Juan100205/IOTPROYECTOFINAL3CORTE/wiki/2.5.-Esquemático-de-Hardware.md

# 2.5. Esquemático de hardware

## 2.5.1. Lista de componentes

| # | Componente | Variable / función | Interfaz | Alimentación | Justificación |
|---|---|---|---|---|---|
| 1 | ESP32 DevKit V1 (WROOM-32, CP2102, 30 pines) | Procesamiento, WiFi y servidor web | — | USB 5 V → regulador 3,3 V | Doble núcleo Xtensa LX6 hasta 240 MHz y WiFi 802.11 b/g/n integrado [8], [23] |
| 2 | HC-SR04 | Nivel por ultrasonido | GPIO digital + ISR | **5 V (VIN)** | Sensor de nivel de bajo costo, validado en sistemas IoT de agua en zonas rurales [35], [36] |
| 3 | MD-PS002 + HX710B | Nivel por presión hidrostática | Serie de 2 hilos (24 bits) | 3,3 V | Segunda fuente de nivel, con un principio físico distinto (§[2.3.2](2.3.-Desarrollo-Teórico-Modular)) |
| 4 | DS18B20 sumergible | Temperatura del agua | 1-Wire | 3,3 V + pull-up de 4,7 kΩ | Encapsulado impermeable y resolución de 12 bits (0,0625 °C) [36] |
| 5 | DHT11 | Temperatura y HR del aire | Digital propietario | 3,3 V | Bajo costo; su HR alimenta el cálculo de $e_a$ [9] |
| 6 | BMP280 (opcional) | Presión atmosférica | I2C 0x76/0x77 [29] | 3,3 V | Aporta el término de presión de la evaporación (§2.3.4) |
| 7 | Fotoresistencia (LDR) + resistencia de divisor | Radiación / luminosidad relativa | ADC1 (GPIO34) | 3,3 V | Proxy de bajo costo de la radiación solar |
| 8 | OLED SSD1306 128×64 | Visualización in situ | I2C 0x3C [29] | 3,3 V | Legible a pleno sol y sin retroiluminación |
| 9 | LEDs verde, amarillo y rojo + 3 resistencias de 220 Ω | Estado del sistema | GPIO | — | Semáforo reconocible por cualquier persona |
| 10 | Buzzer activo | Alarma sonora | GPIO | 3,3 V | Alarma física exigida por el enunciado |
| 11 | Pulsador | Silenciar la alarma in situ | GPIO + ISR, pull-up interno | — | Acción local sin depender de la red |
| 12 | Resistencias de 1 kΩ y 2 kΩ | Divisor en el ECHO | — | — | Baja 5 V a ≈3,3 V para proteger el GPIO26 [8] |

## 2.5.2. Tabla de interconexión (pinout)

En la placa, el número después de la "D" es el número de GPIO. Los GPIO 16 y 17 aparecen rotulados como **RX2** y **TX2**.

| Componente | Pin del componente | GPIO ESP32 | Nota |
|---|---|---|---|
| OLED SSD1306 | SDA / SCK | 21 / 22 | Bus I2C compartido |
| BMP280 | SDA / SCL | 21 / 22 | Mismo bus I2C; se detecta en 0x76 o 0x77 |
| HC-SR04 | TRIG | 25 | Salida |
| HC-SR04 | ECHO | 26 | **Por el divisor de 1 kΩ / 2 kΩ**; ISR `CHANGE` |
| HX710B (MD-PS002) | OUT (DT) / SCK | 32 / 33 | OUT con `INPUT_PULLUP`: si se desconecta, queda en "sin dato" |
| DHT11 | DATA | 4 | |
| DS18B20 | DATA | 27 | Pull-up de 4,7 kΩ a 3,3 V |
| Fotoresistencia | Punto medio del divisor | 34 | ADC1, solo entrada, atenuación de 11 dB (0–3,3 V) |
| LED verde / amarillo / rojo | Ánodo, por 220 Ω | 16 (RX2) / 17 (TX2) / 19 | |
| Buzzer | + | 23 | Conexión directa (activo) |
| Botón | Un terminal (el otro a GND) | 18 | ISR `FALLING`, antirrebote de 250 ms |

**Pines evitados a propósito:** 0, 2, 12 y 15 (pines de arranque, *strapping*) y todo el **ADC2**, que no puede usarse mientras el WiFi está activo [8].

## 2.5.3. Esquemático de conexión

```mermaid
flowchart LR
  subgraph ESP["ESP32 DevKit V1"]
    V33["3V3"]
    VIN["VIN 5V"]
    GND["GND"]
    G21["GPIO21 SDA"]
    G22["GPIO22 SCL"]
    G25["GPIO25"]
    G26["GPIO26"]
    G32["GPIO32"]
    G33["GPIO33"]
    G4["GPIO4"]
    G27["GPIO27"]
    G34["GPIO34 ADC1"]
    G16["GPIO16 RX2"]
    G17["GPIO17 TX2"]
    G19["GPIO19"]
    G23["GPIO23"]
    G18["GPIO18"]
  end

  OLED["OLED SSD1306"] --- G21 & G22
  BMP["BMP280"] --- G21 & G22
  HC["HC-SR04"] -- "TRIG" --- G25
  HC -- "ECHO" --> DIV["Divisor 1k / 2k"] --> G26
  HC -- "VCC" --- VIN
  HX["MD-PS002 + HX710B"] -- "OUT" --- G32
  HX -- "SCK" --- G33
  DHT["DHT11"] --- G4
  DS["DS18B20"] --- G27
  DS -. "pull-up 4,7k" .- V33
  LDR["LDR + resistencia"] --- G34
  LV["LED verde + 220"] --- G16
  LA["LED amarillo + 220"] --- G17
  LR["LED rojo + 220"] --- G19
  BZ["Buzzer"] --- G23
  BT["Botón a GND"] --- G18
```

> **Pendiente del equipo:** reemplazar o complementar este diagrama con el esquemático gráfico exportado de Fritzing, EasyEDA o Wokwi del montaje v8. Esta tabla de pines es la fuente para dibujarlo. Los pines del primer corte (Arduino Uno) están en la [wiki del Challenge #1](https://github.com/LeMarsito02/IOTPROYECTOFINAL1CORTE/wiki/2.-Solución-Propuesta).

## 2.5.4. Consideraciones eléctricas

- **Niveles lógicos.** El ESP32 trabaja a 3,3 V y sus GPIO no toleran 5 V [8]. El único sensor alimentado a 5 V es el HC-SR04, porque su transmisor lo necesita. Su ECHO pasa por el divisor $V_{out} = 5\,\text{V}\cdot\frac{2\,\text{k}\Omega}{1\,\text{k}\Omega+2\,\text{k}\Omega} = 3{,}33\,\text{V}$.
- **Corriente por los LEDs.** Con 220 Ω y un LED rojo (≈2 V): $I = (3{,}3-2)/220 \approx 5{,}9\,\text{mA}$, dentro de la capacidad de un GPIO [8].
- **I2C.** La OLED y el BMP280 comparten el bus a 3,3 V. Los módulos traen resistencias de pull-up integradas [29]. El firmware escanea el bus al arrancar e informa por Serial las direcciones encontradas.
- **Tara del MD-PS002.** Hay que encender con la manguera fuera del agua. Las 15 primeras lecturas definen el "0 cm" (§2.3.2b).

## 2.5.5. Montaje físico

El nodo se integra en una carcasa de **MDF de 3 mm cortada con láser** (≈ 150 × 110 × 56 mm). Cada elemento queda donde cumple su función: la OLED y el panel solar en la tapa, visibles desde arriba; los LEDs y el botón al frente; el HC-SR04 en la base, apuntando al agua; y la ventilación en tres caras, para que el calor de la electrónica no altere el DHT11 ni el BMP280. Diseño, cotas y criterios de fabricación en la [sección 2.8](2.8.-Diseño-Mecánico-Carcasa-y-Empaque).

| Nodo WaterGuard v9 en su carcasa | Nodo en su empaque |
|---|---|
| **Figura 1.** Nodo WaterGuard v9 ensamblado en la carcasa de MDF: OLED y panel solar en la tapa; LEDs de estado, botón de silencio y rejilla de ventilación al frente.\* | **Figura 2.** El nodo en su empaque, con el inserto, el cable USB y el manual de usuario.\* |

\* Fotos reales mejoradas con Gemini ([sección 9](9.-Uso-de-Herramientas-de-Inteligencia-Artificial)). Los textos impresos en la caja no son especificaciones válidas ([2.8.4](2.8.-Diseño-Mecánico-Carcasa-y-Empaque)).
