Juan100205/IOTPROYECTOFINAL3CORTE/wiki/2.1.-Restricciones-de-Diseño.md

# 2.1. Restricciones de diseño identificadas

Las restricciones salen de tres fuentes: el enunciado del Challenge #2, el contexto de la Sabana Centro [1]–[4] y las limitaciones reales del hardware disponible. Cada una tiene una decisión de diseño asociada, con la que se puede verificar en las pruebas ([Configuración experimental y resultados](3.-Configuración-Experimental,-Resultados-y-Análisis)).

## 2.1.1. Técnicas

| ID | Restricción | Fuente | Decisión de diseño |
|---|---|---|---|
| T1 | Microcontrolador embebido, **no Raspberry Pi** (Challenge #2; en la v9 la reemplaza T12) | Enunciado, restricción 1 | ESP32 DevKit V1 (WROOM-32): doble núcleo, WiFi integrado, ADC de 12 bits [8] |
| T2 | La medición debe ejecutarse en una **ISR o en un hilo distinto al principal** | Enunciado, restricción 1 | ISR del pin ECHO + 3 tareas FreeRTOS en el núcleo 1; el `loop()` solo atiende la web |
| T3 | **Alarma física** y visualización en tiempo real en el dispositivo | Enunciado, restricción 2 | LEDs verde/amarillo/rojo, buzzer, OLED SSD1306 de 2 páginas y botón de silencio |
| T4 | Tablero en **servidor web embebido**, conectado a la WLAN de la Alcaldía | Enunciado, restricción 3 | `WebServer` HTTP en el puerto 80 del propio ESP32; mDNS `waterguard.local` |
| T5 | Acceso **solo a dispositivos autorizados de la WLAN** | Enunciado, restricción 3 | 3 capas: WPA2, filtro de subred con lista blanca opcional y login SHA-256 con sesión atada a IP |
| T6 | **Sin MQTT** (Challenge #2; en la v9 la reemplaza T13) | Enunciado, restricción 3 | API REST propia (`/api/estado`, `/api/historial`, `/api/alarma`) consultada por *polling* cada 2 s |
| T7 | El tablero debe mostrar **valor actual, histórico reciente, notificaciones** y permitir **desactivar alarmas** | Enunciado, requisitos mínimos | Histórico circular de 15 min, registro de 25 eventos, botón silenciar/rearmar |
| T8 | La WLAN puede **no tener salida a internet** | Contexto rural | Página autocontenida: sin CDN ni librerías externas; gráficas en `<canvas>` |
| T9 | Lógica de **3,3 V** del ESP32 y **ADC2 inutilizable con WiFi activo** | Manual técnico [8] | Divisor 1 kΩ/2 kΩ en el ECHO de 5 V; fotoresistencia en el GPIO34 (ADC1); se evitan los pines de arranque 0, 2, 12 y 15 |
| T10 | El MD-PS002 entrega **milivoltios** (puente de Wheatstone) | Hoja de datos del sensor | Etapa de amplificación HX710B/HX711 de 24 bits |
| T11 | Tolerancia a **fallas de sensores** | Robustez del servicio | Fuentes redundantes de nivel, normalización sobre los sensores disponibles, estados `DEGRADADO` y `ERROR` |
| T12 | Microcontrolador + **Raspberry Pi como Gateway IoT**; medición y **transmisión** en ISR o hilos (Challenge #3) | Enunciado, restricción 1 | Raspberry Pi 5 como Gateway; tarea FreeRTOS `tMQTT` en el núcleo 0 para la transmisión |
| T13 | **MQTT** nodo ↔ Gateway y Gateway ↔ nube | Enunciado, restricción 2 | Mosquitto en la Raspberry Pi; MQTT sobre WebSockets con TLS hacia LeMarTek Cloud (ThingsBoard) [56], [60] |
| T14 | Datos **almacenados en una BD local antes** de la plataforma IoT | Enunciado, restricción 1 | SQLite con reenvío diferido desde la base y alerta crítica si una escritura falla ([2.2.0](2.2.-Arquitectura-Propuesta)) |
| T15 | Tablero **global**, accesible desde cualquier parte de Colombia solo para usuarios autorizados | Enunciado, restricción 4 | LeMarTek Cloud con usuarios por rol, doble factor y túnel de Cloudflare |
| T16 | Módulo de **IA** con uso justificado | Enunciado, restricción 5 | Claude con salida estructurada y respaldo estadístico local |

## 2.1.2. Económicas

| ID | Restricción | Decisión |
|---|---|---|
| E1 | El reto pide un sistema de **bajo costo** | Sensores de prototipado rápido (HC-SR04, DHT11, DS18B20, BMP280); el ESP32 cuesta menos que un Arduino con módulo WiFi externo |
| E2 | Replicable en muchos puntos (tanques veredales) | Sin licencias ni servicios en la nube: el tablero no tiene costo recurrente |
| E3 | Presupuesto estudiantil | Banco de pruebas con materiales reciclados (nevera de icopor, papel aluminio, bombillo halógeno, ventilador) |
| E4 | Carcasa y empaque de bajo costo (Challenge #3) | Carcasa en MDF de 3 mm cortado con láser (COP 35.000) en lugar de impresión 3D, y caja de cartón (COP 10.000) ([2.8](2.8.-Diseño-Mecánico-Carcasa-y-Empaque)) |

El detalle de costos está en [Modelo de negocio](2.7.-Modelo-de-Negocio).

## 2.1.3. Regulatorias y de seguridad

| ID | Restricción | Decisión |
|---|---|---|
| R1 | Uso de la banda ICM de **2,4 GHz**, de uso libre en Colombia según la Resolución 105 de 2020 de la Agencia Nacional del Espectro (ANE) [62] | El ESP32 opera en modo estación IEEE 802.11 b/g/n [23] y no emite en bandas licenciadas |
| R2 | **Gestión del riesgo** municipal (Ley 1523 de 2012 [30]) y **uso eficiente del agua** (Ley 373 de 1997 [31]) | El sistema entrega información para decidir racionamientos; **no** acciona válvulas por sí solo, la decisión queda en la autoridad |
| R3 | Protección de datos (Ley 1581 de 2012 [32]) | El sistema no almacena datos personales; solo guarda la IP de quien accede, en memoria volátil, como registro de seguridad |
| R4 | Acceso restringido al tablero | Se siguen RFC 6265 [25] (cookie `HttpOnly`), FIPS 180-4 [26] (SHA-256) y las recomendaciones de OWASP ASVS [28] |

## 2.1.4. De espacio y de instalación

- El nodo debe caber junto a un tanque doméstico o comunitario. El HC-SR04 va en la tapa (mide desde arriba) y la manguera del MD-PS002 llega al fondo.
- Distancia mínima de medición del HC-SR04: ≈2 cm (zona ciega). Por eso el firmware descarta lecturas por debajo de 2 cm y por encima de 400 cm.
- Parámetro `ALTURA_TANQUE = 100 cm` en el prototipo. En campo se ajusta a la geometría real.
- La carcasa del nodo mide **≈ 150 × 110 × 56 mm**. El HC-SR04 sale por la base (2 orificios de Ø 17 mm) para medir hacia el agua, y la ventilación va en tres caras para que el calor interno no altere el DHT11 ni el BMP280 ([2.8.2](2.8.-Diseño-Mecánico-Carcasa-y-Empaque)).

## 2.1.5. De escalabilidad

- Un nodo = un punto de almacenamiento. Varios nodos pueden convivir en la misma WLAN, cada uno con su propio tablero y nombre mDNS.
- La API JSON permite, a futuro, que un agregador municipal consulte varios nodos sin rediseñar el firmware (ver [Conclusiones](5.-Conclusiones,-Retos-del-Desarrollo,-Trabajo-Futuro-y-Referencias), trabajo futuro).
- La memoria RAM limita el histórico a 180 muestras (15 min cada 5 s). Guardar más requeriría una tarjeta SD o memoria flash externa.

## 2.1.6. Temporales

- Entrega de la documentación: **28 de septiembre de 2026**. Sustentación: **29 de septiembre de 2026**.
- El prototipo debe mostrar los eventos en minutos, no en días. Por eso los umbrales de descenso (1 y 3 %/min) están **escalados** al banco de pruebas y se documentan como parámetros a recalibrar en campo ([Desarrollo teórico](2.3.-Desarrollo-Teórico-Modular) §2.3.3).
- La v8 se construyó sobre la v7 del primer corte para no perder la lógica ya validada.
- **Challenge #3:** entrega de la wiki el **9 de noviembre de 2026** y sustentación el **10 de noviembre**. Con ≈ 7 h de impresión por carcasa no había margen para reimprimir, y por eso se cambió a corte láser, con el que una iteración cabe en el mismo día ([Acta #2](7.1.-Actas-de-Reunión-y-Evaluación)).

## 2.1.7. Ambientales

| ID | Restricción | Decisión |
|---|---|---|
| A1 | Reducir el impacto ambiental de la carcasa del prototipo | MDF (fibra de madera) en lugar de termoplásticos de origen fósil (PETG/ASA). El MDF lleva resinas aglomerantes, así que se presenta como una opción de menor impacto, no como 100 % biodegradable |
| A2 | Empaque reciclable | Caja de cartón corrugado tipo *mailer* con inserto del mismo material |
| A3 | Exposición a la humedad junto al tanque | El MDF no es resistente al agua: la carcasa va sobre el tanque, no dentro de él, y en producción se sella o se cambia a ASA ([2.8.5](2.8.-Diseño-Mecánico-Carcasa-y-Empaque)) |
