Juan100205/IOTPROYECTOFINAL3CORTE/wiki/6.-Anexos.md

# 6. Anexos

## Anexo A. Código fuente documentado

**WaterGuard v9 (Challenge #3):**

| Carpeta / archivo | Contenido |
|---|---|
| [`codigo/WaterGuard_v9/`](https://github.com/Juan100205/IOTPROYECTOFINAL3CORTE/tree/main/codigo/WaterGuard_v9) | Firmware v9 del ESP32: v8 + tarea `tMQTT`, cola offline, LWT, comandos e IA |
| [`codigo/gateway/waterguard_gw.py`](https://github.com/Juan100205/IOTPROYECTOFINAL3CORTE/blob/main/codigo/gateway/waterguard_gw.py) | Servicio del Gateway: MQTT local → validación → SQLite (con alerta por falla) → nube, e hilo de IA |
| [`codigo/gateway/basedatos.py`](https://github.com/Juan100205/IOTPROYECTOFINAL3CORTE/blob/main/codigo/gateway/basedatos.py) | Esquema y consultas de SQLite |
| [`codigo/gateway/plataforma.py`](https://github.com/Juan100205/IOTPROYECTOFINAL3CORTE/blob/main/codigo/gateway/plataforma.py) | Conexión MQTT con LeMarTek Cloud (ThingsBoard) o Ubidots, y RPC de la alarma |
| [`codigo/gateway/ia_claude.py`](https://github.com/Juan100205/IOTPROYECTOFINAL3CORTE/blob/main/codigo/gateway/ia_claude.py) | Módulo de IA: base estadística y Claude con salida estructurada |
| [`codigo/gateway/config.py`](https://github.com/Juan100205/IOTPROYECTOFINAL3CORTE/blob/main/codigo/gateway/config.py) · [`waterguard.env.ejemplo`](https://github.com/Juan100205/IOTPROYECTOFINAL3CORTE/blob/main/codigo/gateway/waterguard.env.ejemplo) | Configuración del Gateway |
| [`codigo/gateway/simulador_nodo.py`](https://github.com/Juan100205/IOTPROYECTOFINAL3CORTE/blob/main/codigo/gateway/simulador_nodo.py) | Simulador del ESP32 para probar sin hardware |
| [`codigo/gateway/pruebas/`](https://github.com/Juan100205/IOTPROYECTOFINAL3CORTE/tree/main/codigo/gateway/pruebas) | Pruebas automatizadas (P3) |
| [`codigo/raspberry/`](https://github.com/Juan100205/IOTPROYECTOFINAL3CORTE/tree/main/codigo/raspberry) | SD autoconfigurable (cloud-init), Mosquitto con ACL y servicio `systemd` |

**Versiones anteriores:**

- Firmware v8 (ESP32): [`WaterGuard_v8.ino`](https://github.com/Juan100205/IOTPROYECTOFINAL3CORTE/blob/main/codigo/WaterGuard_v8/WaterGuard_v8.ino). Cada módulo tiene su bloque de comentarios con el propósito y las decisiones de diseño.
- Firmware v7 (Arduino Uno, primer corte): [`WaterGuard_v7.ino`](https://github.com/Juan100205/IOTPROYECTOFINAL3CORTE/blob/main/codigo/WaterGuard_v7/WaterGuard_v7.ino). El código v7 comentado completo está en el [Anexo A de la wiki del Challenge #1](https://github.com/LeMarsito02/IOTPROYECTOFINAL1CORTE/wiki/6.-Anexos).

### Mapa de módulos del firmware v8

| Módulo | Funciones | Documentado en |
|---|---|---|
| Configuración | Constantes de red, pines y umbrales | [2.3.7](2.3.-Desarrollo-Teórico-Modular), [2.5](2.5.-Esquemático-de-Hardware) |
| ISR | `isrEcho`, `isrBoton` | [2.4.3](2.4.-Diagramas-UML) |
| Sensores | `medirDistanciaUnaVez`, `medirDistancia`, `leerHX710B`, `tareaSensores` | [2.3.2](2.3.-Desarrollo-Teórico-Modular), [2.4.5](2.4.-Diagramas-UML) |
| Analítica | `agregarNivel`, `calcularDescenso`, `presionSaturacion`, `calcularEvaporacion`, `calcularIRH`, `detectarAnomalia`, `calcularEstado`, `tareaAnalitica` | [2.3](2.3.-Desarrollo-Teórico-Modular), [2.4.6](2.4.-Diagramas-UML) |
| Salidas | `actualizarOLED`, `tareaSalidas` | [2.4.7](2.4.-Diagramas-UML) |
| Seguridad | `sha256Hex`, `igualesTiempoConstante`, `crearSesion`, `buscarSesion`, `ipBloqueada`, `clienteEnRedLocal`, `filtroRed`, `autorizado` | [2.2.4](2.2.-Arquitectura-Propuesta), [2.6.2](2.6.-Estándares-de-Ingeniería) |
| Web | `handleLoginPost`, `handleEstado`, `handleHistorial`, `handleAlarma`, `LOGIN_HTML`, `DASH_HTML` | Anexo B |
| Red | `conectarWiFi`, `revisarWiFi` | [2.2](2.2.-Arquitectura-Propuesta) |

## Anexo B. API REST del tablero

Todas las rutas pasan por `filtroRed()`. Las marcadas con 🔒 exigen además una sesión válida.

| Método | Ruta | Descripción | Respuesta |
|---|---|---|---|
| GET | `/login` | Formulario de ingreso | HTML |
| POST | `/login` | `usuario`, `clave` | 302 a `/` con cookie, o a `/login?e=1` (clave errada) o `?e=2` (IP bloqueada) |
| POST | `/logout` | Cierra la sesión | `{"ok":true}` |
| GET 🔒 | `/` | Tablero | HTML autocontenido con `<canvas>` |
| GET 🔒 | `/api/estado` | Estado, IRH, evaporación, DPV, descenso, reglas, sensores, valores y eventos | JSON |
| GET 🔒 | `/api/historial` | 180 muestras (paso de 5 s) de nivel, tAgua, tAmb, hum, pres, lum, evap, irh y colAgua | JSON |
| POST 🔒 | `/api/alarma` | `accion=silenciar` o `accion=rearmar` | `{"sil":true/false}` |

## Anexo C. Formato del log CSV (v8)

| Columna | Unidad | Descripción |
|---|---|---|
| `LOG` | — | Marcador para filtrar las líneas |
| `millis` | ms | Tiempo desde el arranque |
| `nivel`, `nivelUS`, `nivelP` | % | Nivel fusionado, por ultrasonido y por presión |
| `tAgua`, `tAmb` | °C | Temperatura del agua y del aire |
| `humedad` | % | Humedad relativa |
| `presion` | hPa | Presión atmosférica |
| `luminosidad` | % | Lectura relativa de la LDR |
| `evap` | 0-100 | Índice de evaporación |
| `dpv` | kPa | Déficit de presión de vapor |
| `descenso` | %/min | Tasa de descenso (positivo = baja) |
| `irh` | 0-100 | Índice de Riesgo Hídrico |
| `anomalias` | 0-4 | Contador de anomalías |
| `estado` | 0-4 | 0 NORMAL, 1 ALERTA, 2 CRITICO, 3 DEGRADADO, 4 ERROR |

## Anexo D. Calibración del MD-PS002

1. Encender con la manguera fuera del agua (tara automática).
2. Anotar `HX crudo` en el aire y con la punta sumergida a una profundidad conocida *H* (cm).
3. Calcular `HX_CUENTAS_POR_KPA = (crudo_sumergido − crudo_aire) / (H × 0,0980665)` y cargar el valor en el firmware.

## Anexo E. Material del primer corte

El diccionario de variables de la v7, el changelog v1–v7, el glosario y el detalle del análisis K-Means están en la [wiki del Challenge #1](https://github.com/LeMarsito02/IOTPROYECTOFINAL1CORTE/wiki/6.-Anexos).

## Anexo F. Librerías utilizadas

| Librería | Uso en el firmware | Referencia |
|---|---|---|
| U8g2 (`U8x8lib.h`) | Pantalla OLED SSD1306 en modo texto | [42] |
| DHT sensor library + Adafruit Unified Sensor | Lectura del DHT11 | [43], [45] |
| Adafruit BMP280 Library | Presión atmosférica | [44] |
| OneWire + DallasTemperature | DS18B20 en conversión no bloqueante | [46], [47] |
| mbedTLS (incluida en el núcleo ESP32) | SHA-256 de la clave del tablero | [48] |
| `WiFi`, `WebServer`, `ESPmDNS`, `Wire` (núcleo Arduino-ESP32) | Red, servidor HTTP, mDNS e I2C | [41] |
| HX710B | Sin librería: protocolo de 2 hilos implementado a mano en `leerHX710B()` | — |

## Anexo G. Plantillas de corte de la carcasa (MDF de 3 mm)

| Versión | Archivos | Lámina | Caja resultante |
|---|---|---|---|
| v1 | [`.af`, `.pdf`, `.svg`](https://github.com/Juan100205/IOTPROYECTOFINAL3CORTE/tree/main/diseno/carcasa-mdf/v1) | 350 × 500 mm | 150 × 110 × 53 mm |
| **v2.0 (fabricada)** | [`.af`, `.pdf`](https://github.com/Juan100205/IOTPROYECTOFINAL3CORTE/tree/main/diseno/carcasa-mdf/v2.0) | 245 × 350 mm | 150 × 110 × 56 mm |
| Impresión 3D (descartada) | [OpenSCAD y STL](https://github.com/Juan100205/IOTPROYECTOFINAL3CORTE/tree/main/diseno/carcasa-impresa-3d) | — | Base 158 × 112 × 38 mm y tapa 165 × 119 × 6 mm. Se descartó porque el plástico se deforma con el calor ([2.8.1](2.8.-Diseño-Mecánico-Carcasa-y-Empaque)) |

**Convenciones de la plantilla:** rojo = corte, azul = grabado. El `.af` es la fuente editable (Affinity) y el `.pdf` es el archivo que se envía a la cortadora láser. Diseño, cotas y criterios DFM en la [sección 2.8](2.8.-Diseño-Mecánico-Carcasa-y-Empaque).

## Anexo H. Diagramas en imagen (PNG)

Cada diagrama de la wiki exportado en alta resolución, para presentaciones, el video o el informe.

| # | Diagrama | Sección | Imagen |
|---|---|---|---|
| 1 | Meta del Challenge #3 (v8 → v9) | 0.2 | [`01-plan-meta-v9.png`](https://github.com/Juan100205/IOTPROYECTOFINAL3CORTE/blob/main/assets/diagramas/01-plan-meta-v9.png) |
| 2 | Cronograma (Gantt) | 0.8 | [`02-plan-cronograma-gantt.png`](https://github.com/Juan100205/IOTPROYECTOFINAL3CORTE/blob/main/assets/diagramas/02-plan-cronograma-gantt.png) |
| 3 | Ecosistema v9 de tres capas | 2.2.0 | [`03-arquitectura-ecosistema-v9.png`](https://github.com/Juan100205/IOTPROYECTOFINAL3CORTE/blob/main/assets/diagramas/03-arquitectura-ecosistema-v9.png) |
| 4 | Almacenamiento con verificación y alerta crítica | 2.2.0 | [`04-arquitectura-alerta-bd.png`](https://github.com/Juan100205/IOTPROYECTOFINAL3CORTE/blob/main/assets/diagramas/04-arquitectura-alerta-bd.png) |
| 5 | Bloques de hardware | 2.2.1 | [`05-arquitectura-bloques-hardware.png`](https://github.com/Juan100205/IOTPROYECTOFINAL3CORTE/blob/main/assets/diagramas/05-arquitectura-bloques-hardware.png) |
| 6 | Bloques de software | 2.2.2 | [`06-arquitectura-bloques-software.png`](https://github.com/Juan100205/IOTPROYECTOFINAL3CORTE/blob/main/assets/diagramas/06-arquitectura-bloques-software.png) |
| 7 | Flujo de datos extremo a extremo | 2.2.3 | [`07-arquitectura-flujo-datos.png`](https://github.com/Juan100205/IOTPROYECTOFINAL3CORTE/blob/main/assets/diagramas/07-arquitectura-flujo-datos.png) |
| 8 | Máquina de estados | 2.3.6 | [`08-teorico-maquina-estados.png`](https://github.com/Juan100205/IOTPROYECTOFINAL3CORTE/blob/main/assets/diagramas/08-teorico-maquina-estados.png) |
| 9 | Casos de uso | 2.4.1 | [`09-uml-casos-de-uso.png`](https://github.com/Juan100205/IOTPROYECTOFINAL3CORTE/blob/main/assets/diagramas/09-uml-casos-de-uso.png) |
| 10 | Clases (estructuras y módulos) | 2.4.2 | [`10-uml-clases.png`](https://github.com/Juan100205/IOTPROYECTOFINAL3CORTE/blob/main/assets/diagramas/10-uml-clases.png) |
| 11 | Secuencia: medición del HC-SR04 por ISR | 2.4.3 | [`11-uml-secuencia-hcsr04-isr.png`](https://github.com/Juan100205/IOTPROYECTOFINAL3CORTE/blob/main/assets/diagramas/11-uml-secuencia-hcsr04-isr.png) |
| 12 | Secuencia: login y consulta del tablero | 2.4.4 | [`12-uml-secuencia-login-tablero.png`](https://github.com/Juan100205/IOTPROYECTOFINAL3CORTE/blob/main/assets/diagramas/12-uml-secuencia-login-tablero.png) |
| 13 | Actividad: tarea de sensores | 2.4.5 | [`13-uml-actividad-tarea-sensores.png`](https://github.com/Juan100205/IOTPROYECTOFINAL3CORTE/blob/main/assets/diagramas/13-uml-actividad-tarea-sensores.png) |
| 14 | Actividad: tarea de analítica | 2.4.6 | [`14-uml-actividad-tarea-analitica.png`](https://github.com/Juan100205/IOTPROYECTOFINAL3CORTE/blob/main/assets/diagramas/14-uml-actividad-tarea-analitica.png) |
| 15 | Actividad: tarea de salidas | 2.4.7 | [`15-uml-actividad-tarea-salidas.png`](https://github.com/Juan100205/IOTPROYECTOFINAL3CORTE/blob/main/assets/diagramas/15-uml-actividad-tarea-salidas.png) |
| 16 | Estados: sistema y alarma | 2.4.8 | [`16-uml-estados-sistema-alarma.png`](https://github.com/Juan100205/IOTPROYECTOFINAL3CORTE/blob/main/assets/diagramas/16-uml-estados-sistema-alarma.png) |
| 17 | Despliegue | 2.4.9 | [`17-uml-despliegue.png`](https://github.com/Juan100205/IOTPROYECTOFINAL3CORTE/blob/main/assets/diagramas/17-uml-despliegue.png) |
| 18 | Esquemático de conexión | 2.5.3 | [`18-esquematico-conexion.png`](https://github.com/Juan100205/IOTPROYECTOFINAL3CORTE/blob/main/assets/diagramas/18-esquematico-conexion.png) |
