Juan100205/IOTPROYECTOFINAL3CORTE/wiki/Referencias.md

# Referencias (formato IEEE)

La numeración es única para toda la wiki. Cada dato bibliográfico se verificó contra Crossref, IEEE Xplore o el repositorio de la institución. En los artículos se cita el DOI y no enlaces de sesión temporales.

## Contexto del reto

[1] Ministerio de Ambiente y Desarrollo Sostenible, "Gobierno confirma inicio del fenómeno de El Niño y alerta sobre su alcance," Minambiente, Bogotá, Colombia, Jun. 2026. [En línea]. Disponible: https://www.minambiente.gov.co/gobierno-confirma-inicio-del-fenomeno-de-el-nino-y-alerta-sobre-su-alcance/

[2] Caracol Radio, "Fenómeno del Niño: los municipios en Cundinamarca con mayor riesgo de desabastecimiento de agua," Caracol Radio Bogotá, Sección Nacional, 16 Jun. 2026. [En línea]. Disponible: https://caracol.com.co/2026/06/16/fenomeno-del-nino-los-municipios-en-cundinamarca-con-mayor-riesgo-de-desabastecimiento-de-agua/

[3] Infobae, "Fenómeno de El Niño en Colombia: estos son los 16 escenarios de riesgo que podría vivir Bogotá," Infobae Colombia, Sección Medio Ambiente, 8 Jul. 2026. [En línea]. Disponible: https://www.infobae.com/colombia/2026/07/08/fenomeno-de-el-nino-en-colombia-estos-son-los-16-escenarios-de-riesgo-que-podria-vivir-bogota/

[4] Gobernación de Cundinamarca, "Plan de Contingencia para el Fenómeno de El Niño," Unidad Administrativa Especial para la Gestión del Riesgo de Desastres (UAEGRD), Bogotá, Colombia, Inf. Técnico, 2026. [En línea]. Disponible: https://www.cundinamarca.gov.co/wcm/connect/107cf680-7a33-47d6-8f65-0d534e1de1e2/PLAN+DE+CONTIGENCIA+FEN%C3%93MENO+EL+NI%C3%91O.pdf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

## IoT, fusión de datos y hardware

[5] M. Terán, J. Aranda, H. Carrillo, D. Mendez y C. Parra, "IoT-based system for indoor location using Bluetooth Low Energy," en *2017 IEEE Colombian Conf. Commun. Comput. (COLCOM)*, Cartagena, Colombia, 16–18 Ago. 2017, pp. 1–6, doi: 10.1109/ColComCon.2017.8088211.

[6] B. Khaleghi, A. Khamis, F. O. Karray y S. N. Razavi, "Multisensor data fusion: A review of the state-of-the-art," *Inf. Fusion*, vol. 14, no. 1, pp. 28–44, Ene. 2013, doi: 10.1016/j.inffus.2011.08.001.

[7] A. Zanella, N. Bui, A. Castellani, L. Vangelista y M. Zorzi, "Internet of Things for smart cities," *IEEE Internet Things J.*, vol. 1, no. 1, pp. 22–32, Feb. 2014, doi: 10.1109/JIOT.2014.2306328.

[8] Espressif Systems, *ESP32 Technical Reference Manual*, Versión 5.8, Shanghái, China, Jul. 2026. [En línea]. Disponible: https://documentation.espressif.com/esp32_technical_reference_manual_en.pdf. [Accedido: 28 Sep. 2026].

[20] H. Durrant-Whyte y T. C. Henderson, "Multisensor data fusion," en *Springer Handbook of Robotics*, 2.ª ed., B. Siciliano y O. Khatib, Eds. Cham, Suiza: Springer, 2016, pp. 867–896, doi: 10.1007/978-3-319-32552-1_35.

[33] Espressif Systems, "FreeRTOS (IDF)," en *ESP-IDF Programming Guide (ESP32)*, v6.1. [En línea]. Disponible: https://docs.espressif.com/projects/esp-idf/en/stable/esp32/api-reference/system/freertos_idf.html. [Accedido: 28 Sep. 2026].

[35] R. Bogdan, C. Paliuc, M. Crisan-Vida, S. Nimara y D. Barmayoun, "Low-cost Internet-of-Things water-quality monitoring system for rural areas," *Sensors*, vol. 23, no. 8, art. 3919, Abr. 2023, doi: 10.3390/s23083919.

[36] M. Espinoza Ortiz, J. P. Apún Molina, S. I. Belmonte Jiménez, J. Herrera Barrientos, H. J. Peinado Guevara y A. Santamaria Miranda, "Development of low-cost IoT system for monitoring piezometric level and temperature of groundwater," *Sensors*, vol. 23, no. 23, art. 9364, Nov. 2023, doi: 10.3390/s23239364.

[41] Espressif Systems, *Arduino-ESP32 Documentation*, v3.3.12. [En línea]. Disponible: https://docs.espressif.com/projects/arduino-esp32/en/latest/. [Accedido: 28 Sep. 2026].

## Fórmulas y modelos matemáticos

[9] R. G. Allen, L. S. Pereira, D. Raes y M. Smith, *Crop Evapotranspiration: Guidelines for Computing Crop Water Requirements*, FAO Irrigation and Drainage Paper 56. Roma, Italia: FAO, 1998. [En línea]. Disponible: https://www.fao.org/4/x0490e/x0490e00.htm

[11] X. Huang, C. J. Abolt y K. E. Bennett, "Brief communication: Effects of different saturation vapor pressure calculations on simulated surface-subsurface hydrothermal regimes at a permafrost field site," *The Cryosphere Discuss.* [Preprint], 2023, doi: 10.5194/tc-2023-8.

[12] L. E. Verduzco-Grajeda, A. Corrales-Suastegui, E. G. Pavia, D. Ávalos-Cueva e I. Velázquez, "Estimación del déficit de presión de vapor en regiones vitivinícolas en México utilizando modelos climáticos," *Rev. Politécnica Aguascalientes*, vol. 7, año 5, May. 2026. [En línea]. Disponible: http://revistapolitecnicaags.upa.edu.mx/wp-content/uploads/2026/07/V7108.pdf

[13] L. A. Serio, "Desarrollo y validación de un modelo del sistema suelo-planta-atmósfera para la estimación de la evapotranspiración real del cultivo de maíz," Tesis doctoral, Fac. Cs. Exactas y Naturales, Univ. de Buenos Aires, Buenos Aires, Argentina, 2015. [En línea]. Disponible: https://hdl.handle.net/20.500.12110/tesis_n5872_Serio

[40] M. J. Pretorius e I. Loots, "Practical empirical estimation of evaporation for mining and industrial water balances: application to a South African process dam," *Water Pract. Technol.*, vol. 21, no. 2, pp. 522–539, Feb. 2026, doi: 10.2166/wpt.2026.210.

## Indicadores

[14] A. G. Romero Díaz y D. I. Parrado Torres, "Evaluación del riesgo al recurso hídrico en la Cuenca Ubaté-Suárez, enmarcado en los lineamientos conceptuales y metodológicos para la Evaluación Regional del Agua – ERA," Trabajo de grado, Ingeniería Ambiental, Univ. Distrital Francisco José de Caldas, Bogotá, Colombia, 2016. [En línea]. Disponible: http://hdl.handle.net/11349/4603

[15] A. I. Monterroso-Rivas y J. D. Gómez-Díaz, "Impacto del cambio climático en la evapotranspiración potencial y periodo de crecimiento en México," *Terra Latinoam.*, vol. 39, art. e774, 2021, doi: 10.28940/terra.v39i0.774.

[16] J. G. Pech de la Portilla, M. R. Chan Chi, C. H. López May, J. A. Martín Vela y J. E. Pech Lara, "Implementación de un indicador de nivel de agua para riego automatizado en huertos de traspatio utilizando IoT en tanques de ferrocemento," *Cienc. Lat. Rev. Cient. Multidiscip.*, vol. 8, no. 5, pp. 7058–7078, 2024, doi: 10.37811/cl_rcm.v8i5.14123.

## Factores ambientales

[17] J. L. Bravo, M. M. Nava y A. Muhlia, "Relaciones entre la magnitud del valor máximo de ozono, la radiación solar y la temperatura ambiente en la Zona Metropolitana de la Ciudad de México," *Rev. Int. Contam. Ambient.*, vol. 16, no. 2, pp. 45–54, 2000, doi: 10.20937/RICA.32542.

[18] M. A. Ruiz-Ochoa, J. S. Torres-Corredor, Y. A. Vargas-Corredor y L. P. Orduz-Amaya, "Variabilidad climática (precipitación, temperatura y humedad relativa) para la gestión hídrica del departamento del Casanare, Colombia," *Inf. Tecnol.*, vol. 34, no. 5, pp. 47–60, 2023, doi: 10.4067/S0718-07642023000500047.

[19] M. Guallpa y R. Célleri, "Efecto de la estimación de la presión atmosférica sobre el cálculo de niveles de agua y caudales," *Aqua-LAC*, vol. 5, no. 2, pp. 56–68, 2013, doi: 10.29104/phi-aqualac/2013-v5-2-06.

## Monitoreo, detección y análisis de datos

[10] C. M. Bishop, *Pattern Recognition and Machine Learning*. Nueva York, NY, EE. UU.: Springer, 2006.

[21] J. E. Rodríguez Tocagón, "Modelos estadísticos para la detección de patrones en medio ambiente y economía: aplicación de gráficos de control funcional para monitorizar series temporales meteorológicas y climáticas para la detección de anomalías," Trabajo de integración curricular, Fac. Ciencias, Escuela Politécnica Nacional, Quito, Ecuador, 2022. [En línea]. Disponible: http://bibdigital.epn.edu.ec/handle/15000/23053

[22] S. A. Valdés Rabelo, "Detección de anomalías en series de tiempo de datos del agua utilizando un enfoque de aprendizaje profundo," Tesis de maestría, Fac. Ingeniería, Univ. Autónoma de Chihuahua, Chihuahua, México, 2020. [En línea]. Disponible: http://repositorio.uach.mx/322/

[37] M. J. C. S. Reis, "Lightweight signal processing and edge AI for real-time anomaly detection in IoT sensor networks," *Sensors*, vol. 25, no. 21, art. 6629, Oct. 2025, doi: 10.3390/s25216629.

## Estándares

[23] *IEEE Standard for Information Technology—Telecommunications and Information Exchange between Systems—Local and Metropolitan Area Networks—Specific Requirements—Part 11: Wireless LAN Medium Access Control (MAC) and Physical Layer (PHY) Specifications*, IEEE Std 802.11-2020, Feb. 2021, doi: 10.1109/IEEESTD.2021.9363693.

[24] R. Fielding, M. Nottingham y J. Reschke, Eds., "HTTP Semantics," RFC 9110, Jun. 2022, doi: 10.17487/RFC9110.

[25] A. Barth, "HTTP State Management Mechanism," RFC 6265, Abr. 2011, doi: 10.17487/RFC6265.

[26] National Institute of Standards and Technology, "Secure Hash Standard (SHS)," FIPS PUB 180-4, Gaithersburg, MD, EE. UU., Ago. 2015, doi: 10.6028/NIST.FIPS.180-4.

[27] *Internet of Things (IoT) — Reference Architecture*, ISO/IEC 30141:2024, 2.ª ed., Ago. 2024.

[28] OWASP Foundation, *OWASP Application Security Verification Standard 4.0.3*, Oct. 2021. [En línea]. Disponible: https://github.com/OWASP/ASVS/raw/v4.0.3/4.0/OWASP%20Application%20Security%20Verification%20Standard%204.0.3-en.pdf

[29] NXP Semiconductors, "I2C-bus specification and user manual," UM10204, Rev. 7.0, Oct. 2021. [En línea]. Disponible: https://www.nxp.com/docs/en/user-guide/UM10204.pdf

[34] ABET Engineering Accreditation Commission, *Criteria for Accrediting Engineering Programs, 2025–2026*. Baltimore, MD, EE. UU.: ABET, 2025. [En línea]. Disponible: https://www.abet.org/accreditation/accreditation-criteria/criteria-for-accrediting-engineering-programs-2025-2026/

[39] S. Cheshire y M. Krochmal, "Multicast DNS," RFC 6762, Feb. 2013, doi: 10.17487/RFC6762.

## Normativa colombiana y viabilidad

[30] Congreso de la República de Colombia, *Ley 1523 de 2012, por la cual se adopta la política nacional de gestión del riesgo de desastres y se establece el Sistema Nacional de Gestión del Riesgo de Desastres*, Diario Oficial n.º 48.411, 24 Abr. 2012. [En línea]. Disponible: https://www.funcionpublica.gov.co/eva/gestornormativo/norma.php?i=47141

[31] Congreso de la República de Colombia, *Ley 373 de 1997, por la cual se establece el programa para el uso eficiente y ahorro del agua*, Diario Oficial n.º 43.058, 11 Jun. 1997. [En línea]. Disponible: https://www.funcionpublica.gov.co/eva/gestornormativo/norma.php?i=342

[32] Congreso de la República de Colombia, *Ley Estatutaria 1581 de 2012, por la cual se dictan disposiciones generales para la protección de datos personales*, Diario Oficial n.º 48.587, 18 Oct. 2012. [En línea]. Disponible: https://www.funcionpublica.gov.co/eva/gestornormativo/norma.php?i=49981

[38] A. M. Flórez Laiseca, P. A. Loaiza Trejos y S. Ospina Reyes, "Gestión ambiental empresarial apoyada en IoT: Evaluación económica y social en el Quindío, Colombia," *Palermo Business Review*, no. 32, pp. 100–116, Dic. 2025. [En línea]. Disponible: https://www.palermo.edu/negocios/cbrs/pdf/pbr32/pbr-32-06.pdf

---

**Vigencia de las fuentes:** 29 de las 53 referencias son de 2021–2026. Las 7 librerías de software ([42]–[48]) se citan en su versión vigente, consultada el 28 de septiembre de 2026. Las fuentes clásicas (FAO-56, Bishop, Khaleghi, Zanella, Durrant-Whyte) se mantienen porque son las referencias de base de las fórmulas y métodos usados.

## Librerías de software del firmware

[42] O. Kraus, "U8g2: Library for monochrome displays, version 2," GitHub. [En línea]. Disponible: https://github.com/olikraus/u8g2. [Accedido: 28 Sep. 2026].

[43] Adafruit Industries, "DHT sensor library," GitHub. [En línea]. Disponible: https://github.com/adafruit/DHT-sensor-library. [Accedido: 28 Sep. 2026].

[44] Adafruit Industries, "Adafruit BMP280 Library," GitHub. [En línea]. Disponible: https://github.com/adafruit/Adafruit_BMP280_Library. [Accedido: 28 Sep. 2026].

[45] Adafruit Industries, "Adafruit Unified Sensor Driver," GitHub. [En línea]. Disponible: https://github.com/adafruit/Adafruit_Sensor. [Accedido: 28 Sep. 2026].

[46] P. Stoffregen, "OneWire Library," GitHub. [En línea]. Disponible: https://github.com/PaulStoffregen/OneWire. [Accedido: 28 Sep. 2026].

[47] M. Burton, "Arduino Library for Maxim Temperature Integrated Circuits (DallasTemperature)," GitHub. [En línea]. Disponible: https://github.com/milesburton/Arduino-Temperature-Control-Library. [Accedido: 28 Sep. 2026].

[48] Mbed TLS Project, "Mbed TLS," GitHub. [En línea]. Disponible: https://github.com/Mbed-TLS/mbedtls. [Accedido: 28 Sep. 2026].

## Fuentes de precios (modelo de negocio)

[49] YoRobotics, "Tienda de componentes electrónicos," Bogotá, Colombia. [En línea]. Disponible: https://yorobotics.co. [Accedido: 28 Sep. 2026].

[50] YoRobotics, "Sensor presión absoluta MD-PS002 15-100PSI 150KPA." [En línea]. Disponible: https://yorobotics.co/producto/sensor-presion-absoluta-md-ps002-15-100psi-150kpa-arduino/. [Accedido: 28 Sep. 2026].

[51] YoRobotics, "Módulo conversor análogo digital HX711 24 bits." [En línea]. Disponible: https://yorobotics.co/producto/conversor-hx711-modulo-24-bits-arduino-celda-carga-nuevo-2/. [Accedido: 28 Sep. 2026].

[52] YoRobotics, "Sensor humedad temperatura DHT11 con PCB." [En línea]. Disponible: https://yorobotics.co/producto/sensor-humedad-temperatura-dht11-dht-11-con-pcb-arduino/. [Accedido: 28 Sep. 2026].

[53] Electronilab, "Protoboard adhesiva MB102 830 puntos 16.5 cm x 5.5 cm," Bogotá, Colombia. [En línea]. Disponible: https://electronilab.co/tienda/protoboard-adhesiva-mb102-830-puntos-16-5cm-x-5-5cm/. [Accedido: 28 Sep. 2026].

## Diseño mecánico (Challenge #3)

[54] *Fibreboards — Specifications — Part 5: Requirements for dry process boards (MDF)*, EN 622-5:2009, European Committee for Standardization (CEN), Bruselas, Bélgica, 2009.

[55] *Degrees of protection provided by enclosures (IP Code)*, IEC 60529:1989+AMD1:1999+AMD2:2013, International Electrotechnical Commission, Ginebra, Suiza, 2013.

## Ecosistema IoT, IA y metodología (Challenge #3)

[56] A. Banks y R. Gupta, Eds., *MQTT Version 3.1.1*, OASIS Standard, Oct. 2014. [En línea]. Disponible: https://docs.oasis-open.org/mqtt/mqtt/v3.1.1/mqtt-v3.1.1.html

[57] P. Lewis *et al.*, "Retrieval-augmented generation for knowledge-intensive NLP tasks," en *Advances in Neural Information Processing Systems (NeurIPS)*, vol. 33, 2020, pp. 9459–9474.

[58] K. Beck, *Test-Driven Development: By Example*. Boston, MA, EE. UU.: Addison-Wesley, 2002.

[59] J. Knapp, J. Zeratsky y B. Kowitz, *Sprint: How to Solve Big Problems and Test New Ideas in Just Five Days*. Nueva York, NY, EE. UU.: Simon & Schuster, 2016.

[60] I. Fette y A. Melnikov, "The WebSocket protocol," RFC 6455, Dic. 2011, doi: 10.17487/RFC6455.

[61] element14 Community, "How much is the Raspberry Pi 5?," Raspberry Pi 5 FAQ. [En línea]. Disponible: https://community.element14.com/products/raspberry-pi/f/raspberry-pi-5-faq/53723/how-much-does-the-raspberry-pi-5-cost. [Accedido: 10 Nov. 2026].

## Normativa del espectro y tecnologías del ecosistema v9

[62] Agencia Nacional del Espectro (ANE), *Resolución 105 de 2020, por medio de la cual se planea y atribuye el espectro radioeléctrico en Colombia* (Título 4 y Anexo 1: bandas de uso libre, incluida 2400–2483,5 MHz), modificada por la Resolución 469 de 2020. [En línea]. Disponible: https://normograma.mintic.gov.co/mintic/compilacion/docs/resolucion_ane_0105_2020.htm

[63] ThingsBoard, Inc., *ThingsBoard Community Edition Documentation*, v4.2. [En línea]. Disponible: https://thingsboard.io/docs/. [Accedido: 10 Nov. 2026].

[64] The PostgreSQL Global Development Group, *PostgreSQL Documentation*. [En línea]. Disponible: https://www.postgresql.org/docs/. [Accedido: 10 Nov. 2026].

[65] Docker, Inc., *Docker Compose Documentation*. [En línea]. Disponible: https://docs.docker.com/compose/. [Accedido: 10 Nov. 2026].

[66] R. A. Light, "Mosquitto: server and client implementation of the MQTT protocol," *J. Open Source Softw.*, vol. 2, no. 13, p. 265, 2017, doi: 10.21105/joss.00265.

[67] Cloudflare, Inc., *Cloudflare Tunnel*, Cloudflare Zero Trust Documentation. [En línea]. Disponible: https://developers.cloudflare.com/cloudflare-one/connections/connect-networks/. [Accedido: 10 Nov. 2026].

[68] SQLite Consortium, "Write-Ahead Logging," *SQLite Documentation*. [En línea]. Disponible: https://www.sqlite.org/wal.html. [Accedido: 10 Nov. 2026].

[69] Eclipse Foundation, *Eclipse Paho MQTT Python Client (paho-mqtt 2.2)*. [En línea]. Disponible: https://pypi.org/project/paho-mqtt/. [Accedido: 10 Nov. 2026].

[70] Anthropic, *Claude API Documentation: Structured outputs and Messages API*. [En línea]. Disponible: https://platform.claude.com/docs. [Accedido: 10 Nov. 2026].

[71] N. O'Leary, "PubSubClient: A client library for the Arduino that provides support for MQTT," GitHub. [En línea]. Disponible: https://github.com/knolleary/pubsubclient. [Accedido: 10 Nov. 2026].

[72] B. Blanchon, "ArduinoJson: JSON library for embedded C++," GitHub. [En línea]. Disponible: https://github.com/bblanchon/ArduinoJson. [Accedido: 10 Nov. 2026].
