Juan100205/IOTPROYECTOFINAL3CORTE/wiki/2.7.-Modelo-de-Negocio.md

# 2.7. Modelo de negocio y viabilidad

## 2.7.1. Lean Canvas

| Bloque | Contenido |
|---|---|
| **Problema** | 1) Las redes del IDEAM y la CAR no cubren los tanques veredales ni los reservorios pequeños [2], [4]. 2) Nadie cruza en tiempo real el nivel con el clima, así que no se distingue consumo, fuga o evaporación. 3) Las alertas llegan tarde para racionar a tiempo |
| **Segmentos de clientes** | Alcaldías de la provincia Sabana Centro, CAR Cundinamarca, acueductos veredales y Juntas de Acción Comunal (JAC), distritos de riego |
| **Propuesta de valor** | "Sepa cuánta agua le queda y qué tan rápido la está perdiendo, en el sitio y en su celular, sin internet ni mensualidades." |
| **Solución** | Nodo ESP32 con nivel redundante, índice de evaporación e IRH; alerta física y tablero local seguro |
| **Canales** | Convenios con la Gobernación y la CAR dentro de los planes de contingencia de El Niño [4]; demostraciones a las JAC; instalación con técnicos locales |
| **Fuentes de ingreso** | 1) Venta del nodo instalado. 2) Contrato anual de mantenimiento y calibración. 3) A futuro, agregador regional por suscripción municipal |
| **Estructura de costos** | Componentes (BOM), carcasa (MDF en el prototipo; sellada o en ASA en producción), empaque, instalación, calibración en sitio, soporte, servidor de la plataforma en la nube y consumo de la API de IA |
| **Métricas clave** | Número de nodos activos, % de alertas confirmadas en sitio (precisión), anticipación media de la alerta frente al desabastecimiento, disponibilidad del nodo |
| **Ventaja diferencial** | Fusión multisensor en el borde, redundancia del nivel, cero dependencia de la nube y costo de un orden de magnitud menor que una estación institucional |

## 2.7.2. Costo del prototipo (BOM)

Precios de referencia consultados el **28 de septiembre de 2026** en tiendas colombianas: YoRobotics, Bogotá [49]–[52], salvo la protoboard, que es de Electronilab [53]. No incluyen el envío.

| Componente | Referencia comercial | Cant. | Precio unitario (COP) | Subtotal (COP) |
|---|---|---|---|---|
| ESP32 DevKit V1 | Tarjeta desarrollo ESP32 WiFi CP2102 30 pines | 1 | 52.000 | 52.000 |
| HC-SR04 | Sensor ultrasonido HC-SR04 | 1 | 14.000 | 14.000 |
| MD-PS002 + amplificador | Sensor de presión MD-PS002 (13.500) + módulo HX711 24 bits (12.000)* | 1 | 25.500 | 25.500 |
| DS18B20 sumergible | Sonda DS18B20 impermeable de 2 m | 1 | 22.000 | 22.000 |
| DHT11 | Sensor DHT11 con PCB | 1 | 12.500 | 12.500 |
| BMP280 | Módulo GY-BMP280 3,3 V | 1 | 15.000 | 15.000 |
| OLED SSD1306 128×64 | Pantalla OLED 0,96" I2C | 1 | 22.000 | 22.000 |
| Fotoresistencia, LEDs, resistencias, buzzer, botón | Kit de resistencias (220 Ω, 1k, 10k, 100k) + 10 LEDs 5 mm (12.000); paquete de 20 LDR 5528 (12.000); buzzer (3.900); pulsador 6×6 mm (2.400) | — | — | 30.300 |
| Protoboard y cables | Protoboard MB102 de 830 puntos (13.900) + 3 paquetes de jumpers de 20 cm (3 × 4.500). El banco de pruebas usó materiales reciclados (icopor y aluminio) | — | — | 27.400 |
| **Subtotal electrónica** | | | | **220.700** |
| Carcasa | MDF de 3 mm cortado con láser, plantilla v2.0 ([2.8](2.8.-Diseño-Mecánico-Carcasa-y-Empaque))† | 1 | 35.000 | 35.000 |
| Empaque | Caja de cartón corrugado tipo *mailer* con inserto† | 1 | 10.000 | 10.000 |
| **Total prototipo (producto empacado)** | | | | **265.700** |

\* La tienda no ofrecía el HX710B suelto, así que se cotizó el HX711, que es funcionalmente equivalente (24 bits, mismo protocolo de 2 hilos) y compatible con el firmware. El buzzer disponible es pasivo; en ese caso se configura `BUZZER_PASIVO = true`.

† Costo de fabricación reportado por el equipo (noviembre de 2026). La Raspberry Pi 5 del Gateway no se incluye: es infraestructura compartida que puede atender varios nodos.

**Lectura del costo.** Un nodo completo, con carcasa y empaque, cuesta **≈ COP 265.700**. El ESP32 representa el 20 %, los sensores el 33 % y la carcasa y el empaque el 17 %. Pasar de impresión 3D a MDF cortado con láser dejó la carcasa en COP 35.000 ([2.8.1](2.8.-Diseño-Mecánico-Carcasa-y-Empaque)). Comprando por volumen y usando una PCB propia, el costo por nodo baja. En producción habría que sumar el sellado de la carcasa (o una en ASA), la alimentación solar y la instalación ([2.7.3](#273-viabilidad)).

## 2.7.3. Viabilidad

- **Técnica:** demostrada con el prototipo funcional ([sección 3](3.-Configuración-Experimental,-Resultados-y-Análisis)).
- **Económica:** el software no tiene licencias: ThingsBoard CE, Mosquitto y SQLite son libres, y la plataforma corre en un servidor propio (LeMarTek Cloud). El único costo recurrente variable es la API de IA, del orden de USD 0,02 por análisis; con un análisis cada 15 min son ≈ USD 1,9 por Gateway al día, que se puede bajar espaciando los análisis periódicos sin perder los inmediatos ante una alerta. Si no hay presupuesto o Internet, el Gateway usa la base estadística sin costo. El costo del nodo lo dominan componentes de prototipado de bajo precio, y en producción se reduciría con una PCB propia.
- **Social:** un análisis costo-beneficio social de tecnologías IoT para la gestión del agua en el Quindío (Colombia) reportó un Valor Actual Neto Social positivo y un índice costo-beneficio mayor que 2, impulsado por el ahorro de agua y la mejora en la calidad de vida [38]. Es un precedente nacional para un despliegue similar en los municipios de Sabana Centro en riesgo [2].
- **Escalamiento:** el paso de prototipo a producto requiere una carcasa resistente a la humedad (MDF sellado o ASA, con meta IP54 según IEC 60529 [55]), alimentación solar, sensores de grado industrial (por ejemplo, un transductor de presión sumergible en lugar del MD-PS002) y HTTPS ([Trabajo futuro](5.-Conclusiones,-Retos-del-Desarrollo,-Trabajo-Futuro-y-Referencias)).

## 2.7.4. Costos de producción

El prototipo se costeó con precios al detal ([2.7.2](#272-costo-del-prototipo-bom)). Para producir en serie, el equipo estimó el costo por nodo en un **lote de 50 unidades**. Los supuestos van en la última columna para que se puedan ajustar con cotizaciones reales.

| Concepto | Prototipo (COP) | Producción, lote de 50 (COP) | Supuesto |
|---|---|---|---|
| Electrónica: ESP32, sensores, OLED, LEDs, buzzer, botón | 193.300 | 154.600 | −20 % por compra al por mayor |
| Montaje: protoboard y jumpers → PCB propia y conectores | 27.400 | 20.000 | PCB fabricada en lote |
| Carcasa en MDF de 3 mm | 35.000 | 40.000 | Se suma el sellado (laca) contra la humedad |
| Empaque *mailer* con inserto | 10.000 | 10.000 | Igual |
| Ensamble, calibración y prueba en el banco | — | 25.000 | 1 h de técnico por nodo |
| **Costo por nodo** | **265.700** | **249.600** | |

**Gateway municipal** (Raspberry Pi 5 de 4 GB, fuente oficial de 27 W, microSD y disipador activo): costo estimado de **COP 600.000**, incluida la configuración de la SD autoconfigurable. La placa tiene un precio de referencia internacional de USD 60 [61] y el kit completo se debe cotizar en Colombia antes de vender. Un Gateway atiende varios nodos de la misma zona.

**Costo de operación:**
- **Módulo de IA:** del orden de USD 0,02 por análisis. Con un análisis cada hora más los inmediatos ante alertas, son unos 800 análisis al mes por Gateway, ≈ USD 16 (≈ COP 64.000 con un supuesto de COP 4.000 por dólar). Con un análisis cada 15 min, el costo sube a ≈ USD 58 al mes, por eso se recomienda la frecuencia horaria en producción.
- **Plataforma:** LeMarTek Cloud corre en un servidor propio con software libre (ThingsBoard CE, Mosquitto, SQLite), sin licencias por dispositivo.

## 2.7.5. Comercialización y precios de venta (propuesta)

| Producto o servicio | Incluye | Precio de venta (COP) | Margen bruto |
|---|---|---|---|
| **Nodo WaterGuard instalado** | Nodo en carcasa MDF, sensores externos, instalación en el tanque y calibración del MD-PS002 | 450.000 | ≈ 45 % |
| **Gateway municipal** | Raspberry Pi 5 configurada, broker MQTT, base de datos local y módulo de IA | 850.000 | ≈ 29 % |
| **Suscripción LeMarTek Cloud + IA** | Tablero global, alarmas y notificaciones, usuarios por rol, IA y soporte remoto, hasta 10 nodos | 150.000 al mes por municipio | Cubre la API de IA y el servidor |
| **Mantenimiento en sitio** | Visita anual: recalibración, limpieza de sensores y revisión de la carcasa | 120.000 al año por nodo | — |

**Ejemplo para un municipio con 5 puntos de almacenamiento:**
- Inversión inicial: 5 × 450.000 + 850.000 = **COP 3.100.000**.
- Operación anual: 12 × 150.000 + 5 × 120.000 = **COP 2.400.000**.
- Para los **20 municipios en riesgo extremo** que identificó la CAR [2], la inversión inicial sería de ≈ **COP 62 millones**.

**Canales y uso:**
- **Compra pública:** alcaldías, Gobernación de Cundinamarca (UAEGRD) y CAR, dentro de los planes de contingencia de El Niño [4], mediante los procesos de contratación estatal (SECOP II).
- **Acueductos veredales y Juntas de Acción Comunal:** compra del nodo con la suscripción municipal compartida.
- **Distritos de riego y agroindustria:** el mismo nodo vigila los reservorios de riego.
- **Entrega como producto:** el nodo llega en su caja con el inserto, el cable USB y el manual ([2.8.4](2.8.-Diseño-Mecánico-Carcasa-y-Empaque)), listo para que un técnico local lo instale.

> Los precios de venta son una **propuesta del equipo** para validar con clientes reales. Los supuestos de costo están en la tabla 2.7.4.
