Juan100205/IOTPROYECTOFINAL3CORTE/wiki/0.-Plan-del-Challenge-3.md

# 0. Plan del Challenge #3: de WaterGuard v8 a v9

> **Página de trabajo interno.** Registra el punto de partida, la meta, lo que falta, las decisiones técnicas y el plan para cumplir el Challenge #3. Cuando el plan esté ejecutado, su contenido se reparte en las secciones definitivas de la wiki (2.1 a 9) y esta página se retira o queda como anexo.

**Fechas límite:** documentación (wiki) el **9 de noviembre de 2026** en MS Teams · sustentación el **10 de noviembre de 2026** a la 1:00 p. m. (3 min de pitch y 17 min de preguntas). Después de la entrega en Teams **la wiki no se puede modificar**.

---

## 0.1. Iniciamos con…

WaterGuard v8, el resultado del segundo corte:

| Componente | Estado actual (v8) |
|---|---|
| Nodo sensor | ESP32 DevKit V1 con HC-SR04 y MD-PS002 (nivel redundante), DS18B20, DHT11, BMP280 y LDR |
| Concurrencia | ISR y tres tareas FreeRTOS (`tSensores`, `tAnalitica`, `tSalidas`); el `loop()` solo atiende la web |
| Analítica en el borde | Índice de evaporación (Dalton/DPV), IRH, reglas de fusión multisensor y detección de anomalías |
| Alerta in situ | LEDs, buzzer, OLED y botón físico para silenciar |
| Tablero local | Servidor web embebido (`WebServer`) en la WLAN, con valor actual, historial y alertas; login con hash SHA-256 y sesión atada a IP; silenciar alarma vía `/api/alarma` |
| Comunicación | Solo HTTP en la WLAN. **Sin MQTT**, porque lo prohibía el enunciado del segundo corte |
| Persistencia | Historial reciente en RAM del ESP32; **no hay base de datos** |
| Nube / IA | No existen. El K-Means del primer corte fue un análisis offline |

## 0.2. Meta

WaterGuard v9 como **ecosistema IoT completo de tres capas**, con integración funcional demostrable de punta a punta:

> sensor → ESP32 (ISR/FreeRTOS) → **MQTT** → **Gateway** (Mosquitto + SQLite + procesamiento) → **MQTT** → **LeMarTek Cloud** (tablero global) → **módulo de IA (Claude)** → recomendación visible en los tableros local y global, y alarma silenciable desde cualquiera de ellos.

Además, la unidad física se presenta como **producto**: una **carcasa impresa en 3D** (diseñada para manufactura) que integra el ESP32, la Raspberry Pi y todos los circuitos, y el **diseño** de un empaque de cartón para su entrega. La validación se hace en un **banco de pruebas v2**, con más control y apoyado en simulación.

```mermaid
flowchart LR
  subgraph N["Capa 1: nodo sensor (ESP32)"]
    S[Sensores] --> T1[tSensores / ISR]
    T1 --> T2[tAnalitica<br/>IRH, evaporación, fusión]
    T2 --> T3[tSalidas<br/>LEDs, buzzer, OLED]
    T2 --> W[Tablero web local]
    T2 --> M[tMQTT<br/>nueva]
  end
  subgraph G["Capa 2: Gateway (PC → Raspberry Pi)"]
    B[(Mosquitto<br/>broker local)]
    P[Servicio Python<br/>procesamiento]
    D[(SQLite)]
    IA[Módulo IA<br/>Claude API]
    B <--> P
    P --> D
    D --> IA
    IA --> P
  end
  subgraph C["Capa 3: nube"]
    U[LeMarTek Cloud<br/>ThingsBoard: tablero global + alarmas]
  end
  M <-->|MQTT, WLAN| B
  P <-->|MQTT + TLS, Internet| U
```

## 0.3. Lo que hace falta (brecha v8 → v9)

| # | Requisito del Challenge #3 | v8 | Qué falta |
|---|---|---|---|
| R1 | Microcontrolador con medición y **transmisión** en ISR o hilos | Medición ✅ | Tarea FreeRTOS de transmisión MQTT |
| R2 | Raspberry Pi como Gateway IoT | ❌ | Gateway completo (ver decisión D1) |
| R3 | Datos almacenados en BD local antes de ir a la nube (SQLite) | ❌ | SQLite en el Gateway |
| R4 | MQTT dispositivo ↔ Gateway (Mosquitto) | ❌ | Cliente MQTT en ESP32 + broker Mosquitto |
| R5 | MQTT Gateway ↔ plataforma IoT en la nube (LeMarTek Cloud) | ❌ | Puente Gateway → LeMarTek Cloud |
| R6 | Notificación in situ | ✅ | Mantener; mostrar estado de conexión en OLED |
| R7 | Tablero local embebido | ✅ | Mostrar la recomendación de la IA |
| R8 | Tablero global accesible desde cualquier parte de Colombia, solo usuarios autorizados | ❌ | Dashboard LeMarTek Cloud con acceso autenticado |
| R9 | Notificaciones ante eventualidades | Parcial (local) | Eventos de LeMarTek Cloud (correo / Telegram) |
| R10 | Desactivar alarmas físicas desde el tablero | Solo local | Comando desde LeMarTek Cloud → Gateway → ESP32 |
| R11 | Módulo de IA (predicción, anomalías o recomendación) | ❌ | Módulo de IA en el Gateway con Claude API |
| R12 | Wiki con secciones 1–9, video ≤ 5 min, roles, declaración de IA, IEEE, compartir con `@juanmalk` | Base del 2.º corte | Actualizar todas las secciones a v9 |
| R13 | Acta de reunión y evaluación (rúbrica, 5 %) | ❌ | Actas por sesión de trabajo |

## 0.4. Decisiones tomadas

| ID | Tema | Decisión | Justificación |
|---|---|---|---|
| D1 | **Gateway: Raspberry Pi 5** | El Gateway se implementa en una **Raspberry Pi 5**. Mientras no esté disponible físicamente, se desarrolla en un PC con exactamente el mismo software (Mosquitto + Python 3 + SQLite) y luego se migra (T18). | Cumple la restricción técnica 1. El software es portable a Raspberry Pi OS, así que el desarrollo no se bloquea. |
| D2 | **Plataforma en la nube** | ~~Ubidots STEM~~ → **LeMarTek Cloud for IoT** (ThingsBoard CE autoalojado, publicado por túnel de Cloudflare; MQTT sobre WSS). El Gateway conserva Ubidots como alternativa configurable (`WG_PLATAFORMA`). | Plataforma propia del equipo: sin límites de un plan gratuito (dispositivos, variables, frecuencia), con alarmas, notificaciones y roles. Cumple la restricción 2 (MQTT Gateway ↔ nube). |
| D3 | **Proveedor de IA** | **API de Claude (Anthropic)** desde el Gateway, con el SDK oficial de Python (ratificado en el Acta #3). El código aísla al proveedor para poder cambiarlo. | Se combina con predicción local, prompts parametrizados y recuperación de contexto para que la IA no invente cifras (ver [2.2.0](2.2.-Arquitectura-Propuesta)). |
| D4 | **Equipo de dos personas** | El equipo es de dos personas (el enunciado permite "3 personas o según indique el docente"). | Los roles quedan en la sección 0.11 y en la sección 7. |
| D5 | **Carcasa y empaque** | ~~Carcasa impresa en 3D que integra ESP32, Raspberry Pi y circuitos; empaque solo en diseño.~~ **Reemplazada por D6.** | Presentar la solución como producto desplegable y reforzar el diseño ingenieril de la rúbrica. |
| D7 | **Tablero global** (Acta #3, 9 nov) | Tablero de **LeMarTek Cloud** (`https://iot.lemartek.cloud`) con alarmas, notificaciones, usuarios por rol y botones de la alarma. | Ya está desplegado y se usa desde cualquier navegador. |
| D8 | **Histórico y BD local** (Acta #3) | El histórico de la v8 vive 15 min en RAM. Se agrega **SQLite** en el Gateway, con verificación de cada escritura y alerta crítica si falla, antes de seguir llenando datos. | Cumple la restricción 1 (almacenar antes de transmitir) y evita subir datos que no quedaron en el histórico. |
| D6 | **Carcasa en MDF de 3 mm con corte láser** (Acta #2, 6 nov) | La carcasa del **nodo ESP32** se fabrica en MDF de 3 mm cortado con láser (plantillas v1 y v2.0). La Raspberry Pi 5 va por separado. El empaque de cartón sí se fabrica. | Economía (carcasa a COP 35.000 y caja a COP 10.000), tiempo (minutos de corte frente a ≈ 7 h de impresión), facilidad de fabricación y ensamble, y menor impacto ambiental. Ver [2.8](2.8.-Diseño-Mecánico-Carcasa-y-Empaque). |

## 0.5. Implementación en el ESP32 (firmware v9)

### En efectos prácticos va a funcionar así

* El nodo **sigue funcionando exactamente igual** que en v8: mide, calcula el IRH, alerta con LEDs, buzzer y OLED, y sirve el tablero local. Si se cae el WiFi o el Gateway, **la alerta local no se pierde**.
* Además, cada pocos segundos **envía sus mediciones e indicadores** al Gateway por MQTT, y avisa de inmediato cuando cambia el estado de alerta.
* Escucha **comandos**: si una autoridad silencia la alarma desde LeMarTek Cloud, el buzzer del tanque se apaga, aunque esa persona esté en otra ciudad.
* Recibe la **recomendación de la IA** que genera el Gateway y la muestra en el tablero local (y de forma resumida en la OLED).
* Si el nodo se desconecta o se apaga, el Gateway se entera solo (mensaje de "última voluntad", LWT) y lo reporta como nodo caído.

### En términos técnicos se debe implementar así

1. **Librería MQTT:** `PubSubClient` (Nick O'Leary) sobre `WiFiClient`, con `setBufferSize(1024)` porque el buffer por defecto (256 B) no alcanza para el JSON de telemetría. Alternativa evaluada: `esp-mqtt` de ESP-IDF, que publica con QoS 1 y reconecta sola, pero tiene una curva de integración mayor en el sketch actual.
2. **Nueva tarea `tMQTT`** (FreeRTOS, prioridad baja, 4–6 KB de pila). **Es la única que toca el cliente MQTT**, porque `PubSubClient` no es *thread-safe*. `tAnalitica` le entrega los datos por una **cola** (`xQueueSend`) con una estructura `Telemetria`; nunca llama a `publish()` directamente.
3. **Reconexión no bloqueante:** reintento con *backoff* (1 s → 2 s → … → 30 s máx.) y `setSocketTimeout` bajo, para que una caída del broker no congele la tarea ni afecte a la medición (que corre en otras tareas).
4. **Buffer offline:** si el broker no está disponible, las últimas *N* muestras se guardan en un buffer circular en RAM y se envían al reconectar. El campo `seq` permite al Gateway detectar huecos.
5. **Tópicos** (plan inicial; los implementados están en la [sección 2.2.0](2.2.-Arquitectura-Propuesta), con nodo = `nodo1`):

   | Tópico | Dirección | QoS | Retenido | Contenido |
   |---|---|---|---|---|
   | `telemetria` | ESP32 → GW | 0 | No | JSON con `seq`, nivel (US, hidrostático, fusionado), temperaturas, HR, presión, luz, evaporación e IRH |
   | `alerta` | ESP32 → GW | 1* | No | Cambio de estado (`NORMAL`/`PRECAUCION`/`CRITICO`), regla disparada |
   | `estado` | ESP32 → GW | 1* | Sí | `online` / `offline` (LWT), IP, *uptime*, RSSI, heap libre |
   | `cmd/alarma` | GW → ESP32 | 1 | No | `{"accion":"silenciar","origen":"ubidots"}` |
   | `ia/recomendacion` | GW → ESP32 | 1 | Sí | Texto corto y nivel de riesgo previsto |

   \* `PubSubClient` publica solo con QoS 0 (sí se suscribe con QoS 1). Para `alerta` se compensa repitiendo la publicación hasta recibir eco del Gateway en `estado`, o se migra a `esp-mqtt` si las pruebas lo justifican.
6. **Silenciar alarma unificado:** las tres fuentes (botón, tablero local y comando MQTT) llaman a una sola función `silenciarAlarma(origen)`, protegida con *mutex*, que además publica el nuevo estado para que los tres canales queden sincronizados.
7. **Seguridad en la WLAN:** usuario y contraseña MQTT por nodo y una ACL en Mosquitto (el nodo solo puede publicar en sus tópicos y leer `cmd/` e `ia/`). Las credenciales van en un `secrets.h` excluido del repositorio. **No se usa TLS dentro de la WLAN** (ver repercusiones); sí se usa entre el Gateway y LeMarTek Cloud.
8. **Marcas de tiempo:** el ESP32 envía `seq` y `millis()`. El Gateway sella la hora real al recibir, para no depender de NTP en la WLAN de la Alcaldía.

### Repercusiones técnicas

| Aspecto | Repercusión | Mitigación |
|---|---|---|
| Memoria (heap/pila) | Nueva tarea, cola, buffer MQTT de 1 KB y buffer offline | Medir `ESP.getFreeHeap()` y `uxTaskGetStackHighWaterMark()` y publicarlos en `estado` |
| Concurrencia | Tablero web (en `loop()`) y MQTT comparten la pila WiFi; `PubSubClient` no es reentrante | Un solo dueño del cliente (`tMQTT`), cola entre tareas y *mutex* en el estado de alarma |
| Disponibilidad | Si cae el Gateway o el WiFi no hay datos en la nube | La alerta local es autónoma; buffer offline y LWT para detectar la caída |
| Fiabilidad de entrega | QoS 0 puede perder alguna muestra de telemetría | Aceptable para telemetría periódica; el Gateway mide la pérdida con `seq` |
| Seguridad | Sin TLS en la WLAN, el tráfico MQTT local va en claro | Red cerrada de la Alcaldía, credenciales y ACL. TLS en el ESP32 costaría ~40 KB de heap y más latencia; se documenta como trabajo futuro |
| Energía y red | Publicar más seguido consume más y puede chocar con el límite de LeMarTek Cloud | Telemetría cada 5–10 s hacia el Gateway; el Gateway agrega y sube a LeMarTek Cloud con menor frecuencia |
| Compatibilidad | El tablero local v8 sigue igual | Solo se agrega un panel "Recomendación IA" y un indicador de conexión MQTT |

## 0.6. Gateway, nube e IA (siguientes bloques, resumen)

* **Gateway (PC → Raspberry Pi):**
  * Mosquitto 2.x con `allow_anonymous false`, `password_file` y ACL.
  * Servicio Python con `paho-mqtt` 2.x: se suscribe a `waterguard/+/#`, guarda todo en **SQLite** (modo WAL, tablas `telemetria`, `alertas`, `comandos` y `recomendaciones`), calcula agregados (promedios por ventana, tasa de descenso del nivel, % de pérdida por `seq`) y los publica en LeMarTek Cloud.
* **LeMarTek Cloud (implementado):** ThingsBoard CE en Docker sobre un servidor propio, publicado solo por un túnel de Cloudflare. El Gateway publica por MQTT sobre WebSockets con TLS (puerto 443) en `v1/devices/me/telemetry` y recibe por RPC las órdenes de silenciar o rearmar la alarma, que reenvía al ESP32. El tablero tiene indicadores, históricos, tarjeta de IA, alarmas con notificaciones, bitácora y botones de la alarma. El acceso es con usuarios por rol y doble factor, nunca con un enlace público.
* **IA (Claude):** enfoque híbrido.
  1. **Predicción local** con regresión lineal sobre el nivel de los últimos 30–60 min, que estima las horas hasta el umbral crítico.
  2. **Claude** recibe ese resumen numérico (nivel, tendencia, IRH, evaporación, alertas recientes) y redacta una **recomendación accionable** de racionamiento o protección para las autoridades.

  Solo se llama a la API ante un cambio de estado o cada 15 min, para controlar el costo. Si no hay Internet o la API falla, se usa una **recomendación por reglas** como respaldo. La clave de la API va en una variable de entorno, nunca en el repositorio. Se justifica en la wiki por qué se usa IA generativa y no solo reglas: la lógica de reglas ya existe en el borde, y la IA aporta la traducción a decisiones en lenguaje natural para no expertos.

## 0.7. Fases del proyecto

| Fase | Nombre | Objetivo | Ventana |
|---|---|---|---|
| **F0** | Planeación | Plan, definición de la Raspberry Pi 5 y requisitos | 3 nov |
| **F1** | Implementación de código | Firmware v9, Gateway, LeMarTek Cloud e IA funcionando de punta a punta | 4 – 7 nov |
| **F2** | Diseño y manufactura | Carcasa impresa en 3D que integra ESP32, Raspberry Pi y todos los circuitos (diseño para manufactura, impresión y ensamble) y **diseño** del empaque de cartón | 3 – 8 nov |
| **F3** | Banco de pruebas v2 y simulación | Banco con más control y acoples, simulación de los subsistemas y protocolo de pruebas v9 | 4 – 7 nov |
| **F4** | Verificación y correcciones | Verificar contra requisitos y rúbrica, corregir y volver a probar | 8 nov |
| **F5** | Video, documentación final y entrega | Wiki v9 completa, video ≤ 5 min y entrega en Teams | 7 – 9 nov |
| **F6** | Sustentación | Pitch de 3 min y demo | 10 nov |

### F2 en detalle: carcasa 3D (diseño para manufactura)

**Qué se busca:** una carcasa impresa en 3D en la que queden montados y protegidos el ESP32, la Raspberry Pi, los módulos (HX710B, convertidores, etc.), la alimentación y el cableado. Debe dejar bien ubicados los elementos que necesitan contacto con el exterior. Se diseña, se imprime y se ensambla.

**Criterios de diseño (DFM, *Design for Manufacturing*):**
* **Compartimentos:** uno para el nodo sensor (ESP32 + módulos) y otro para el Gateway (Raspberry Pi), separados para que el calor de la Raspberry Pi no altere la temperatura del aire medida y para que el diseño se pueda separar en dos cajas si el despliegue lo requiere.
* **Interfaz con el exterior:** ventana para la OLED; orificios para LEDs, buzzer y botón; rejilla ventilada y protegida del sol para DHT11 y BMP280; ventana para la LDR; HC-SR04 apuntando hacia el agua; prensaestopas o pasacables para DS18B20, la manguera del MD-PS002 y la alimentación; acceso al USB para reprogramar.
* **Fabricación:** paredes de ≥ 2 mm, holguras de encaje de 0,2–0,3 mm, voladizos ≤ 45° para evitar soportes, orientación de impresión definida, postes de montaje con insertos térmicos o tornillería M2,5 (Raspberry Pi) y M3, y tapa atornillada.
* **Material:** PETG o ASA para uso exterior (resisten mejor el calor y la radiación UV que el PLA). PLA solo para el prototipo de encaje.
* **Protección:** grado IP objetivo según IEC 60529 (por ejemplo IP54) como meta de diseño, documentado aunque no se certifique.
* **Raspberry Pi 5:** el compartimento se diseña con su plano mecánico oficial (placa de 85 × 56 mm, agujeros de montaje M2,5). Se deja espacio y flujo de aire para el disipador activo (Active Cooler), porque la Raspberry Pi 5 se calienta más que modelos anteriores, y acceso a su conector USB-C de alimentación (fuente oficial de 27 W).

**Entregables de manufactura:** archivos STEP/STL, planos con cotas, parámetros de impresión (material, capa, relleno, tiempo estimado), lista de tornillería e insertos, instrucciones de ensamble y fotos del ensamble final.

### F2 en detalle: empaque de cartón (solo diseño)

Diseño, **sin fabricación**, de una caja de cartón para entregar la unidad: troquel (*dieline*) basado en un estilo FEFCO (por ejemplo, 0427, tipo *mailer*) con dimensiones derivadas de la carcasa, inserto interno para inmovilizar la unidad y los sensores externos, y rotulado (identificación del producto, contenido, símbolos de manipulación según ISO 780). Se entregan el plano del troquel y un render o *mockup*.

### F3 en detalle: banco de pruebas v2 y simulación

* **Más control:** encendido del halógeno y velocidad del ventilador controlados (relé o PWM) para repetir los mismos escenarios; nivel de agua controlado con un recipiente graduado (y, si es posible, una bomba) para provocar descensos a una tasa conocida.
* **Acoples:** soportes fijos para cada sensor dentro de la cámara, para que las mediciones sean repetibles; montaje de la carcasa en el banco.
* **Referencias:** termómetro y regla graduada de referencia para comparar las lecturas.
* **Simulación:** firmware v9 en **Wokwi** contra un broker MQTT, y un **simulador de nodo en Python** que publica datos sintéticos (normales, sequía, anomalías) para probar el Gateway, LeMarTek Cloud y la IA sin depender del hardware. También permite **inyectar fallas** (caída del WiFi, del broker o de Internet).
* **Protocolo v9:** casos de prueba con criterio de aceptación y métricas (latencia sensor → LeMarTek Cloud, pérdida por `seq`, tiempo hasta alerta, tiempo de recuperación tras una caída, silenciar desde los tres canales).

## 0.8. Cronograma

```mermaid
gantt
  title WaterGuard v9 - Challenge 3
  dateFormat YYYY-MM-DD
  axisFormat %d-%b
  section F0 Planeacion
  Plan y Raspberry Pi 5               :f0, 2026-11-03, 1d
  section F1 Codigo
  Gateway Mosquitto + SQLite          :f1a, 2026-11-04, 1d
  Firmware v9 MQTT                    :f1b, 2026-11-04, 2d
  Puente LeMarTek Cloud + dashboard          :f1c, 2026-11-05, 2d
  Modulo IA (Claude)                  :f1d, 2026-11-06, 1d
  Migracion a Raspberry Pi            :f1e, 2026-11-06, 2d
  section F2 Diseno y manufactura
  Requisitos de la carcasa            :f2a, 2026-11-03, 2d
  CAD de la carcasa                   :f2b, 2026-11-04, 2d
  Revision DFM y prueba de encaje     :f2c, 2026-11-05, 2d
  Impresion 3D y ensamble             :f2d, 2026-11-06, 2d
  Diseno del empaque de carton        :f2e, 2026-11-07, 2d
  section F3 Pruebas
  Simulacion (Wokwi y nodo Python)    :f3a, 2026-11-04, 3d
  Banco de pruebas v2                 :f3b, 2026-11-05, 2d
  Protocolo y pruebas E2E             :f3c, 2026-11-06, 2d
  section F4 Verificacion
  Verificacion y correcciones         :f4, 2026-11-08, 1d
  section F5 Entrega
  Wiki v9                             :f5a, 2026-11-07, 3d
  Video                               :f5b, 2026-11-08, 1d
  Entrega en Teams                    :milestone, f5c, 2026-11-09, 0d
  section Actas
  Acta 1                              :milestone, a1, 2026-11-03, 0d
  Acta 2                              :milestone, a2, 2026-11-06, 0d
  Acta 3 (cierre)                     :milestone, a3, 2026-11-09, 0d
```

| Día | F1 Código | F2 Diseño y manufactura | F3 Pruebas | F4 / F5 / F6 |
|---|---|---|---|---|
| **Lun 3** | — | Requisitos de la carcasa | — | F0 + **Acta #1** |
| **Mar 4** | Gateway (Mosquitto, Python, SQLite) · firmware v9 MQTT | Requisitos · CAD | Simulador de nodo en Python | — |
| **Mié 5** | Firmware v9 (comandos, panel IA) · puente LeMarTek Cloud | CAD · revisión DFM | Simulación Wokwi · banco v2 | — |
| **Jue 6** | Dashboard y eventos LeMarTek Cloud · módulo IA · migración a Raspberry Pi | Prueba de encaje · impresión | Banco v2 · protocolo v9 | **Acta #2** (viernes 6, 2:00 p. m., virtual) |
| **Vie 7** | Ajustes de integración | Impresión · ensamble · empaque | Pruebas E2E en banco v2 | Wiki v9 |
| **Sáb 8** | — | Empaque · documentación de manufactura | — | Verificación y correcciones · video · wiki |
| **Dom 9** | — | — | — | **Acta #3** (2:00 p. m.) · revisión final · compartir con `@juanmalk` · **entrega** |
| **Lun 10** | — | — | — | Sustentación |

**Ruta crítica:** integración de punta a punta → pruebas E2E. En paralelo, la carcasa depende del tiempo de impresión, que se debe estimar en T22.

## 0.9. Lista de tareas

Estado: ⬜ pendiente · 🔄 en curso · ✅ terminada.

| ID | Fase | Tarea | Responsable | Depende de | Entregable | Fecha |
|---|---|---|---|---|---|---|
| T01 | F0 | Definir el modelo de Raspberry Pi para el Gateway | **Ambos** | — | Raspberry Pi 5 ✅ | 3 nov |
| T10 | F1 | Mosquitto: credenciales, ACL y puertos | **Santiago** | — | `mosquitto.conf`, ACL | 4 nov |
| T11 | F1 | Servicio Python: MQTT → SQLite (esquema, modo WAL) | **Santiago** | T10 | `codigo/gateway/` + BD | 4 nov |
| T12 | F1 | Firmware v9: tarea `tMQTT`, cola, LWT, buffer offline | **Santiago** | T10 | `codigo/WaterGuard_v9/WaterGuard_v9.ino` | 4–5 nov |
| T13 | F1 | Firmware v9: `cmd`, silenciar unificado, panel IA y estado de conexión | **Santiago** | T12 | Firmware v9 | 5 nov |
| T14 | F1 | Procesamiento en el Gateway (agregados, tasa de descenso, pérdida por `seq`) | **Santiago** | T11 | Módulo de procesamiento | 5 nov |
| T15 | F1 | Puente Gateway → LeMarTek Cloud (TLS) y comando de vuelta | **Santiago** | T14 | Datos en LeMarTek Cloud | 5 nov |
| T16 | F1 | Dashboard LeMarTek Cloud, eventos, notificaciones y acceso restringido | **Santiago** | T15 | Dashboard | 6 nov |
| T17 | F1 | Módulo IA: predicción local + Claude + respaldo por reglas | **Santiago** | T14 | Recomendación publicada | 6 nov |
| T18 | F1 | Migrar el Gateway a la Raspberry Pi (servicios al arranque) | **Santiago** | T01, T17 | Gateway en Raspberry Pi | 6–7 nov |
| T19 | F1 | Documentar el código de cada módulo | **Santiago** | T12–T17 | Código comentado + README | 8 nov |
| T20 | F2 | Requisitos de la carcasa: inventario y medidas de componentes, ubicación de sensores y puertos, ventilación | **Santiago** | T01 | Lista de requisitos y croquis | 3–4 nov |
| T21 | F2 | Plantillas de corte láser de la carcasa en MDF de 3 mm (v1 y v2.0) ✅ | **Santiago** | T20 | `diseno/carcasa-mdf/` | 7–9 nov |
| T22 | F2 | Revisión DFM para corte láser (espesor único, encastres de 3 mm, capas de corte y grabado) ✅ | **Santiago** | T21 | [2.8.3](2.8.-Diseño-Mecánico-Carcasa-y-Empaque) | 7–9 nov |
| T23 | F2 | Corte láser de la carcasa en MDF de 3 mm (reemplaza la impresión 3D) ✅ | **Juan José** | T22 | Carcasa cortada | 9 nov |
| T24 | F2 | Ensamble de circuitos en la carcasa y prueba funcional | **Santiago** | T23, T13 | Unidad ensamblada | 7 nov |
| T25 | F2 | Documentación de manufactura (STEP/STL, planos, parámetros, ensamble) | **Santiago** | T22 | Anexo de manufactura | 8 nov |
| T26 | F2 | Empaque de cartón tipo *mailer* con inserto (fabricado) ✅ | **Santiago** | T21 | Caja | 7–9 nov |
| T30 | F3 | Banco de pruebas v2: control de halógeno y ventilador, nivel controlado, **soporte para la carcasa MDF** y referencias | **Juan José** | — | Banco v2 | 5–9 nov |
| T31 | F3 | Simulación: Wokwi y simulador de nodo en Python con inyección de fallas | **Juan José** | T10 | Escenarios simulados | 4–6 nov |
| T32 | F3 | Protocolo de pruebas v9 (casos, criterios, métricas) | **Juan José** | — | Protocolo | 6 nov |
| T33 | F3 | Ejecución de pruebas E2E en banco v2 y registro de evidencias | **Juan José** | T16, T17, T30, T32 | Logs, capturas, fotos | 7 nov |
| T40 | F4 | Verificación contra requisitos R1–R13 y rúbrica | **Juan José** | T33 | Checklist | 8 nov |
| T41 | F4 | Corrección de defectos y nueva prueba | **Juan José** | T40 | Defectos cerrados | 8 nov |
| T50 | F5 | Wiki v9: secciones 1–9 (arquitectura, UML, tópicos, esquemático, carcasa y empaque, estándares, BOM, resultados, IA, roles) | **Ambos** | — | Wiki completa | 7–9 nov |
| T51 | F5 | Video ≤ 5 min con ambos en cámara | **Ambos** | T33 | Video en Teams | 8 nov |
| T52 | F5 | Revisión final, compartir con `@juanmalk`, .zip y entrega en Teams | **Ambos** | T50, T51 | Entrega | 9 nov |
| T53 | F6 | Pitch de 3 min (en inglés) y ensayo de la demo | **Ambos** | T52 | Pitch | 9 nov |

## 0.10. Reuniones y entregables por reunión

| Reunión | Fecha | Entregables que se revisan | Acta |
|---|---|---|---|
| **#1 Arranque** | Lun 3 nov | Plan del Challenge #3 · repositorio y wiki migrados · reparto inicial de tareas · Raspberry Pi 5 definida (T01) · arranque de T20 | [Acta #1](7.1.-Actas-de-Reunión-y-Evaluación) |
| **#2 Seguimiento** | Vie 6 nov | Integración de punta a punta funcionando (T10–T17) · Gateway en Raspberry Pi (T18) · carcasa con DFM revisado e impresa o en impresión (T20–T23) · banco v2 y simulación (T30–T31) · protocolo v9 (T32) · avance del empaque (T26) | [Acta #2](7.1.-Actas-de-Reunión-y-Evaluación) |
| **#3 Ensamblaje, pruebas y cierre** | Lun 9 nov, 2:00 p. m. | Entrega realizada (T52): wiki, video y .zip · unidad ensamblada (T24) · empaque diseñado (T26) · pitch y demo (T53) · evaluación final | [Acta #3](7.1.-Actas-de-Reunión-y-Evaluación) |

## 0.11. Asignación actual

| Integrante | Frente | Tareas asignadas |
|---|---|---|
| **Santiago Peña Beltrán** | Programación y manufactura | T10–T19 (firmware v9, Gateway, LeMarTek Cloud, IA, migración a Raspberry Pi, documentación del código) · T20–T22 y T24–T26 (diseño de la carcasa 3D, ensamble, documentación de manufactura, diseño del empaque) |
| **Juan José Riaño Zabaleta** | Banco de pruebas, simulación, pruebas, corrección e integración final | T23 (corte láser de la carcasa en MDF) · T30–T33 (banco v2, simulación, protocolo v9, pruebas E2E) · T40–T41 (verificación, corrección e integración final) |
| **Ambos** | Logística con el docente y documentación | T01 (Raspberry Pi 5, ✅ definida) · T50–T53 (wiki v9, video, entrega y pitch) · actas de reunión |

> **Carga:** el frente de Santiago concentra la ruta crítica (código y carcasa al mismo tiempo, del 4 al 7 de noviembre). Juan José puede apoyar con el simulador de nodo (T31) desde el 4 de noviembre, lo que permite probar el Gateway, LeMarTek Cloud y la IA sin esperar al firmware.
