Juan100205/IOTPROYECTOFINAL3CORTE/wiki/5.-Conclusiones,-Retos-del-Desarrollo,-Trabajo-Futuro-y-Referencias.md

## 5.1. Conclusiones

Water Guard demuestra que es posible construir, con hardware de bajo costo, un sistema IoT capaz de adquirir y combinar múltiples señales ambientales para generar indicadores de riesgo. Esta arquitectura coincide con el enfoque de sistemas IoT descrito por Terán et al., que organiza el sistema en módulos de sensado, procesamiento, comunicación y análisis [5]. Asimismo, Zanella et al. describen los sistemas IoT como conjuntos de dispositivos equipados con capacidades de procesamiento y comunicación que permiten integrar información de distintos elementos del entorno [7].

En Water Guard, las mediciones de nivel, temperatura del agua, temperatura y humedad ambiente y luminosidad se integran para calcular el IRH y el índice de evaporación potencial. En la v8 se suman la presión atmosférica y una segunda fuente de nivel por presión hidrostática, y el sistema publica todo en un tablero web embebido de acceso restringido, sin MQTT. La fusión de estas señales sigue el principio de combinar información proveniente de múltiples sensores para mejorar la confiabilidad y reducir la ambigüedad de los datos, uno de los beneficios identificados en la literatura de fusión multisensor [6].

La validación experimental (sección 3) confirmó que esta lógica no es solo un diseño en papel: los valores de IRH y probabilidad de evaporación registrados en el prototipo físico coinciden, muestra por muestra, con la fórmula implementada en el firmware. El sistema también incorpora mecanismos para identificar lecturas anómalas y estados degradados, permitiendo diferenciar entre variaciones normales y situaciones en las que un sensor deja de proporcionar información confiable.

El proyecto también deja una lección metodológica relevante para el análisis de datos de sistemas IoT: una prueba en reposo (Prueba 1) fue insuficiente para demostrar el valor del análisis estadístico offline. El agrupamiento mediante K-Means solo se volvió interpretable cuando se diseñó una segunda prueba con perturbaciones deliberadas (Prueba 2), que llevó al sistema fuera de su punto de operación normal. Esto evidencia la importancia de contar con datos suficientemente variados para que las técnicas de análisis puedan distinguir comportamientos diferentes. El uso de K-Means como técnica de agrupamiento se encuentra documentado en Bishop [10].

La arquitectura también evolucionó hacia una separación entre el procesamiento local y la visualización. Terán et al. presentan una arquitectura en la que los datos pueden ser procesados en un servidor local mediante *edge computing* y posteriormente visualizados mediante una interfaz web [5]. Water Guard adopta un principio equivalente: las alertas básicas pueden generarse localmente, mientras que el tablero web disponible en la WLAN permite consultar la información procesada sin convertir la conectividad en un requisito para la alerta física.

En conjunto, el prototipo responde a la pregunta guía del reto: mide y combina variables relacionadas con la disponibilidad de agua y las condiciones ambientales, genera indicadores de riesgo y permite visualizar los resultados mediante una interfaz local. La arquitectura mantiene la capacidad de operación local y, al mismo tiempo, incorpora conectividad dentro de la WLAN para facilitar la consulta de los datos.

## 5.2. Retos presentados durante el desarrollo

* **Confiabilidad de sensores de bajo costo:** el HC-SR04 y el DHT11 producen lecturas erráticas de forma intermitente incluso en condiciones normales. Esto obligó a rediseñar la adquisición de datos desde etapas tempranas con un esquema de conteo de fallos por sensor (`MAX_FALLOS`), en vez de confiar en cada lectura individual. La necesidad de considerar restricciones y errores en redes de sensores es consistente con la literatura de fusión multisensor, donde la combinación de diferentes fuentes busca mejorar la confiabilidad del sistema [6].

* **Identificación incorrecta de componentes de hardware:** durante el ensamblaje se descubrió que el módulo morado adquirido como GY-BME280 era en realidad un BMP280, sin sensor de humedad integrado, y que la pantalla adquirida como LCD 16x2 era en realidad una OLED I2C de 128x64. Ambos hallazgos obligaron a rediseñar la lógica de sensores: la humedad quedó a cargo exclusivamente del DHT11 y la visualización pasó a utilizar la librería U8x8 de U8g2.

* **Reincorporación de la presión atmosférica:** en la v5 se retiró el BMP280 para priorizar la robustez del primer corte. En la v8 se reincorporó como sensor opcional, con detección automática en 0x76 o 0x77, porque el índice de evaporación basado en Dalton necesita el término de presión (sección 2.3.4). Si no está conectado, el índice se normaliza sin él.

* **Daño físico en la pantalla OLED:** las dos primeras filas del display no son utilizables por un daño físico presente en la unidad. Esto obligó a redistribuir la información relevante —estado, anomalía, nivel, temperaturas, humedad, evaporación y confirmación de sensores— en las seis filas visibles, manteniendo la legibilidad de la interfaz.

* **Migración de Arduino Uno a ESP32:** Tinkercad no incluye el ESP32, así que la simulación del primer corte se hizo con Arduino Uno R3. En la v8 se migró al ESP32 real (doble núcleo Xtensa LX6 hasta 240 MHz y WiFi integrado [8]), lo que obligó a adaptar el cableado a 3,3 V (divisor en el ECHO), a evitar los pines de arranque y el ADC2 (que no funciona con WiFi activo) y a reescribir la medición con ISR y FreeRTOS [33].

* **Diseño de un experimento que realmente generara variabilidad:** la primera captura de datos (Prueba 1, en reposo) resultó demasiado uniforme para validar el detector de anomalías o producir agrupamientos K-Means claramente interpretables. Fue necesario diseñar una segunda prueba con tres perturbaciones controladas y documentadas: bloqueo de sensor, calentamiento del agua y bloqueo de luz.

* **Carcasa dentro del cronograma (Challenge #3):** la impresión 3D planeada (≈ 7 h por pieza) no dejaba margen para iterar antes de la entrega. El equipo cambió a MDF de 3 mm cortado con láser, que además resultó más económico, más fácil de ensamblar y de menor impacto ambiental, a cambio de una menor resistencia a la humedad ([2.8](2.8.-Diseño-Mecánico-Carcasa-y-Empaque)).

## 5.3. Trabajo futuro

* **Carcasa para exteriores:** sellar el MDF (laca o barniz) o migrar a ASA/policarbonato con empaques, con meta IP54 según IEC 60529 [55].

* **Completar la cobertura experimental pendiente:** ejecutar la prueba de condición crítica sostenida (secciones 3.6 y 4.4) para validar los casos de prueba 2, 3, 4, 5, 7, 8 y 11, incluyendo evidencia fotográfica de la OLED en estados distintos a `NORMAL`.

* **Esquemático gráfico formal:** reemplazar la tabla de interconexión de pines (sección 2.3.3) por un esquemático realizado en Fritzing o EasyEDA, una vez validado completamente el cableado físico.

* **Prueba de larga duración:** ejecutar el prototipo durante varias horas en condiciones ambientales reales, sin perturbaciones provocadas, para observar el comportamiento del contador de anomalías ante múltiples eventos acumulados y enriquecer el análisis de K-Means con variabilidad natural.

* **Costeo real del prototipo:** completar los espacios pendientes del modelo de negocio (sección 2.5) con el presupuesto real de los componentes utilizados, con el fin de calcular un costo por unidad concreto.

* **Telemetría opcional para agregación regional:** manteniendo la capacidad de alerta local autónoma, podría incorporarse como capa adicional un módulo de bajo consumo, como LoRa u otra tecnología equivalente, para transmitir periódicamente el IRH y la probabilidad de evaporación de cada unidad a un tablero regional. Este enfoque sería consistente con arquitecturas IoT distribuidas en las que los nodos adquieren información localmente y posteriormente transmiten datos para su consulta y análisis [7], [5]. La conectividad, sin embargo, permanecería como una capacidad adicional y no como requisito para la generación de alertas locales.

* **Alimentación autónoma:** incorporar un panel solar y una batería recargable para facilitar el despliegue en puntos rurales sin acceso permanente a la red eléctrica. Esto permitiría reducir la dependencia de infraestructura eléctrica externa y sería coherente con las restricciones energéticas habituales de los sistemas de sensores distribuidos [6].

* **Reemplazo de la pantalla OLED dañada:** evaluar una unidad nueva sin el defecto físico actual para aprovechar las ocho filas disponibles del display y simplificar la distribución de información.

* **Evolución del procesamiento y análisis:** una versión posterior podría trasladar parte del análisis a un nodo de mayor capacidad o a un servidor local, manteniendo el procesamiento inmediato en el dispositivo cuando sea necesario. Esta evolución permitiría estudiar diferentes distribuciones entre procesamiento en el borde y procesamiento centralizado, una arquitectura contemplada en sistemas IoT y de fusión multisensor [5], [6].

## 5.4. Referencias

La lista completa en formato IEEE está en [Referencias](Referencias).
