Juan100205/IOTPROYECTOFINAL3CORTE/wiki/7.-Roles-y-Contribuciones.md

# 7. Roles, actividades y contribuciones del equipo

| Integrante | Rol | Actividades principales | Contribuciones a la solución |
|---|---|---|---|
| **Juan José Riaño Zabaleta** | Documentación y banco de pruebas | Diseño y construcción del banco de pruebas (nevera de icopor, aluminio, halógeno, ventilador); ejecución de las pruebas y registro de los logs CSV; análisis offline (estadística y K-Means); redacción de la wiki y del README; gestión de referencias IEEE | Protocolo de pruebas y evidencia experimental ([sección 3](3.-Configuración-Experimental,-Resultados-y-Análisis)); documentación técnica completa; justificación bibliográfica de fórmulas e indicadores |
| **Santiago Peña Beltrán** | Software y electrónica | Migración de Arduino Uno a ESP32; cableado y adaptación a 3,3 V; integración de los sensores (HC-SR04, MD-PS002/HX710B, DS18B20, DHT11, BMP280, LDR); firmware v8 con ISR y FreeRTOS; tablero web embebido y seguridad de acceso | Prototipo funcional; arquitectura de hardware y software ([2.2](2.2.-Arquitectura-Propuesta)); implementación de la analítica en el borde y del tablero |

**Trabajo conjunto:** definición de las restricciones de diseño, selección de umbrales, validación del prototipo, video demostrativo y sustentación.

> **Actas de reunión y evaluación:** ver la [sección 7.1](7.1.-Actas-de-Reunión-y-Evaluación).
