Juan100205/IOTPROYECTOFINAL3CORTE/wiki/Home.md

# 💧 WaterGuard v9: Wiki del Challenge #3

**Universidad de La Sabana**, Facultad de Ingeniería · Internet de las Cosas 2026-2
**Integrantes:** Juan José Riaño Zabaleta · Santiago Peña Beltrán

Prototipo IoT de bajo costo basado en ESP32 que monitorea la disponibilidad de agua en puntos críticos de almacenamiento de Sabana Centro. Fusiona nivel redundante (ultrasonido + presión hidrostática) con variables meteorológicas para calcular un **índice de evaporación potencial** (Dalton/DPV) y un **Índice de Riesgo Hídrico (IRH)**. Alerta **in situ** y en un **tablero web embebido** restringido a la WLAN de la Alcaldía, sin MQTT.

> *Abstract.* WaterGuard v8 is a low-cost ESP32 IoT prototype that fuses redundant water-level sensing (ultrasonic + hydrostatic) with weather variables to compute a Dalton-based potential-evaporation index and a Water Risk Index. It raises on-site alarms and serves a WLAN-restricted embedded web dashboard (no MQTT), with sensing done in ISRs and FreeRTOS tasks.

> **WaterGuard v9 (Challenge #3):** ecosistema IoT de tres capas. El nodo ESP32 envía sus datos por **MQTT** a un **Gateway en Raspberry Pi 5**, que los guarda en una base de datos local **SQLite** y los procesa antes de subirlos a la nube. Allí un **tablero global** (LeMarTek Cloud, ThingsBoard) y un **módulo de IA** (API de Claude) apoyan las decisiones de las autoridades de Cundinamarca. Ver la [solución propuesta](2.-Solución-Propuesta), la [arquitectura v9](2.2.-Arquitectura-Propuesta) y el [plan de trabajo](0.-Plan-del-Challenge-3).
>
> El contenido base de la v8 (nodo sensor) se conserva en las secciones que siguen.

## Enlaces públicos

| Recurso | Enlace |
|---|---|
| 🌐 Tablero global (LeMarTek Cloud) | [iot.lemartek.cloud](https://iot.lemartek.cloud/) · acceso solo con usuario autorizado |
| 🎬 Video demostrativo (4:49) | [Microsoft Stream (Teams)](https://unisabanaedu.sharepoint.com/:v:/s/Section_38906734699371/IQATLGUkAyPMQohUeUwel1CQAfkErWDD3ub2KPHNx16AHXY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) · [GitHub](https://github.com/Juan100205/IOTPROYECTOFINAL3CORTE/blob/main/docs/video/WaterGuard_v9_video.mp4) |
| 💻 Repositorio (código, diseño y actas) | [Juan100205/IOTPROYECTOFINAL3CORTE](https://github.com/Juan100205/IOTPROYECTOFINAL3CORTE) |
| 📖 Wiki | [github.com/…/IOTPROYECTOFINAL3CORTE/wiki](https://github.com/Juan100205/IOTPROYECTOFINAL3CORTE/wiki) |
| 📝 Actas en PDF | [docs/actas](https://github.com/Juan100205/IOTPROYECTOFINAL3CORTE/tree/main/docs/actas) |

## Contenido

1. [Resumen general](1.-Resumen-General): motivación, justificación y estructura
2. [Solución propuesta](2.-Solución-Propuesta)
   - [2.1 Restricciones de diseño](2.1.-Restricciones-de-Diseño)
   - [2.2 Arquitectura propuesta](2.2.-Arquitectura-Propuesta)
   - [2.3 Desarrollo teórico modular (fórmulas e indicadores)](2.3.-Desarrollo-Teórico-Modular)
   - [2.4 Diagramas UML](2.4.-Diagramas-UML)
   - [2.5 Esquemático de hardware](2.5.-Esquemático-de-Hardware)
   - [2.6 Estándares de ingeniería](2.6.-Estándares-de-Ingeniería)
   - [2.7 Modelo de negocio](2.7.-Modelo-de-Negocio)
   - [2.8 Diseño mecánico: carcasa y empaque](2.8.-Diseño-Mecánico-Carcasa-y-Empaque)
3. [Configuración experimental, resultados y análisis](3.-Configuración-Experimental,-Resultados-y-Análisis)
4. [Autoevaluación del protocolo de pruebas](4.-Autoevaluación-del-Protocolo-de-Pruebas)
5. [Conclusiones, retos, trabajo futuro](5.-Conclusiones,-Retos-del-Desarrollo,-Trabajo-Futuro-y-Referencias)
6. [Anexos](6.-Anexos)
7. [Roles y contribuciones](7.-Roles-y-Contribuciones)
   - [7.1 Actas de reunión y evaluación](7.1.-Actas-de-Reunión-y-Evaluación)
8. [Video demostrativo](8.-Video-Demostrativo)
9. [Uso de herramientas de IA](9.-Uso-de-Herramientas-de-Inteligencia-Artificial)
10. [Referencias (IEEE)](Referencias)

Repositorio (tercer corte): [Juan100205/IOTPROYECTOFINAL3CORTE](https://github.com/Juan100205/IOTPROYECTOFINAL3CORTE) · Segundo corte: [LeMarsito02/IOTPROYECTOFINAL2CORTE](https://github.com/LeMarsito02/IOTPROYECTOFINAL2CORTE/wiki) · Primer corte: [wiki del Challenge #1](https://github.com/LeMarsito02/IOTPROYECTOFINAL1CORTE/wiki)
