Juan100205/IOTPROYECTOFINAL3CORTE/wiki/8.-Video-Demostrativo.md

# 8. Video demostrativo

Video de validación del prototipo funcional WaterGuard v9 (4:49).

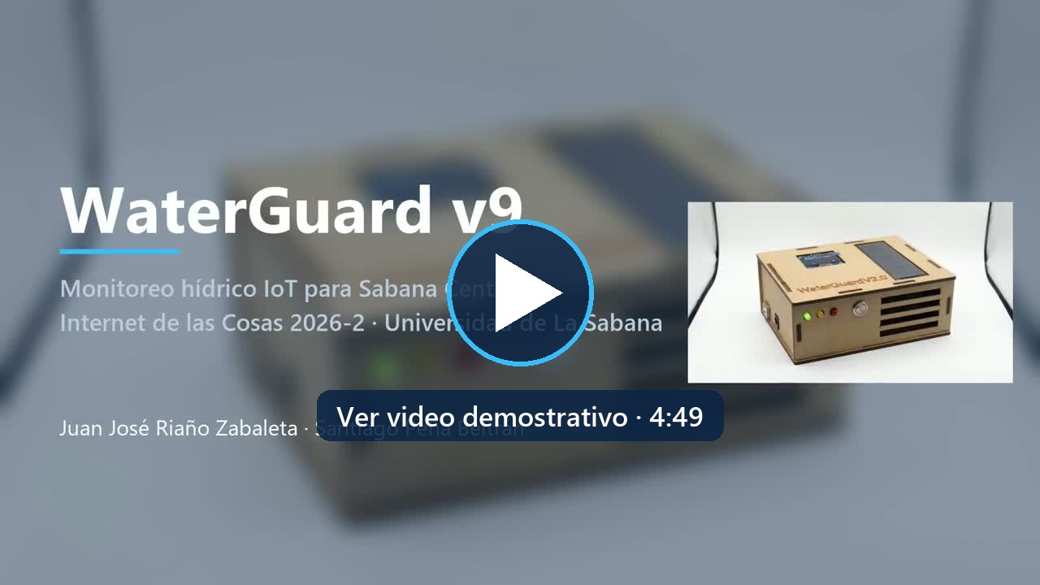
[picture p15: assets/video-portada.jpg]
Ver el video demostrativo de WaterGuard v9 (https://unisabanaedu.sharepoint.com/:v:/s/Section_38906734699371/IQATLGUkAyPMQohUeUwel1CQAfkErWDD3ub2KPHNx16AHXY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)


▶️ **[Ver en Microsoft Stream (Teams)](https://unisabanaedu.sharepoint.com/:v:/s/Section_38906734699371/IQATLGUkAyPMQohUeUwel1CQAfkErWDD3ub2KPHNx16AHXY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)** · [Ver en GitHub](https://github.com/Juan100205/IOTPROYECTOFINAL3CORTE/blob/main/docs/video/WaterGuard_v9_video.mp4) · [Descargar (MP4, 1080p)](https://raw.githubusercontent.com/Juan100205/IOTPROYECTOFINAL3CORTE/main/docs/video/WaterGuard_v9_video.mp4)

## Capítulos

| Tiempo | Bloque | Qué se muestra |
|---|---|---|
| 0:00 | Título | WaterGuard v9 · Universidad de La Sabana |
| 0:02 | 1. Presentación y contexto | Los 20 municipios de Cundinamarca en riesgo extremo y el problema de enterarse tarde |
| 0:36 | 3. Solución ideal | Red por niveles: tanque (ESP32), municipio (Gateway) y departamento (LeMarTek Cloud) e IA |
| 1:13 | 4. Banco de pruebas | Nevera con aluminio, halógeno, ventilador y soporte de la carcasa |
| 1:48 | 5. Producto | Carcasa en MDF de 3 mm cortada con láser; descarte de la impresión 3D por el calor |
| 2:23 | 6. Conexiones y código | Pines del ESP32, firmware con ISR y FreeRTOS, Gateway con SQLite y alerta de la base de datos, IA con Claude |
| 3:30 | 7. Tablero global e IA | LeMarTek Cloud y el control remoto de la alarma |
| 3:53 | 8. Comercialización | Costo de producción, precio por nodo y por municipio |
| 4:19 | 9. Conclusiones | Cumplimiento de las cinco restricciones, trabajo futuro y cierre |

La correspondencia de cada bloque con las pruebas del plan TDD está en la [sección 4.0.1](4.-Autoevaluación-del-Protocolo-de-Pruebas).
