Juan100205/IOTPROYECTOFINAL3CORTE/wiki/9.-Uso-de-Herramientas-de-Inteligencia-Artificial.md

# 9. Uso de herramientas de Inteligencia Artificial

El enunciado exige declarar el uso de IA en tres puntos. Esta sección responde a cada uno:

| Lo que pide el enunciado | Dónde está |
|---|---|
| 1. Qué IA se consultó | [9.1](#91-herramientas-utilizadas) |
| 2. Las preguntas o instrucciones enviadas | [9.3](#93-registro-de-consultas-por-etapa) y la transcripción textual al final de la página |
| 3. Cómo se validaron las respuestas y cómo se aplicaron | [9.3](#93-registro-de-consultas-por-etapa) y [9.4](#94-responsabilidad-del-equipo) |

## 9.1. Herramientas utilizadas

| Herramienta | Para qué se usó | Etapa |
|---|---|---|
| **Claude** (Anthropic), en claude.ai | Consultas sobre firmware, sensores, analítica y estructura de la wiki | Challenge #1 |
| **Claude Code** (Anthropic, modelo Claude Opus 5.5) | Migración a ESP32, código v9 (firmware, Gateway y Raspberry Pi), revisión de código, organización del repositorio y redacción de la wiki | Challenges #2 y #3 |
| **ChatGPT** (OpenAI) | Consultas puntuales de implementación, depuración y documentación | Challenges #1 y #2 |
| **Gemini** (Google) | Mejora de la calidad de las fotos del prototipo y del empaque | Challenge #3 |
| **API de Claude** (Anthropic) | **Componente del sistema**, no asistencia: es el módulo de recomendación del Gateway ([2.2.0](2.2.-Arquitectura-Propuesta)) | Challenge #3 |

## 9.2. Forma de trabajo con la IA

El equipo **planteó la idea, los requisitos y las decisiones de diseño**, y usó la IA como acompañante para llevarlos a la implementación:

| El equipo | La IA |
|---|---|
| Definió el problema, la solución por niveles y el alcance departamental | Ayudó a estructurar la solución según el enunciado y la rúbrica |
| Eligió los componentes, armó el circuito, la carcasa y el banco de pruebas | Sugirió conexiones y revisó compatibilidades (3,3 V, ADC2, pines de arranque) |
| Decidió la arquitectura (ESP32, Raspberry Pi, LeMarTek Cloud, Claude) y el cambio a MDF | Propuso implementaciones de código para esas decisiones |
| Probó todo en el prototipo y en el banco, y aprobó cada cambio | Ayudó a depurar errores y a escribir pruebas automatizadas |
| Validó el contenido técnico de la wiki | Ayudó a redactar, organizar y verificar referencias |

Ninguna decisión de diseño ni ningún resultado experimental se delegó a la IA.

## 9.3. Registro de consultas por etapa

Las instrucciones se presentan con **redacción y ortografía corregidas, sin cambiar su contenido**. La versión textual exacta está al final de la página.

### Challenge #1 (WaterGuard v7, Arduino Uno)

| Tema | Qué se pidió | Cómo se validó y se aplicó |
|---|---|---|
| **1. Revisión del firmware frente a la rúbrica** | "¿Cómo va?" · "¿Hay que hacerlo en Tinkercad? Ya tengo el prototipo real; le falta algo, pero no sé si cumple la rúbrica." | Se identificaron requisitos de analítica sin implementar (detección de anomalías). Se verificó sobre el código antes de cambiarlo |
| **2. Sensores, cableado y adquisición** | "El firmware ya funciona, pero falta la analítica. Me falta incorporar una fotorresistencia para medir la luminosidad y conectar el DS18B20." | Pull-up del DS18B20, entrada analógica de la LDR y conflictos de pines. Cada conexión se probó en el prototipo |
| **3. Cambio de LCD a OLED** | Adaptar el firmware y la distribución de la información a la pantalla OLED | Revisado directamente en el prototipo físico |
| **4. Depuración y salida serial** | Diagnosticar sensores que no entregaban datos y el comportamiento del buzzer | Se contrastaron el monitor serial, la OLED y el comportamiento físico |
| **5. Fotorresistencia** | Integrar la lectura de luminosidad | Se interpreta como valor relativo, no en lux. Umbrales verificados en pruebas físicas |
| **6. Analítica en el dispositivo** | "Según la rúbrica, ¿la analítica tiene que estar dentro del Arduino o puede hacerse offline?" | Criterio adoptado: la alerta se decide en el dispositivo; el análisis estadístico (K-Means) se hace offline |
| **7. Estructura de la wiki** | "Ayúdame a hacer la wiki: ¿qué requisitos tiene?" · "Sección 2." · "Desarrolla la sección 6 con el mayor nivel de detalle posible." | Se contrastaron con el firmware y el prototipo los nombres de funciones, pines, umbrales, sensores y procedimientos de prueba |

### Challenge #2 (WaterGuard v8, ESP32)

| Tema | Qué se pidió | Cómo se validó y se aplicó |
|---|---|---|
| **8. Migración a ESP32 y tablero web** | Migrar el firmware a ESP32 con medición por ISR y FreeRTOS, servidor web embebido, login con SHA-256, redundancia de nivel y evaporación por Dalton | Pines contrastados con el manual del ESP32 [8], fórmulas con la FAO-56 [9] y comportamiento con las pruebas físicas ([sección 3](3.-Configuración-Experimental,-Resultados-y-Análisis)) |
| **9. Identificación de componentes** | Cableado del HX710B, divisor del ECHO a 3,3 V y diagnóstico de la OLED y el BMP280 por escaneo I2C | Medido en el montaje real antes de aplicar |
| **10. Wiki del Challenge #2 y referencias** | "Necesitamos la wiki del proyecto según la rúbrica adjunta. Agrega esos archivos al `.gitignore` y, con base en ellos, cita las referencias a lo largo de la wiki para justificar el funcionamiento, las fórmulas y los indicadores." · "Agregué la entrega del primer corte, con sus imágenes y datos: conecta las referencias e imágenes que faltan en el segundo corte y sube los cambios al terminar." · "Prioriza lo esencial y sube la wiki y el README cuanto antes." | Cada fórmula se contrastó con `WaterGuard_v8.ino`. Las referencias se verificaron en Crossref, IEEE Xplore y repositorios institucionales, lo que corrigió varias. Los resultados experimentales vienen de las pruebas del equipo |

### Challenge #3 (WaterGuard v9, ecosistema de tres capas)

| Tema | Qué se pidió | Cómo se validó y se aplicó |
|---|---|---|
| **11. Mejora de fotografías** | Mejorar con **Gemini** la calidad de las fotos reales de la carcasa y del empaque | La forma, las perforaciones y el grabado corresponden al objeto real. La IA alteró el texto impreso de la caja (LoRa, IP65, CE/FCC); se señala como no válido en los pies de figura ([2.8.4](2.8.-Diseño-Mecánico-Carcasa-y-Empaque)) |
| **12. Organización y diseño mecánico** | "Toma contexto de todo el proyecto." · "Organiza las carpetas: una de *assets* para imágenes y figuras, una de código y una con el enunciado, la rúbrica y el paper de Terán-Aranda." · "Revisa que la wiki esté alineada con las nuevas ubicaciones." · "Documenta el nuevo diseño con las fotos nuevas y llena el Acta #2, donde se definió el cambio de la carcasa a MDF de 3 mm por economía, tiempo, facilidad y biodegradabilidad, con sus plantillas de corte y la adecuación del banco de pruebas." | Las cotas de la carcasa se extrajeron por programa de los PDF de las plantillas. Los costos y las razones del cambio los aportó el equipo |
| **13. Solución v9, TDD y Acta #3** | "Planeemos en la bitácora y en el acta de la sesión de hoy (2:00 p. m.), de ensamblaje y pruebas, el código: el tablero web, el envío de datos del nodo por la red local, el histórico en una base de datos local con alerta crítica si un dato no se guarda, el protocolo MQTT y el Gateway en la Raspberry Pi probados con simuladores, y el módulo de IA por API con *prompts* y contexto parametrizados. Actualicemos la solución propuesta a escala de Cundinamarca, documentemos la ideación del hardware (Crazy 8s, lluvia de ideas, bocetos y maquetas de bajo costo) y la autoevaluación con el banco de pruebas y TDD." | Se propuso inicialmente ChatGPT para el módulo de IA y una app en Vercel para el tablero; el equipo decidió **Claude** y **LeMarTek Cloud**. La IA advirtió que el término "redes neuronales vectoriales 3D" no es estándar, y el equipo lo precisó como *prompts* parametrizados y recuperación de contexto (RAG [57]) |
| **14. Código v9 y alineación con lo construido** | "Corrige la fecha: el Acta #2 fue el viernes 6 de noviembre." · "Revisa lo que se subió al repositorio y confirma qué falta en el código." · "Agrega la alerta para cuando falle la base de datos y alinea la wiki con lo construido en LeMarTek Cloud y en el código. La carcasa impresa en 3D se descartó porque el calor la deforma; la real es la de MDF." · El código v9 (firmware, Gateway y Raspberry Pi) se desarrolló con Claude Code en la sesión de Santiago Peña | La alerta se verificó con una prueba automatizada que provoca fallas reales de SQLite ([3.5](3.-Configuración-Experimental,-Resultados-y-Análisis)). La llamada a la API de Claude se contrastó con la documentación oficial [70]. El tablero global se describió entrando a él con el rol de autoridad (credenciales omitidas) |
| **15. Video, precios y pulido final** | "Estructura el video: presentación, contexto, solución ideal, pruebas en el banco, solución, comercialización y precios, explicación técnica de conexiones y código, y conclusiones. Agrega a la wiki los precios de producción." · "Agrega las fuentes de la wiki (leyes y normas), el *stack* tecnológico de los tableros y del Gateway, cambia las fotos del montaje por las actuales, rediseña los casos de prueba y mejora la redacción de esta sección." | Las leyes se verificaron en el Gestor Normativo de la Función Pública y la norma del espectro en el normograma de MinTIC. Los precios de venta son una propuesta del equipo con supuestos explícitos ([2.7.4](2.7.-Modelo-de-Negocio)). El *stack* lo aportó el equipo |

## 9.4. Responsabilidad del equipo

El equipo fue responsable de:

- Definir el problema, la arquitectura y las decisiones de diseño.
- Seleccionar los componentes y realizar el montaje, el cableado, la carcasa y el banco de pruebas.
- Integrar los sensores, los actuadores, el Gateway y la plataforma en la nube.
- Probar el sistema sobre el hardware real e interpretar los resultados.
- Revisar y aprobar todo el código y el texto propuestos por la IA antes de incorporarlos.
- Validar el cumplimiento de los requisitos del reto.

## 9.5. Consideración general

La IA se usó como **herramienta de apoyo** para consultar, depurar, explorar alternativas, implementar código y organizar la documentación. La implementación final, la integración y la validación del sistema son del equipo, que asume la responsabilidad del resultado.

<details>
<summary><strong>Transcripción textual de las instrucciones (sin corrección)</strong></summary>

Versión exacta de las instrucciones enviadas, como la exige el enunciado. Las credenciales del tablero se omiten.

**Tema 1 — Revisión del firmware frente a la rúbrica**

> "que tal va"

> "hay que hacerlo en tinkercad? ya tengo el prototipo real, le falta algo pero mira, no se si esta bien segun la rúbrica"

**Tema 2 — Sensores, cableado y adquisición de datos**

> "ya esta corriendo el firmware aunque hay que añadirle lo de analitica, y me falta una fotoresistencia para medir el nivel de luminosidad en codigo y conectar el DS18B20"

**Tema 6 — Detección de anomalías y analítica**

> "segun las rubricas no es necesario analitica dentro del arduino? osea puede ser ofline o que?"

**Tema 7 — Organización y documentación de la Wiki**

> "ayudame a hacer la wiki, que requisitos tiene?"

> "SECCION 2"

> "haz el 6, hazlo super hiper mega bien"

**Tema 10 — Redacción de la wiki del Challenge #2 y verificación de referencias**

> "hazme el favor que encesitamos necesito que hagas la wiki del poryecto como crresponde segun la rubrica que te pongo aca y pon esos archivos en un git ignore porfa y ahi mismo en base a eso pon las referencias y referencia a lo largod e al ewiki el funcionamiento y todo como debe ser guiate de esto par ajustificar uso de formulas indicadores y etc" (junto con la lista de referencias del equipo)

> "tambien ahora te puse el del primer corte es decir la entrega anteriro ahi tenemos imagenes datos etc en base a eso encesito que referencias y conectas las referencias de imagenes etc que nos faltan en el segundo porfa y haz el push tan pronto temrines"

> "haz el push cuanto antes haz lo prioritario u pushea la wiki y el readme"

**Tema 12 — Organización del repositorio y documentación del diseño mecánico (Challenge #3)**

> "toma contexto de todo el PROYECTO PORFA"

> "listo primero la organizacion de carpetas lo mas imrpjtante  haz una carpeta de assets donde gaurdemos las imagenes  y figuras  cuademos una carpetas de codigos de funcionamiento donde guardemos todos los codigos  una carpeta de deneunciado donde guardemos teran aranda enucniado y rubrica"

> "Revisa la wiki este alieanda con las nuevas ubicaciones"

> "antes de uan evz actualicemos lo basico vayamos llenando loq eu ya se lleva que es el nuevo diseñño con las nuevas iamgenes si tiene s que corregirlas corrigelas llevamala wiki llena la acta de reunion 2 que era la que ahcia falta donde se defiinio el cambio de carcadsa a apor temas de enconomia tiempo facilida y bio degradabilidad del prototipo un prototipo en mdf de 3mm te agrego en la fuente en el directorio principal y jsutamente se hizo el diseño y plantillas para corte y demas ademas de la organizacion de que el banco de pruebas resista en luevo diseño, por eso mismo agregar eso y rellenas las secciones de l wiki que lo encesiten"

**Tema 13 — Solución propuesta v9, arquitectura, protocolo TDD y Acta #3 (Challenge #3)**

> "en temas de codigo esto si ya lo vamos a paltnear en al bitacora y acta de sesion del dia de hoy 2 pm en al cual se ahce ensablaje y rpuebas de los entornos progrmados entonces primero es el  tablerod e control desde un navegaro web apr alo cual se utilizo una app desarrolla desde vercer qu se puede activar y utilziar y pues justamenteel codigo adaptado que se conecta por emdio de la lan arduino al pc y sube esos datos al servidor, el historico revisar si no se tiene aplciado de lo contrario para lo cual se generara una bd local pequeña la cual se vaya almacenando y en elcaos que no se almacene se envia una alrta critica antes de continuar llenando los datos y finalmente tener el servidor web local organizar el rootcolo mqtt el agteway iot por medio de la raspberrry ahcer pruebas por emdio de simualdores locales  cumplir este protocoloonde serán almacenados en una base datos y procesados localmente antes de su transferencia y visualización en la plataforma Io y finalmente el modulo de ia se utilziara momentaneamente chat gpt para lo cual se utilziara una api y se brindaran sistemas de promt y codigficacion en elc ontexto del mismo para maximizar lac reacion de redes neuroanles vecotriales 3d als cuales aproten a la recomendacion toma y roganzacion de datos a lo larod de la app. [...] actualicemos la solucion propuesta en base a estoq ue te comento como solucion a la altura de los deparatamentos de cundinamarca en la aprte del harware propondermo unas sesionde crazy eight y brainstorming y diseñode d edsitntos bocetos y maquetaje tanto en papel y bajo rpesupuesto apra encontrar la mejor distribucion de lo compoenente s y su mejor funcioamiuento y cotnectivdad de los mismos [...] autoevaluacion rpotocolo de pruebas porpongamos ahi que por medio del disñeo a al amediad del banco de pruebas se lnos permitio encontrar fallas y solucionarlas en al emdiad de nuestra posibilidad y hacer un test driven develeopment [...]"

**Tema 14 — Código v9, alerta por falla de la base de datos y alineación de la wiki (Challenge #3)**

> "la sesion y la bitacora 2 fue el viernes 6 de nov corrige eso de la que hablamos hoy porfa corrigela"

> "subelo por ahora como asi se tiene y cambia la ia cladude"

> "haz un pull del ultimo commit ty mira lo que se ha subido y temas de codigo confirmame en este orden de ideas que nos falta"

> "agrega la alerta de si falla la bd tenemos ahorita aungun tablero??? alinea la wiki con loq euse construyoc omplelementando pero  mantengamos el enfoque qeu ahorita dejamos cuentame si se puede, quiseorn la carcasa de  impresion 3d porque por el carlor se derrite se descarto esa posibilidad  alieneemos segun loq eu se hico lemartec y loq eu esta en el codigo ya que lo ehcho es lo temrinado porfala carcasa de hoy real si es la de mdf entonces alineemos"

> "este es dashboard https://iot.lemartek.cloud/ [...]" (con usuario y contraseña de la autoridad, omitidos aquí)

**Tema 15 — Video, precios y pulido final**

> "listo justo entocnes ahora para inciar la finalziacion vamos con el video entonces vamos con una estructuracion 1. presnetacion, contextualizacion, presnetacion de solucion ideal, presnetaicon de pruebas en banco de pruebas, presentacion de solucion, marketing sistema de comercializacion y posible uso precios de produccion y demas necesito que esto de precios y precios de produccion lo agregues a la wiki, y fianlziando ya con conclusiones rapidas apra cerrar el video y mostrar todo tambien u poco de explicacion de conexiones y codigo importantes y tecnicamente como se realzian estas funciones entonces vamos con eso tanto desd eun lado funcional practicomo desde el lado tecnico"

> "imprtante sacate porfa las fuentes de mucahs de als cosas de la wiki por ejemplo imprtante de las leyes que se menciona que se mencione para poder referenciarse sacate tambeina gregando estos datos [...] gueimonos del https://github.com/LeMarsito02/IOTPROYECTOFINAL2CORTE que de aqui sacmos uan buene referencia cion par aformulas y bsquemos referencias y justificar de est amaenra la formulacion indicadores y formulas del montaje fisico cambialo por la fotos qneuvas que subimos hoy [...] 2. Casos de prueba diseñados como requerimeinto caso de uso y aso con un buen duseño [...] corrige la el mensaje aen temas de mala escritura y asi"

</details>
