Juan100205/IOTPROYECTOFINAL3CORTE/wiki/2.6.-Estándares-de-Ingeniería.md

# 2.6. Estándares de diseño de ingeniería aplicados

El proceso sigue el marco de diseño de ingeniería de ABET: la solución debe satisfacer necesidades específicas considerando la salud pública, la seguridad, el bienestar y factores globales, sociales, ambientales y económicos, dentro de restricciones realistas [34]. La tabla muestra qué norma se aplicó, dónde y cómo se verifica.

## 2.6.1. Estándares técnicos y de comunicación

| Estándar | Qué regula | Cómo se aplica en WaterGuard v8 | Verificación |
|---|---|---|---|
| **IEEE 802.11-2020** [23] | WLAN: capas física y MAC | El ESP32 se conecta como estación (STA) a la WLAN de la Alcaldía en 2,4 GHz, con WPA2 | Conexión y reconexión automática cada 5 s (`revisarWiFi`) |
| **RFC 9110, HTTP Semantics** [24] | Métodos y códigos de estado HTTP | `GET` solo para consultas y `POST` para acciones que cambian estado (login, logout, alarma). Códigos 200, 302, 401, 403 y 404 con su significado estándar | Prueba S1–S4 del protocolo |
| **RFC 6265, cookies** [25] | Gestión de estado HTTP | Cookie `WGSESION` con `HttpOnly`, `SameSite=Strict`, `Path=/` y `Max-Age=1800` | Inspección de cabeceras en el navegador |
| **RFC 6762, mDNS** [39] | Resolución de nombres en red local sin DNS | El tablero responde en `http://waterguard.local` | Acceso por nombre desde PC y celular |
| **FIPS 180-4, SHA-256** [26] | Función hash segura | La clave del tablero nunca se guarda en claro: solo su hash SHA-256 (mbedTLS) | Hash generado con Python e igual al del firmware |
| **MQTT 3.1.1, OASIS** [56] | Protocolo de mensajería publicación/suscripción | `PubSubClient` en el ESP32 y `paho-mqtt` en el Gateway; QoS 1 hacia la nube, mensajes retenidos para `estado` e `ia`, LWT para `disponible` | Prueba P2 y P4 ([sección 4](4.-Autoevaluación-del-Protocolo-de-Pruebas)) |
| **RFC 6455, WebSocket** [60] | Transporte sobre HTTP(S) | MQTT sobre WebSockets seguros (WSS, puerto 443) entre el Gateway y LeMarTek Cloud, a través del túnel de Cloudflare | Conexión del Gateway a `mqtt.lemartek.cloud` |
| **UM10204, bus I2C** [29] | Bus I2C | OLED (0x3C) y BMP280 (0x76/0x77) en el mismo bus, en modo estándar, con mutex de acceso | Escaneo I2C al arrancar |
| **ISO/IEC 30141:2024** [27] | Arquitectura de referencia IoT | Separación en dominios: sensado y control (nodo), servicio y aplicación (tablero) y usuario (autoridad, comunidad) | [2.2. Arquitectura](2.2.-Arquitectura-Propuesta) |

## 2.6.2. Estándares y buenas prácticas de seguridad

Se tomaron como referencia los requisitos de verificación de **OWASP ASVS**, versión 4.0.3 [28], elegida porque es la versión con la que el equipo trabajó durante el desarrollo:

| Requisito ASVS (capítulo) | Implementación |
|---|---|
| V2 Autenticación: almacenar credenciales con hash y resistir fuerza bruta | SHA-256 de la clave; bloqueo de la IP por 2 min tras 5 fallos |
| V2: comparación sin fuga por tiempos | `igualesTiempoConstante()` |
| V3 Sesiones: tokens aleatorios con entropía suficiente | 128 bits del generador por hardware (`esp_fill_random`) |
| V3: expiración e invalidación de la sesión | 30 min de inactividad; `/logout` invalida la sesión en el servidor |
| V3: cookie protegida | `HttpOnly` y `SameSite=Strict` |
| V4 Control de acceso: denegar por defecto | `filtroRed()` en **todas** las rutas, incluida la 404; `autorizado()` en las rutas protegidas |
| V7 Registro: registrar eventos de seguridad | Accesos, rechazos y claves incorrectas quedan en el registro de eventos |
| V14 Configuración: cabeceras de seguridad | `X-Frame-Options`, `X-Content-Type-Options`, `Referrer-Policy` y `Cache-Control: no-store` |

**Brecha conocida frente a ASVS:** V9 (comunicaciones) exige TLS. No se implementó por el costo de CPU y memoria de HTTPS en el ESP32 y porque WPA2 ya cifra el enlace. Queda como trabajo futuro.

## 2.6.3. Estándares de software embebido

| Práctica | Aplicación |
|---|---|
| **Sistema operativo de tiempo real (FreeRTOS SMP de ESP-IDF)** [33], [41] | Tareas fijadas a un núcleo (`xTaskCreatePinnedToCore`), prioridades explícitas, `vTaskDelayUntil` para periodos exactos y notificaciones de tarea desde la ISR |
| **ISR mínimas en IRAM** [8], [33] | Las ISR solo toman el tiempo o levantan una bandera; toda la lógica corre en tareas. Leen el pin por registro (`GPIO_IN_REG`), que es seguro en IRAM |
| **Exclusión mutua** | `mtxDatos` para el estado compartido y `mtxI2C` para el bus. Secciones críticas cortas: se copia y se libera |
| **Ausencia de dato explícita** | `NAN` representa "sin dato" en lugar de valores mágicos como 0 o −1 |
| **Código documentado y nombres descriptivos** | Bloques de comentarios por módulo y nombres en español alineados con esta wiki ([Anexos](6.-Anexos)) |
| **Configuración centralizada** | Todos los umbrales y pines están agrupados al inicio del `.ino` |

## 2.6.4. Marco regulatorio colombiano considerado

| Norma | Relación con el proyecto |
|---|---|
| Ley 1523 de 2012, gestión del riesgo de desastres [30] | El sistema es una herramienta de **monitoreo y alerta temprana**, uno de los procesos de conocimiento del riesgo que define la ley |
| Ley 373 de 1997, uso eficiente y ahorro del agua [31] | La información de nivel y de descenso apoya los programas municipales de uso eficiente |
| Ley 1581 de 2012, protección de datos personales [32] | No se recolectan datos personales. Solo se guardan IPs de acceso en RAM volátil, con fines de seguridad |
| Resolución ANE 105 de 2020, espectro radioeléctrico [62] | La banda de 2400–2483,5 MHz es de uso libre para sistemas de acceso inalámbrico, así que el WiFi del nodo y del Gateway no requiere licencia |

## 2.6.5. Estándares del diseño mecánico (carcasa y empaque)

| Estándar | Qué regula | Cómo se aplica | Verificación |
|---|---|---|---|
| **IEC 60529, código IP** [55] | Grado de protección de envolventes contra sólidos y agua | Meta de diseño para producción: IP54. El prototipo en MDF **no la cumple** y se documenta como limitación | [2.8.5](2.8.-Diseño-Mecánico-Carcasa-y-Empaque) |
| **EN 622-5, tableros de fibras MDF** [54] | Requisitos de los tableros MDF de proceso seco | Material de la carcasa: MDF de 3 mm. Para exteriores se especificaría la variante resistente a la humedad (MDF.H) | Ficha del proveedor del tablero |
| **Diseño para manufactura (DFM)** | Buenas prácticas para fabricar y ensamblar | Un solo material y espesor, ranuras de encastre de 3 mm (iguales al espesor), capas separadas de corte y grabado, todas las piezas en una lámina de 245 × 350 mm | Plantillas en [`diseno/carcasa-mdf/`](https://github.com/Juan100205/IOTPROYECTOFINAL3CORTE/tree/main/diseno/carcasa-mdf) |
