Juan100205/IOTPROYECTOFINAL3CORTE/wiki/2.-Solución-Propuesta.md

# 2. Solución propuesta

Esta sección documenta el diseño de **WaterGuard v9**, la versión del Challenge #3, según lo que pide el enunciado. La v9 conserva el nodo sensor de la v8 (medición en ISR y FreeRTOS, IRH, evaporación, alerta in situ y tablero embebido) y lo convierte en un **ecosistema IoT de tres capas**: nodo ESP32 → Gateway IoT en Raspberry Pi (MQTT, base de datos local y procesamiento) → plataforma en la nube con tablero global y módulo de IA.

## Alcance: una solución a la escala del departamento de Cundinamarca

La CAR identificó **20 municipios de Cundinamarca en riesgo extremo** de desabastecimiento por El Niño [2]. WaterGuard se plantea como una red que crece por niveles, sin rediseñar el nodo:

| Nivel | Qué se instala | Quién lo usa |
|---|---|---|
| **Punto de almacenamiento** | Un nodo WaterGuard por tanque, reservorio o bocatoma, con alerta in situ y tablero local en la WLAN | Fontanero, acueducto veredal, Junta de Acción Comunal |
| **Municipio** | Un Gateway (Raspberry Pi 5) que reúne los nodos de la zona por MQTT, guarda el histórico en una base de datos local y procesa los datos aunque se caiga Internet | Alcaldía, consejo municipal de gestión del riesgo (Ley 1523 de 2012 [30]) |
| **Departamento** | Plataforma en la nube con tablero global y módulo de IA, accesible desde cualquier parte de Colombia solo para usuarios autorizados | Gobernación (UAEGRD), CAR Cundinamarca, plan de contingencia de El Niño [4] |

Cada nivel sigue funcionando si falla el de arriba: el nodo alerta sin Gateway y el Gateway almacena y procesa sin Internet.

## Proceso de diseño

1. **Requisitos primero.** Del enunciado se extrajeron los requisitos R1–R13 ([sección 0.3](0.-Plan-del-Challenge-3)). Cada uno se convirtió en una prueba con criterio de aceptación antes de implementarlo (desarrollo guiado por pruebas, [sección 4](4.-Autoevaluación-del-Protocolo-de-Pruebas)).
2. **Ideación del hardware.** Sesiones de lluvia de ideas y *Crazy 8s* [59], bocetos y una maqueta en papel de bajo costo para definir la distribución de los componentes, su conectividad y la ubicación que permite tomar los datos del ambiente de la forma más fiel ([2.8.0](2.8.-Diseño-Mecánico-Carcasa-y-Empaque)).
3. **Prototipado y validación.** Plantillas de corte láser, carcasa en MDF, banco de pruebas v2 y simuladores locales para probar cada capa por separado antes de la integración.

Cada subsección es una página:

| Sección | Contenido |
|---|---|
| [2.1. Restricciones de diseño](2.1.-Restricciones-de-Diseño) | Técnicas, económicas, regulatorias, de espacio, escalabilidad y tiempo, con la decisión que resuelve cada una |
| [2.2. Arquitectura propuesta](2.2.-Arquitectura-Propuesta) | Diagramas de bloques de hardware y software, flujo de datos y seguridad en 3 capas |
| [2.3. Desarrollo teórico modular](2.3.-Desarrollo-Teórico-Modular) | Criterios de diseño y fórmulas: fusión de nivel, descenso, Tetens, DPV, Dalton, evaporación, IRH, anomalías y estados |
| [2.4. Diagramas UML](2.4.-Diagramas-UML) | Casos de uso, clases, secuencia, actividad por módulo, estados y despliegue |
| [2.5. Esquemático de hardware](2.5.-Esquemático-de-Hardware) | Componentes, pinout, esquemático y consideraciones eléctricas |
| [2.6. Estándares de ingeniería](2.6.-Estándares-de-Ingeniería) | IEEE 802.11, RFC 9110/6265/6762, FIPS 180-4, I2C, ISO/IEC 30141, OWASP ASVS y normativa colombiana |
| [2.7. Modelo de negocio](2.7.-Modelo-de-Negocio) | Lean Canvas, costos y viabilidad |
| [2.8. Diseño mecánico: carcasa y empaque](2.8.-Diseño-Mecánico-Carcasa-y-Empaque) | Cambio a MDF de 3 mm con corte láser, plantillas, cotas, DFM y empaque |

## Evolución v8 → v9

| Aspecto | v8 (Challenge #2) | v9 (Challenge #3) |
|---|---|---|
| Comunicación | HTTP en la WLAN, sin MQTT | **MQTT** nodo ↔ Gateway y Gateway ↔ nube [56] |
| Gateway IoT | No existía | **Raspberry Pi 5** con broker Mosquitto, base de datos local, procesamiento y módulo de IA |
| Histórico | 15 min en RAM del ESP32 | **Base de datos local SQLite** en el Gateway, con verificación de cada escritura y alerta crítica si falla |
| Tablero | Local, embebido en el ESP32 | Local (ESP32) + **global en LeMarTek Cloud** (ThingsBoard autoalojado), con alarmas, notificaciones y usuarios por rol |
| Inteligencia artificial | Análisis offline con K-Means | **Módulo de recomendación** con la API de Claude (Anthropic), prompts parametrizados y recuperación de contexto [57] |
| Alarma | Se silencia con el botón o desde el tablero local | También desde el tablero global, vía MQTT |
| Firmware | 3 tareas FreeRTOS | 4 tareas: se agrega `tMQTT` (núcleo 0) con cola de 120 muestras y LWT |
| Producto | Protoboard | Carcasa en MDF de 3 mm y empaque ([2.8](2.8.-Diseño-Mecánico-Carcasa-y-Empaque)) |

## Evolución v7 → v8

| Aspecto | v7 (Challenge #1) | v8 (Challenge #2) |
|---|---|---|
| Placa | Arduino Uno R3 | ESP32 DevKit V1 (WROOM-32) [8] |
| Alertas | Solo in situ | In situ + tablero web en la WLAN |
| Medición | En el `loop()` | ISR + tareas FreeRTOS [33] |
| Nivel | Solo HC-SR04 | HC-SR04 + MD-PS002 fusionados [6] |
| Evaporación | "Probabilidad" heurística por pesos (T agua 35, HR 30, luz 20, T aire 15) | Índice con base física: Dalton y DPV [9], [13] |
| Presión atmosférica | No se medía | BMP280 |
| Seguridad | No aplicaba | Filtro de subred + login SHA-256 + sesión atada a IP |
| Silenciar alarma | No existía | Botón físico y tablero |

La v7 y su documentación están en el [repositorio del Challenge #1](https://github.com/LeMarsito02/IOTPROYECTOFINAL1CORTE) y en su [wiki](https://github.com/LeMarsito02/IOTPROYECTOFINAL1CORTE/wiki).
