Juan100205/IOTPROYECTOFINAL3CORTE/wiki/1.-Resumen-General.md

**Proyecto:** Water Guard — Sistema IoT de monitoreo de disponibilidad hídrica
**Curso:** Internet de las Cosas — Facultad de Ingeniería, Universidad de La Sabana, 2026-2
**Reto:** Challenge #2
**Integrantes:** Santiago Peña Beltrán, Juan José Riaño Zabaleta

---

## 1.1. Motivación

Durante 2026, el Gobierno Nacional y el IDEAM confirmaron el inicio anticipado del Fenómeno de El Niño, lo que intensificó de forma crítica las vulnerabilidades hídricas de la Sabana de Bogotá y Cundinamarca [1]. La Corporación Autónoma Regional de Cundinamarca (CAR) identificó 20 municipios de la región en riesgo extremo de desabastecimiento hídrico e incendios forestales [2], y las autoridades distritales tipificaron el desabastecimiento de agua potable como uno de los escenarios de riesgo de mayor impacto para la región metropolitana [3].

El Plan de Contingencia departamental describe los mecanismos físicos detrás de esta crisis. El aumento de las temperaturas máximas favorece una mayor evapotranspiración [4, p. 6], y en el sector ambiental el balance hídrico de las cuencas se ve afectado por la disminución de la infiltración y el aumento de la evaporación [4, p. 17]. A esto se suma la sobredemanda de agua para actividades industriales y distritos de riego, que presiona los caudales de los ríos de la provincia de Sabana Centro. Frente a este panorama, las autoridades ordenaron robustecer el monitoreo hidrometeorológico continuo como estrategia de contingencia [4].

Sin embargo, las redes institucionales no alcanzan a cubrir con suficiente granularidad ni velocidad de respuesta los puntos críticos locales de suministro y almacenamiento: veredas, tanques comunitarios y pequeños reservorios. En esos puntos, tanto la comunidad como las autoridades municipales se beneficiarían de una alerta temprana en el sitio y de una vista en tiempo real de las variables, sin depender de servicios en la nube ni de conexión a internet. Este tipo de necesidad es la que motiva el Internet de las Cosas aplicado a la gestión de recursos y servicios públicos, donde objetos equipados con microcontroladores y transceptores se comunican para ofrecer servicios de valor agregado a la administración y a los ciudadanos [7, p. 22].

## 1.2. Justificación

Water Guard responde a esta necesidad con un sistema de monitoreo distribuido y de bajo costo que integra los cuatro módulos básicos de un sistema IoT: sensado, sistema embebido, comunicación de datos y análisis de datos [5, p. 1]. El sistema combina variables físicas del agua (nivel de almacenamiento y temperatura del agua) con variables meteorológicas asociadas al riesgo de escasez (temperatura ambiente, humedad relativa, radiación solar y presión atmosférica), y ofrece dos canales de alerta complementarios:

- **Alerta in situ:** LEDs, buzzer, pantalla OLED y un botón físico para silenciar la alarma. Funciona aunque se pierda la red.
- **Tablero de control local:** alojado en un servidor web embebido en el propio ESP32 y accesible desde un navegador de PC o celular, pero solo para dispositivos autorizados conectados a la WLAN de la zona. Muestra el valor actual y un histórico reciente de las variables, emite notificaciones y permite desactivar la alarma física.

Todo el procesamiento ocurre en el dispositivo y no en la nube. Este enfoque de cómputo en el borde (*edge computing*) ya se ha aplicado en sistemas IoT con interfaz web local [5, p. 2], y el procesamiento local en cada nodo es más eficiente que transmitir continuamente los datos crudos a un centro de cómputo [6, p. 29]. Para la comunidad, esto significa que la alerta no depende de la disponibilidad de internet, un recurso que en zonas rurales de Sabana Centro no siempre es confiable.

El sistema tampoco se limita a comparar el nivel del agua contra un umbral fijo. Fusiona múltiples señales en un **Índice de Riesgo Hídrico (IRH)**, aprovechando los beneficios de la fusión de datos multisensor: mejor detección, mayor confianza y confiabilidad, y menor ambigüedad de los datos [6, p. 28]. El nivel se mide con dos principios físicos distintos (ultrasonido y presión hidrostática), de modo que si un sensor falla el otro sostiene la medición, y si discrepan el sistema lo detecta y lo notifica. Además, reglas de fusión y una capa de detección de anomalías basada en la media y la desviación estándar de una ventana móvil [10, p. 24] permiten identificar eventos críticos complejos, como una tasa anómala de descenso del nivel bajo condiciones de calor extremo, que es justamente el tipo de evento que plantea la pregunta guía del reto.

Por último, y en línea con el mecanismo que el Plan de Contingencia identifica como agravante de la crisis [4, p. 6], Water Guard calcula un **índice de evaporación potencial** basado en el déficit de presión de vapor, es decir, la diferencia entre la presión de vapor de saturación y la presión de vapor real del aire [9, Cap. 3]. El índice combina ese déficit con la radiación solar, la temperatura ambiente y la presión atmosférica, y se presenta con número y categoría en palabras (BAJA / MEDIA / ALTA). Así, la comunidad puede anticipar no solo cuánta agua tiene disponible, sino qué tan expuesto está ese recurso a perderse por evaporación.

## 1.3. Estructura de la documentación

Esta wiki sigue las etapas del proceso de diseño de ingeniería aplicado al desarrollo de Water Guard:

- **Sección 2 — Solución propuesta:** restricciones de diseño, arquitectura de hardware y software, desarrollo modular (criterios de diseño, diagramas UML por módulo y esquemático de hardware), estándares de ingeniería aplicados y modelo de negocio.
- **Sección 3 — Configuración experimental, resultados y análisis:** pruebas sobre el prototipo funcional, incluyendo el tablero de control, la seguridad de acceso y el análisis de los datos registrados.
- **Sección 4 — Autoevaluación del protocolo de pruebas:** qué se probó, cómo, y qué tan completa fue la cobertura frente a los requisitos del reto (operación normal, degradada, de error y crítica; acceso autorizado y no autorizado).
- **Sección 5 — Conclusiones:** retos enfrentados, trabajo futuro y referencias.
- **Sección 6 — Anexos:** código fuente documentado, esquemáticos y material complementario.
- **Sección 7 — Roles y contribuciones:** actividades y aportes de cada integrante.
- **Sección 8 — Video demostrativo:** validación del funcionamiento del prototipo.
- **Sección 9 — Uso de herramientas de Inteligencia Artificial:** declaración del uso de asistentes de IA, conforme al enunciado.

---

### Referencias

Las citas de esta página remiten a la lista unificada en formato IEEE: [Referencias](Referencias).
