Juan100205/IOTPROYECTOFINAL3CORTE/wiki/2.4.-Diagramas-UML.md

# 2.4. Diagramas UML de la solución y de cada módulo

Los diagramas se hicieron a partir del código real de `WaterGuard_v8.ino`: los nombres de estructuras, funciones y constantes coinciden con el firmware. Como el firmware está escrito en C++ para Arduino, sin clases propias, el diagrama de clases modela las **estructuras de datos** y los **módulos** (grupos de funciones) como clasificadores.

## 2.4.1. Diagrama de casos de uso

```mermaid
flowchart LR
  AUT(["Autoridad local - PC o celular en la WLAN"])
  COM(["Comunidad junto al tanque"])
  ADM(["Técnico instalador"])

  subgraph WG["Sistema WaterGuard v8"]
    UC1(("Iniciar sesión en el tablero"))
    UC2(("Ver valores actuales"))
    UC3(("Ver histórico de 15 min"))
    UC4(("Recibir notificaciones"))
    UC5(("Silenciar o rearmar la alarma"))
    UC6(("Ver estado en OLED y LEDs"))
    UC7(("Silenciar con botón físico"))
    UC8(("Configurar red y credenciales, calibrar MD-PS002"))
    UC9(("Exportar log CSV por Serial"))
  end

  AUT --> UC1 & UC2 & UC3 & UC4 & UC5
  COM --> UC6 & UC7
  ADM --> UC8 & UC9
  UC2 -. "include" .-> UC1
  UC3 -. "include" .-> UC1
  UC5 -. "include" .-> UC1
```

## 2.4.2. Diagrama de clases (estructuras y módulos)

```mermaid
classDiagram
  direction LR
  class Lecturas {
    +float nivel
    +float nivelUS
    +float nivelP
    +float colAgua
    +long hxCrudo
    +float distancia
    +float tAgua
    +float tAmb
    +float humedad
    +float presion
    +float luminosidad
    +bool luz
    +bool hcOK
    +bool hxOK
    +bool nivelOK
    +bool discrepanciaNivel
    +bool dhtOK
    +bool dsOK
    +bool bmpOK
  }
  class Analitica {
    +float irh
    +float irhBase
    +float evap
    +float dpv
    +float descenso
    +int anomalias
    +uint8 sensoresDatos
    +bool reglaDescensoCalor
    +bool reglaNivelEvap
    +bool verificandoCritico
    +EstadoSistema estado
  }
  class EstadoSistema {
    <<enumeration>>
    NORMAL
    ALERTA
    CRITICO
    DEGRADADO
    ERROR
  }
  class Muestra {
    +uint32 t
    +float nivel
    +float tAgua
    +float tAmb
    +float hum
    +float pres
    +float lum
    +float evap
    +float irh
    +float colAgua
  }
  class Evento {
    +uint32 id
    +uint32 t
    +uint8 tipo
    +char msg
  }
  class Sesion {
    +char token
    +uint32 ip
    +uint32 ultimoUso
    +bool activa
  }
  class Intentos {
    +uint32 ip
    +uint8 fallos
    +uint32 desde
  }
  class ModuloSensores {
    <<tSensores>>
    +medirDistanciaUnaVez() float
    +medirDistancia() float
    +leerHX710B(crudo, espera) bool
    +tareaSensores()
  }
  class ModuloAnalitica {
    <<tAnalitica>>
    +agregarNivel(nivel)
    +calcularDescenso() float
    +presionSaturacion(T) float
    +calcularEvaporacion(L, A)
    +calcularIRH(L, A)
    +detectarAnomalia(x) bool
    +calcularEstado(L, A, actual) EstadoSistema
    +registrarEvento(tipo, texto)
  }
  class ModuloSalidas {
    <<tSalidas>>
    +actualizarOLED(L, A, pagina)
    +tareaSalidas()
  }
  class ModuloWeb {
    <<HiloPrincipal>>
    +filtroRed() bool
    +autorizado(esApi) bool
    +handleLoginPost()
    +handleEstado()
    +handleHistorial()
    +handleAlarma()
  }
  class ModuloSeguridad {
    +sha256Hex(s) String
    +igualesTiempoConstante(a, b) bool
    +crearSesion(ip) String
    +buscarSesion(tok, ip) int
    +ipBloqueada(ip) bool
    +clienteEnRedLocal(ip) bool
  }

  Analitica --> EstadoSistema
  ModuloSensores ..> Lecturas : escribe
  ModuloAnalitica ..> Lecturas : lee
  ModuloAnalitica ..> Analitica : escribe
  ModuloAnalitica "1" o-- "180" Muestra : historico
  ModuloAnalitica "1" o-- "25" Evento : registro
  ModuloSalidas ..> Analitica : lee
  ModuloWeb ..> ModuloSeguridad : usa
  ModuloSeguridad "1" o-- "6" Sesion
  ModuloSeguridad "1" o-- "8" Intentos
  ModuloWeb ..> Analitica : lee
  ModuloWeb ..> Muestra : serializa JSON
```

> Todo acceso a `Lecturas`, `Analitica`, `Muestra` y `Evento` pasa por el mutex `mtxDatos`. El bus I2C tiene su propio mutex, `mtxI2C`.

## 2.4.3. Diagrama de secuencia: medición del HC-SR04 por ISR

```mermaid
sequenceDiagram
  participant TS as tSensores
  participant HC as HC-SR04
  participant ISR as isrEcho (IRAM)
  TS->>TS: ulTaskNotifyTake(0) limpia avisos viejos
  TS->>HC: pulso TRIG de 10 us
  HC-->>ISR: flanco de subida en ECHO
  ISR->>ISR: echoInicioUs = esp_timer_get_time()
  HC-->>ISR: flanco de bajada en ECHO
  ISR->>ISR: echoDuracionUs = ahora - inicio
  ISR-->>TS: vTaskNotifyGiveFromISR()
  TS->>TS: ulTaskNotifyTake(40 ms)
  alt llegó la notificación
    TS->>TS: d = duración / 58,2 y valida 2-400 cm
  else timeout de 40 ms
    TS->>TS: NAN y fallosHC++
  end
  Note over TS: Se repite 3 veces y se toma la mediana
```

## 2.4.4. Diagrama de secuencia: login y consulta del tablero

```mermaid
sequenceDiagram
  actor U as Autoridad
  participant B as Navegador
  participant W as WebServer ESP32
  participant S as ModuloSeguridad
  U->>B: abre http://waterguard.local
  B->>W: GET /
  W->>S: filtroRed(IP)
  alt IP fuera de la subred
    W-->>B: 403 y evento de seguridad
  else IP local sin sesión
    W-->>B: 302 a /login
    B->>W: POST /login con usuario y clave
    W->>S: ipBloqueada(IP)
    W->>S: compara SHA-256(clave) con el hash en tiempo constante
    alt credenciales correctas
      S->>S: crearSesion(IP) con token de 128 bits
      W-->>B: Set-Cookie WGSESION HttpOnly SameSite=Strict y 302 a /
    else credenciales incorrectas
      S->>S: fallos++ (5 fallos = bloqueo de 2 min)
      W-->>B: 302 a /login?e=1
    end
  end
  loop cada 2 s
    B->>W: GET /api/estado con cookie
    W->>S: buscarSesion(token, IP)
    W-->>B: JSON con estado, IRH, valores, sensores y eventos
  end
  loop cada 10 s
    B->>W: GET /api/historial
    W-->>B: JSON con series de 180 muestras
  end
  U->>B: clic en Silenciar alarma
  B->>W: POST /api/alarma accion=silenciar
  W-->>B: sil = true y evento registrado
```

## 2.4.5. Diagrama de actividad: tarea de sensores (`tareaSensores`)

```mermaid
flowchart TD
  A(["Inicio de ciclo cada 500 ms"]) --> B["Medir distancia: 3 disparos y mediana"]
  B --> C{"¿d válida?"}
  C -- Sí --> C1["fallosHC = 0, N_US = (H - d) / H x 100"]
  C -- No --> C2["fallosHC++"]
  C1 --> D{"¿hxPresente?"}
  C2 --> D
  D -- Sí --> D1["leerHX710B: kPa a cm de agua"]
  D1 --> D2{"¿-5 ≤ col ≤ 1,5·H?"}
  D2 -- Sí --> D3["fallosHX = 0, N_P = col / H x 100"]
  D2 -- No --> D4["fallosHX++"]
  D -- No --> E{"¿pasaron 2 s?"}
  D3 --> E
  D4 --> E
  E -- Sí --> E1["Leer DHT11"]
  E -- No --> F{"¿pasó 1 s?"}
  E1 --> F
  F -- Sí --> F1["Leer DS18B20 sin bloqueo y pedir la siguiente conversión"]
  F1 --> F2["Leer BMP280 tomando mtxI2C"]
  F -- No --> G["Leer fotoresistencia en ADC1"]
  F2 --> G
  G --> H["Tomar mtxDatos"]
  H --> I["Actualizar banderas OK, solo tras MAX_FALLOS = 3"]
  I --> J{"¿Qué fuentes de nivel son válidas?"}
  J -- Ambas --> J1{"¿Diferencia ≤ 10 %?"}
  J1 -- Sí --> J2["N = promedio"]
  J1 -- No --> J3["N = mínimo y bandera de discrepancia"]
  J -- Solo una --> J4["N = la fuente válida"]
  J -- Ninguna --> J5["N = NAN"]
  J2 --> K["Liberar mtxDatos"]
  J3 --> K
  J4 --> K
  J5 --> K
  K --> L(["vTaskDelayUntil 500 ms"])
```

## 2.4.6. Diagrama de actividad: tarea de analítica (`tareaAnalitica`)

```mermaid
flowchart TD
  A(["Ciclo cada 1 s"]) --> B["Copiar Lecturas y Analitica con mtxDatos"]
  B --> C{"¿pasaron 2 s?"}
  C -- Sí --> C1["agregarNivel al buffer de 30 muestras"]
  C -- No --> D["calcularDescenso por mínimos cuadrados"]
  C1 --> D
  D --> E["calcularEvaporacion: Tetens, DPV e índice ponderado"]
  E --> F["calcularIRH: puntos normalizados + R1 + R2"]
  F --> G["detectarAnomalia sobre el IRH base: +5 por anomalía"]
  G --> H["calcularEstado: confirmación de 5 s e histéresis"]
  H --> I["Tomar mtxDatos y publicar"]
  I --> J{"¿Cambió el estado, R1, R2 o la salud de un sensor?"}
  J -- Sí --> J1["registrarEvento"]
  J -- No --> K{"¿Botón presionado y alarma sonando?"}
  J1 --> K
  K -- Sí --> K1["alarmaSilenciada = true"]
  K -- No --> L{"¿Silenciada y sin peligro, o pasaron 10 min?"}
  K1 --> L
  L -- Sí --> L1["Rearmar la alarma y registrar evento"]
  L -- No --> M{"¿pasaron 5 s?"}
  L1 --> M
  M -- Sí --> M1["Guardar muestra en el histórico"]
  M -- No --> N["Liberar mtxDatos y línea LOG CSV cada 2 s"]
  M1 --> N
  N --> O(["vTaskDelayUntil 1 s"])
```

## 2.4.7. Diagrama de actividad: tarea de salidas (`tareaSalidas`)

```mermaid
flowchart TD
  A(["Ciclo cada 50 ms"]) --> B["Copiar estado y silencio"]
  B --> C{"Estado del sistema"}
  C -- NORMAL --> C1["LED verde"]
  C -- ALERTA --> C2["LED amarillo"]
  C -- DEGRADADO --> C3["Amarillo intermitente, 600 ms"]
  C -- CRITICO --> C4["LED rojo y buzzer si no está silenciado"]
  C -- ERROR --> C5["Rojo y buzzer intermitentes, 250 ms"]
  C1 --> D{"¿pasaron 4 s?"}
  C2 --> D
  C3 --> D
  C4 --> D
  C5 --> D
  D -- Sí --> D1["Cambiar página de la OLED"]
  D -- No --> E{"¿pasó 1 s?"}
  D1 --> E
  E -- Sí --> E1["actualizarOLED con mtxI2C, filas 2 a 7"]
  E -- No --> F(["vTaskDelayUntil 50 ms"])
  E1 --> F
```

> La OLED usa solo las filas 2 a 7 porque las filas 0 y 1 de la unidad están dañadas físicamente (ver [Retos](5.-Conclusiones,-Retos-del-Desarrollo,-Trabajo-Futuro-y-Referencias)).

## 2.4.8. Diagrama de estados: sistema y alarma

La máquina de estados del sistema está en la sección [2.3.6](2.3.-Desarrollo-Teórico-Modular). La alarma física tiene su propio ciclo de vida:

```mermaid
stateDiagram-v2
  [*] --> Inactiva
  Inactiva --> Sonando: estado CRITICO o ERROR
  Sonando --> Inactiva: estado sale de CRITICO o ERROR
  Sonando --> Silenciada: botón físico o silenciar desde el tablero
  Silenciada --> Sonando: rearmar desde el tablero
  Silenciada --> Inactiva: sin peligro, rearme automático
  Silenciada --> Sonando: pasaron 10 min
```

## 2.4.9. Diagrama de despliegue

```mermaid
flowchart LR
  subgraph NODO["device: ESP32 DevKit V1"]
    subgraph N0["Núcleo 0"]
      WIFI["WiFi + pila lwIP"]
    end
    subgraph N1["Núcleo 1"]
      FW["WaterGuard_v8.ino: tSensores, tAnalitica, tSalidas, loop"]
    end
    HTML["LOGIN_HTML y DASH_HTML en PROGMEM"]
  end
  AP["device: router de la Alcaldía, WPA2 y DHCP"]
  CLI["device: PC o celular con navegador"]
  PCD["device: PC del técnico, Monitor Serial y Python"]
  NODO -- "IEEE 802.11 b/g/n" --- AP
  AP -- "HTTP :80 y mDNS" --- CLI
  NODO -- "USB-UART 115200 baud" --- PCD
```
