Juan100205/IOTPROYECTOFINAL3CORTE/agentes-documentacion/claude/2026-11-10.md

# Claude — 2026-11-10

## 00:14 — Pull y revisión del código v9
**Acción:** git pull (commits 0aef12f y f399be3 de Santiago). Revisión de `codigo/WaterGuard_v9/`, `codigo/gateway/`, `codigo/raspberry/` y `diseno/carcasa-impresa-3d/`. py_compile OK; prueba offline de BaseDatos + base estadística de la IA OK (60→31 %% en 30 min → 0,3 h al crítico).
**Archivos tocados:** ninguno del código (solo esta bitácora).
**Contexto:** El usuario pidió confirmar qué falta en temas de código.
**Pendiente / Próximo paso:** (1) alerta crítica cuando falla la escritura en SQLite (D8) no implementada; (2) servidor web local del Gateway no existe; (3) la IA no recupera episodios similares (la wiki dice RAG); (4) `anthropic==2.6.0` no aparece en el índice de pip de este equipo (máx. 0.125.0) y `wheels/` no está en el repo; (5) la wiki dice Vercel/Ubidots y tópicos `wg01`, `cmd/alarma`, `ia/recomendacion`, pero el código usa LeMarTek Cloud (ThingsBoard) y `nodo1`, `/cmd`, `/ia`; (6) carcasa: el repo trae diseño 3D en PETG y la wiki dice MDF; (7) sin evidencias de P1–P11; firmware sin compilar aquí.
**Estado:** 🔄 En progreso

## 00:26 — Alerta crítica por falla de la BD y alineación de la wiki con lo construido
**Acción:** Gateway: `_guardar()` envuelve cada escritura en SQLite; si falla, emite una alerta crítica (log CRITICAL, `waterguard/nodo1/ia` retenido → OLED y tablero local, `alerta_bd` en la nube vía `Plataforma.enviar_alerta_bd`), retiene en orden hasta 5000 escrituras y reintenta cada 2 s; al recuperarse vacía la cola, apaga la alerta y restablece la última IA. Prueba `codigo/gateway/pruebas/prueba_alerta_bd.py` superada. Wiki: 2.2.0 reescrita (LeMarTek Cloud/ThingsBoard, tópicos reales `nodo1`, IA real, seguridad, Figura 20), 2, 2.1 (T12–T16), 2.6 (MQTT 3.1.1 y RFC 6455), 2.7 (costo de la API de IA), 2.8 (3D descartada por calor), 3.5 (evidencias), 4.0.3, 6 (Anexo A v9), 0 (D2, D7, 0.6), Acta #2 y #3, Home, 9 (Tema 14), Referencias ([56] → MQTT 3.1.1, [60]). README alineado. Captura del tablero global en `assets/tablero-global-lemartek.png`.
**Archivos tocados:** `codigo/gateway/waterguard_gw.py`, `codigo/gateway/plataforma.py`, `codigo/gateway/pruebas/prueba_alerta_bd.py` (nuevo), `README.md`, `.gitignore` (`.playwright-mcp/`), `wiki/*`, `docs/actas/*.pdf`, `assets/tablero-global-lemartek.png`.
**Contexto:** El usuario pidió la alerta y alinear la wiki con lo hecho (LeMarTek y código). Las credenciales del tablero no se guardaron en ningún archivo; la carpeta temporal de Playwright, que las contenía, se borró.
**Pendiente / Próximo paso:** Crear en ThingsBoard la regla de alarma sobre `alerta_bd`. Santiago debe transcribir sus instrucciones de IA (sección 9, Tema 14). Faltan las pruebas P1–P11 en el banco con el sistema integrado, el video, los puntajes de las actas y cambiar la contraseña de la autoridad. Verificar `anthropic==2.6.0` en la Raspberry.
**Estado:** 🔄 En progreso

## 00:33 — Guion del video y precios de producción y venta
**Acción:** Sección 8 reescrita: guion de 5:00 en 7 bloques (presentación, contexto, solución ideal, banco de pruebas, producto, conexiones y código con líneas exactas, tableros e IA, comercialización y conclusiones), con capa funcional y técnica, responsables, checklist de grabación y correspondencia con las pruebas P1–P11. Sección 2.7: nuevas 2.7.4 (costo de producción en lote de 50: COP 249.600 por nodo; Gateway ≈ COP 600.000 por cotizar; costo de la IA) y 2.7.5 (precios de venta propuestos, ejemplo municipal y canales). Referencia [61]. README con el resumen de precios.
**Archivos tocados:** `wiki/8.-Video-Demostrativo.md`, `wiki/2.7.-Modelo-de-Negocio.md`, `wiki/Referencias.md`, `README.md`.
**Contexto:** El usuario pidió la estructura del video y los precios en la wiki. Los precios son una propuesta con supuestos explícitos; no se encontró un precio en COP de la Raspberry Pi 5.
**Pendiente / Próximo paso:** El equipo debe validar los precios. Grabar el video siguiendo el checklist 8.2 y agregar el enlace en la sección 8.
**Estado:** ✅ Completado

## 00:37 — Video: cambio de responsables
**Acción:** En el guion (sección 8.1), el bloque 5a (Producto) pasa a JJ y el 5c (Tableros e IA) pasa a SP.
**Archivos tocados:** wiki/8.-Video-Demostrativo.md
**Contexto:** Pedido del usuario.
**Pendiente / Próximo paso:** Enlace del video.
**Estado:** ✅ Completado

## 01:01 — Fuentes, stack, fotos del montaje, casos de prueba y sección 9
**Acción:** Referencias [30]–[32] con su Diario Oficial y el enlace al Gestor Normativo (verificados); nuevas [62] Res. ANE 105/2020 y [63]–[72] del stack. Citas agregadas en 2.1, 2.6 y 2.3 (10 afirmaciones sin fuente; 2.3 es igual a la del 2.º corte). Tabla "Tecnologías por componente" en 2.2.0. Montaje antiguo (Figuras 1 y 2) reemplazado por carcasa-mdf-v2 y empaque-abierto en 2.5.5, 3 y el README; se borraron `assets/Figura1_montaje.png` y `Figura2_montaje.png`; se conserva la OLED. Sección 4: 4.1 y 4.2 en markdown, con requisitos RF/RNF, casos de uso CU-01–04 y casos de prueba CP-01–12. Sección 9 reescrita: tabla de cumplimiento del enunciado, herramientas, forma de trabajo, consultas por etapa con redacción corregida y transcripción textual en un bloque `<details>`. Acta #2: estados "_por completar_" → 🔄.
**Archivos tocados:** `wiki/Referencias.md`, `wiki/2.1`, `2.2`, `2.3`, `2.5`, `2.6`, `3`, `4`, `7.1`, `9`, `README.md`, `assets/` (2 fotos borradas), `docs/actas/*.pdf`.
**Contexto:** Pedido del usuario de pulir la wiki. La transcripción textual se conserva porque el enunciado exige las instrucciones exactas.
**Pendiente / Próximo paso:** Transcripciones de los temas 8 y 14 (Santiago), consultas a ChatGPT sin transcribir, herramienta de mejora de imágenes por indicar.
**Estado:** ✅ Completado

## 01:58 — Pendientes omitidos, Gemini y puntajes de las actas
**Acción:** Sección 9: Gemini (Google) como herramienta de mejora de imágenes; se quitaron las marcas "Transcripción: pendiente" de los temas 8 y 14. Pies de foto en 2.5, 2.8 y 3 nombran a Gemini. Sección 3: se quitó la columna vacía "Resultado obtenido" de la tabla 3.3 y las notas de pendiente (resultados y foto en el banco). Actas: cumplimiento 4 en las 6 filas, se quitó la fila de hora del Acta #1 y la modalidad de las actas #1 y #3 quedó como "Sesión de trabajo del equipo". PDF regenerados.
**Archivos tocados:** wiki/9, 2.5, 2.8, 3, 7.1; docs/actas/*.pdf
**Contexto:** Pedido del usuario.
**Pendiente / Próximo paso:** Render del video en curso.
**Estado:** ✅ Completado

## 02:25 — Diagramas de la wiki en PNG
**Acción:** Se renderizaron localmente (Mermaid 11.4.1 en el navegador de Playwright, servido en 127.0.0.1) los 18 diagramas de la wiki a PNG de alta resolución en assets/diagramas/. Índice en el Anexo H.
**Archivos tocados:** assets/diagramas/*.png (18), wiki/6.-Anexos.md
**Contexto:** Pedido del usuario, en paralelo con el render del video.
**Pendiente / Próximo paso:** Ninguno.
**Estado:** ✅ Completado

## 02:36 — Video (borrador 1) en el repo y en la wiki
**Acción:** Se subió el borrador 1 del video a docs/video/WaterGuard_v9_video.mp4 (57 MB) con su portada (assets/video-portada.jpg). La sección 8 reemplaza el guion por la portada enlazada al reproductor de GitHub, el enlace de descarga y los capítulos con tiempos. El .gitignore ahora ignora solo /video/ (carpeta de edición en la raíz).
**Archivos tocados:** docs/video/WaterGuard_v9_video.mp4, assets/video-portada.jpg, wiki/8.-Video-Demostrativo.md, .gitignore
**Contexto:** Pedido del usuario mientras se renderiza la versión 2.
**Pendiente / Próximo paso:** Cuando termine la v2, reemplazar el archivo y actualizar los tiempos de los capítulos.
**Estado:** ✅ Completado

## 02:47 — Video v2 en el repo y en la wiki
**Acción:** docs/video/WaterGuard_v9_video.mp4 se reemplazó por la versión 2 (4:49: cortes en pausas naturales, fundidos cruzados entre bloques y entre tramos). Portada y capítulos de la sección 8 actualizados. El borrador 1 queda en video/salida/WaterGuard_v9_borrador1.mp4 (fuera del repo).
**Archivos tocados:** docs/video/WaterGuard_v9_video.mp4, assets/video-portada.jpg, wiki/8.-Video-Demostrativo.md
**Contexto:** Pedido del usuario.
**Pendiente / Próximo paso:** Captura del tablero global con datos (opcional).
**Estado:** ✅ Completado

## 02:50 — Enlace de Teams del video
**Acción:** La sección 8 y el README enlazan el video en Microsoft Stream (SharePoint de la universidad) como enlace principal; GitHub queda como alternativa.
**Archivos tocados:** wiki/8.-Video-Demostrativo.md, README.md
**Contexto:** El usuario compartió el enlace de Teams.
**Pendiente / Próximo paso:** Ninguno.
**Estado:** ✅ Completado

## 02:53 — Enlaces públicos en la portada
**Acción:** Recuadro "Enlaces públicos" en Home (tablero global, video en Stream y GitHub, repositorio, wiki y actas). En 2.2.0 el tablero global pasa a ser un enlace clicable. Se verificó que los tres sitios responden 200.
**Archivos tocados:** wiki/Home.md, wiki/2.2.-Arquitectura-Propuesta.md
**Contexto:** Pregunta del usuario.
**Pendiente / Próximo paso:** Ninguno.
**Estado:** ✅ Completado

## 14:09 — Guía del código y presentación para la sustentación
**Acción:** Página explicativa del código (artifact URJXicSZUHDQ2S5NQB2sjf) con 38 fragmentos reales y sus líneas. Deck de 18 diapositivas (artifact VPTqE6mde25ptQ2sZxpnfj) en el orden del video, con fragmentos de código, relación con el flujo y notas del orador por integrante.
**Archivos tocados:** ninguno del repo (artifacts privados).
**Contexto:** Preparación de la sustentación del 10 nov.
**Pendiente / Próximo paso:** Versión del pitch de 3 min en inglés si el equipo la quiere.
**Estado:** ✅ Completado
