Juan100205/IOTPROYECTOFINAL3CORTE/agentes-documentacion/claude/2026-11-09.md

# Claude — 2026-11-09

## 21:32 — Toma de contexto del proyecto
**Acción:** Lectura de README, wiki (plan del Challenge #3, actas, roles, video), enunciado, rúbrica, estructura del firmware v8 y fotos nuevas de la carcasa y el empaque. Creación de esta carpeta.
**Archivos tocados:** `agentes-documentacion/` (nuevo, estructura de bitácora).
**Contexto:** El usuario pidió tomar contexto de todo el proyecto. Hoy (9 nov) es la fecha límite de la wiki en Teams; sustentación el 10 nov 1:00 p. m.
**Pendiente / Próximo paso:** En el repo no hay código v9 (`WaterGuard_v9.ino`, `gateway/`); wiki sigue en v8; actas #2 y #3 vacías; secciones 7 y 8 sin actualizar; fotos nuevas sin commit. Esperar indicación del usuario sobre prioridades.
**Estado:** ✅ Completado

## 21:35 — Reorganización de carpetas
**Acción:** Se crearon `assets/` (12 imágenes), `codigo/` (`WaterGuard_v7/`, `WaterGuard_v8/` y `scripts/`) y `enunciado/` (enunciado, rúbrica y paper Terán-Aranda). Se actualizaron las rutas y se regeneraron los PDF de las actas.
**Archivos tocados:** `README.md` (rutas de imágenes, .ino y script), `wiki/3...md` (URL de las imágenes del banco), `wiki/6.-Anexos.md` (enlaces del firmware), `wiki/7.1...md` (comando del script), `codigo/scripts/actas_a_pdf.py` (raíz con `parents[2]`), `.gitignore` (`enunciado/` en lugar de `referencias/`), `docs/actas/*.pdf` (regenerados).
**Contexto:** El usuario pidió ordenar el repo. Los .ino van en carpetas con su mismo nombre porque lo exige el Arduino IDE.
**Pendiente / Próximo paso:** Hacer commit y push; sincronizar la wiki publicada en GitHub (repo .wiki aparte) con `wiki/`, o las imágenes de la sección 3 se rompen cuando se suba el push.
**Estado:** ✅ Completado

## 21:36 — Revisión de la wiki contra la nueva estructura
**Acción:** Se validaron todos los enlaces de `wiki/` hacia el repo (10/10 existen). Se clonó la wiki publicada en GitHub y se comparó: solo difieren las páginas 3, 6 y 7.1, que en la versión publicada tienen las 6 rutas viejas. En el plan (T11, T12) las rutas futuras se movieron a `codigo/gateway/` y `codigo/WaterGuard_v9/`.
**Archivos tocados:** `wiki/0.-Plan-del-Challenge-3.md` (rutas del entregable de T11 y T12).
**Contexto:** Que la wiki quede coherente con la reorganización de carpetas.
**Pendiente / Próximo paso:** Commit y push del repo y, en el mismo momento, copiar `wiki/` al repo .wiki y hacer push (páginas 0, 3, 6 y 7.1).
**Estado:** ✅ Completado

## 21:50 — Diseño mecánico MDF en la wiki y Acta #2
**Acción:** Nueva página `wiki/2.8.-Diseño-Mecánico-Carcasa-y-Empaque.md` (decisión de MDF de 3 mm, cotas extraídas de las plantillas, DFM, empaque, limitaciones). Acta #2 llena. Se actualizaron 2, 2.1 (E4, temporales, nueva 2.1.7 Ambientales), 2.5.5, 2.6 (2.6.5), 2.7 (BOM: total de 265.700), 3 (3.1.1 banco v2), 5 (reto y trabajo futuro), 6 (Anexo G), 9 (Temas 11 y 12), 0 (D6, T21–T23, T26, T30), Home, Sidebar (sin el duplicado), Referencias ([54] EN 622-5 y [55] IEC 60529) y README. Plantillas en `diseno/carcasa-mdf/v1` y `v2.0`; fotos renombradas en `assets/`; vistas previas PNG de las plantillas; `.gitignore` con excepción `!diseno/**/*.pdf`. PDF de las actas regenerados.
**Archivos tocados:** los de arriba, más `docs/actas/*.pdf`.
**Contexto:** El usuario pidió documentar el nuevo diseño en MDF (economía, tiempo, facilidad, biodegradabilidad), las fotos, el banco v2 y los costos (carcasa 35.000 y caja 10.000). Las fotos son reales y fueron mejoradas con IA, que alteró el texto de la caja (LoRa, IP65, CE/FCC); se aclaró en los pies de figura y en la sección 9.
**Pendiente / Próximo paso:** El usuario debe confirmar los supuestos: responsables en el Acta #2, que el panel solar no esté conectado, la herramienta de IA de las fotos, la hora y modalidad del Acta #2, y los puntajes. También faltan los estados de T10–T12, T31 y T32 en el Acta #2, una foto del banco v2 con la carcasa, y el commit, el push y la sincronización de la wiki publicada.
**Estado:** 🔄 En progreso

## 22:15 — Acta #2 cerrada, commit y push del repo y la wiki
**Acción:** Acta #2: viernes 6 nov, 2:00 p. m., modalidad virtual (remota). PDF regenerados. Commit 350477f en main con push; wiki publicada sincronizada (commit 1c88bdd en master), idéntica a `wiki/`.
**Archivos tocados:** `wiki/7.1...md`, `docs/actas/*.pdf`; repo .wiki.
**Contexto:** El usuario confirmó la hora y la modalidad y autorizó completar.
**Pendiente / Próximo paso:** Puntajes de cumplimiento (1–5), herramienta de IA de las fotos, estados de software en el Acta #2, foto del banco v2 con la carcasa; actualizar el resto de la wiki a v9 cuando exista el código.
**Estado:** ✅ Completado

## 22:20 — Corrección de la fecha del Acta #2
**Acción:** El Acta #2 pasa del 7 al **viernes 6 de noviembre de 2026** en 7.1 (tabla y encabezado), 2.8, plan (D6, Gantt, tabla por día y tabla de reuniones). PDF regenerados.
**Archivos tocados:** `wiki/7.1...md`, `wiki/2.8...md`, `wiki/0.-Plan-del-Challenge-3.md`, `docs/actas/*.pdf`.
**Contexto:** El usuario indicó la fecha correcta. El 7 nov 2026 es sábado.
**Pendiente / Próximo paso:** En el plan y en las actas #1 y #3 los días de la semana están corridos (3 nov 2026 = martes, no lunes; 10 nov = martes). Pendiente de confirmar con el usuario.
**Estado:** ✅ Completado

## 23:10 — Solución propuesta v9, arquitectura, TDD y Acta #3
**Acción:** Sección 2: alcance departamental (punto, municipio, departamento), proceso de diseño y evolución v8→v9. 2.2.0: ecosistema de tres capas (mermaid, componentes, tópicos MQTT, SQLite con verificación de escritura y alerta crítica, IA con ChatGPT, prompts parametrizados y RAG, seguridad). 2.8.0: ideación (Crazy 8s y maqueta en papel, `assets/ideacion-maqueta-papel.jpeg`). 4.0: TDD con trazabilidad R1–R13 → P1–P11 y fallas encontradas en el banco. Acta #3 = lunes 9 nov, 2:00 p. m. (ensamblaje, pruebas, plan de código y cierre); se eliminó la del 10. Plan: D3 → ChatGPT, D7 (tablero en Vercel), D8 (BD local). Home y Sidebar pasan a v9. Referencias [56]–[59]. Sección 9, Tema 13.
**Archivos tocados:** `wiki/2.-Solución-Propuesta.md`, `wiki/2.2...`, `wiki/2.8...`, `wiki/4...`, `wiki/7.1...`, `wiki/9...`, `wiki/0...`, `wiki/Home.md`, `wiki/_Sidebar.md`, `wiki/Referencias.md`, `docs/actas/*.pdf`, `assets/ideacion-maqueta-papel.jpeg`.
**Contexto:** El usuario dio el plan de código de la sesión de hoy. Solo el tablero en Vercel existe hoy; lo demás se redacta como diseño (el usuario pidió no señalar en la wiki qué falta). No se escribieron resultados de pruebas inexistentes.
**Pendiente / Próximo paso:** Modalidad del Acta #3 y puntajes; URL del tablero de Vercel; elegir el broker MQTT en la nube (Ubidots, HiveMQ u otro); implementar los compromisos 1–5 del Acta #3 y subir el código a `codigo/`; registrar los resultados de P1–P11 en la sección 3; video (sección 8).
**Estado:** 🔄 En progreso

## 23:23 — IA de vuelta a Claude y push
**Acción:** El proveedor del módulo de IA vuelve a la API de Claude (Anthropic) en 0 (D3), 2, 2.2.0, Acta #3, Home y 9. Se conservan la transcripción literal y el uso histórico de ChatGPT. PDF regenerados.
**Archivos tocados:** wiki/0, 2, 2.2, 7.1, 9, Home; docs/actas/*.pdf
**Contexto:** Pedido del usuario: subir el estado actual con Claude como IA.
**Pendiente / Próximo paso:** Los mismos de la entrada anterior (URL de Vercel, broker en la nube, modalidad y puntajes, video).
**Estado:** ✅ Completado

## 23:31 — Código v9 preparado en el repo y README v9
**Acción:** Se copió el código del Challenge #3 desde la sesión de Santiago: firmware `codigo/WaterGuard_v9/` (MQTT, cola offline, comandos e IA; WiFi con valores de ejemplo), gateway `codigo/gateway/` (MQTT → SQLite → nube, módulo de IA con Claude y respaldo estadístico, simulador), `codigo/raspberry/` (SD autoconfigurable con cloud-init, Mosquitto con ACL, servicio systemd), `codigo/lemartek-cloud/` (ThingsBoard + puente MQTT-WS + túnel Cloudflare) y `diseno/carcasa-impresa-3d/` (OpenSCAD y STL). README reescrito a v9. `.gitignore` excluye secretos (`*.env`, credenciales, token del túnel), wheels e imágenes de la SD. Cambios en staging, sin commit: el commit y el push los hace Santiago.
**Archivos tocados:** `README.md`, `.gitignore`, `codigo/WaterGuard_v9/`, `codigo/gateway/`, `codigo/raspberry/`, `codigo/lemartek-cloud/`, `diseno/carcasa-impresa-3d/`.
**Contexto:** Santiago pidió preparar el código y actualizar el README. La nube real es LeMarTek Cloud (ThingsBoard en servidor propio, en https://iot.lemartek.cloud).
**Pendiente / Próximo paso:** Commit y push (Santiago). La wiki aún dice Ubidots STEM (D2) y tablero en Vercel (D7); hay que alinearla con LeMarTek Cloud. Registrar resultados de P1–P11 con el sistema integrado.
**Estado:** 🔄 En progreso

## 23:45 — Se retira lemartek-cloud del repo
**Acción:** Se quitó `codigo/lemartek-cloud/` del repositorio y se agregó al `.gitignore`. El README ya no enlaza esa carpeta: LeMarTek Cloud se describe como infraestructura privada.
**Archivos tocados:** `codigo/lemartek-cloud/` (eliminada del repo), `README.md`, `.gitignore`.
**Contexto:** Santiago indicó que la configuración de LeMarTek Cloud no debía publicarse. No contenía secretos (sin `.env`, token ni credenciales).
**Pendiente / Próximo paso:** Commit y push (Santiago).
**Estado:** 🔄 En progreso
