Juan100205/IOTPROYECTOFINAL3CORTE/assets/diagramas/01-plan-meta-v9.png

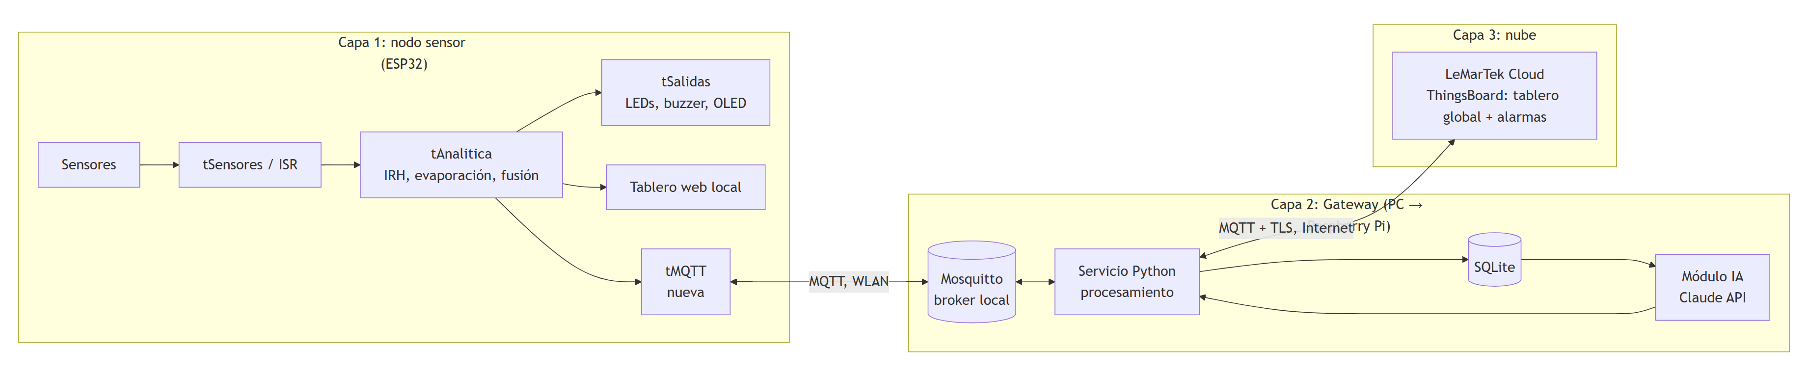
assets/diagramas/01-plan-meta-v9.png
