Juan100205/IOTPROYECTOFINAL3CORTE/assets/diagramas/02-plan-cronograma-gantt.png

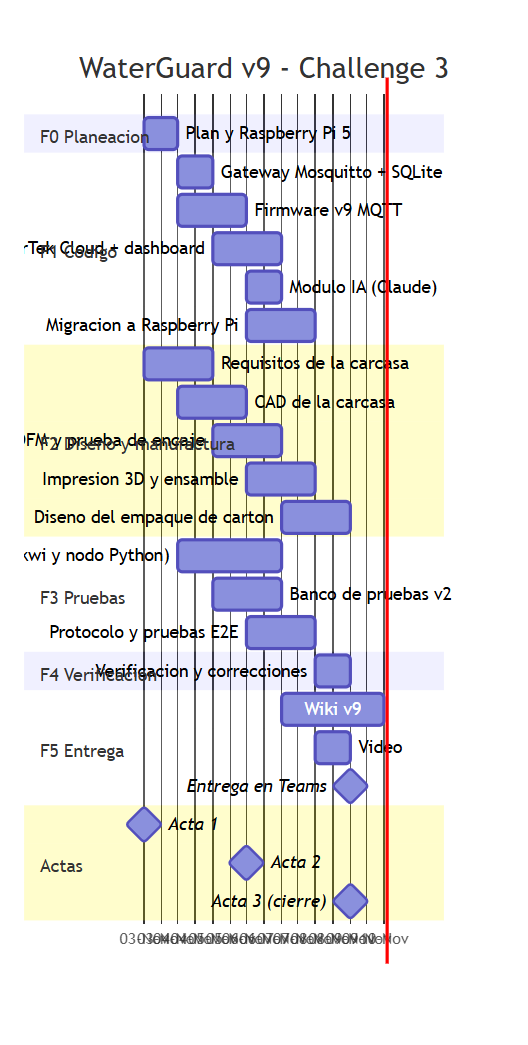
assets/diagramas/02-plan-cronograma-gantt.png
