Juan100205/IOTPROYECTOFINAL3CORTE/assets/diagramas/03-arquitectura-ecosistema-v9.png

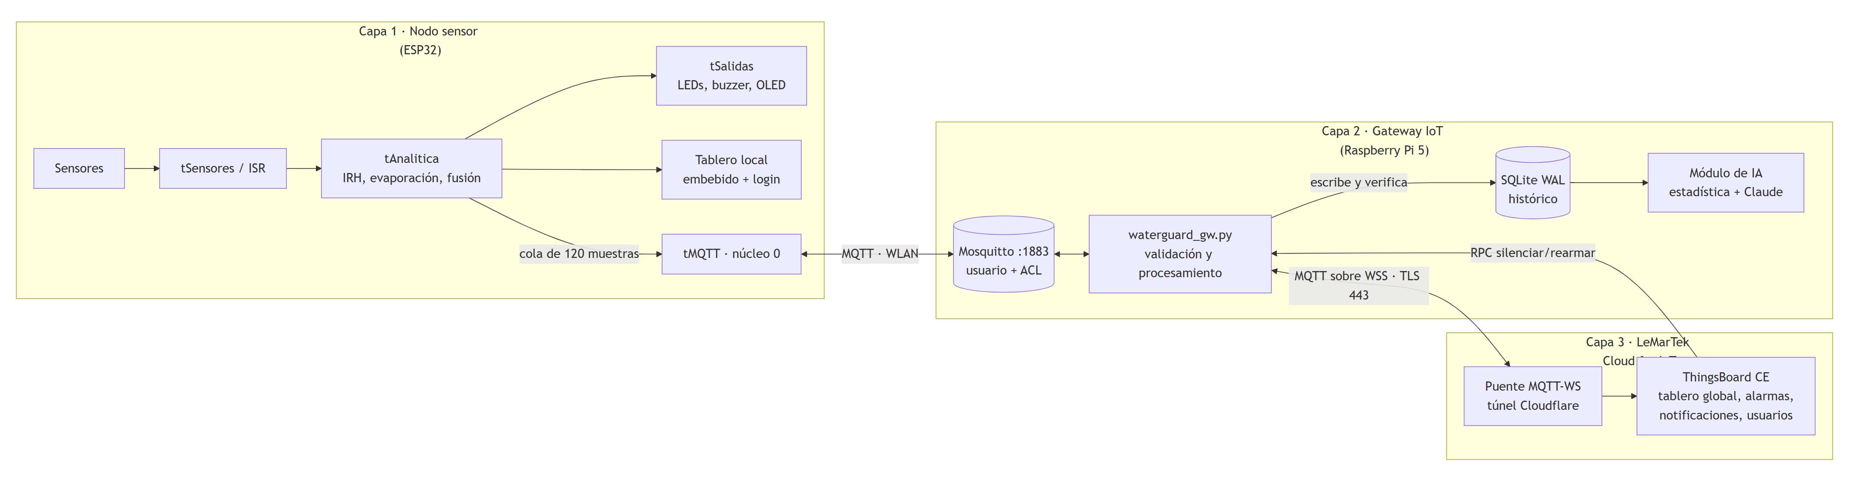
assets/diagramas/03-arquitectura-ecosistema-v9.png
