Juan100205/IOTPROYECTOFINAL3CORTE/assets/diagramas/04-arquitectura-alerta-bd.png

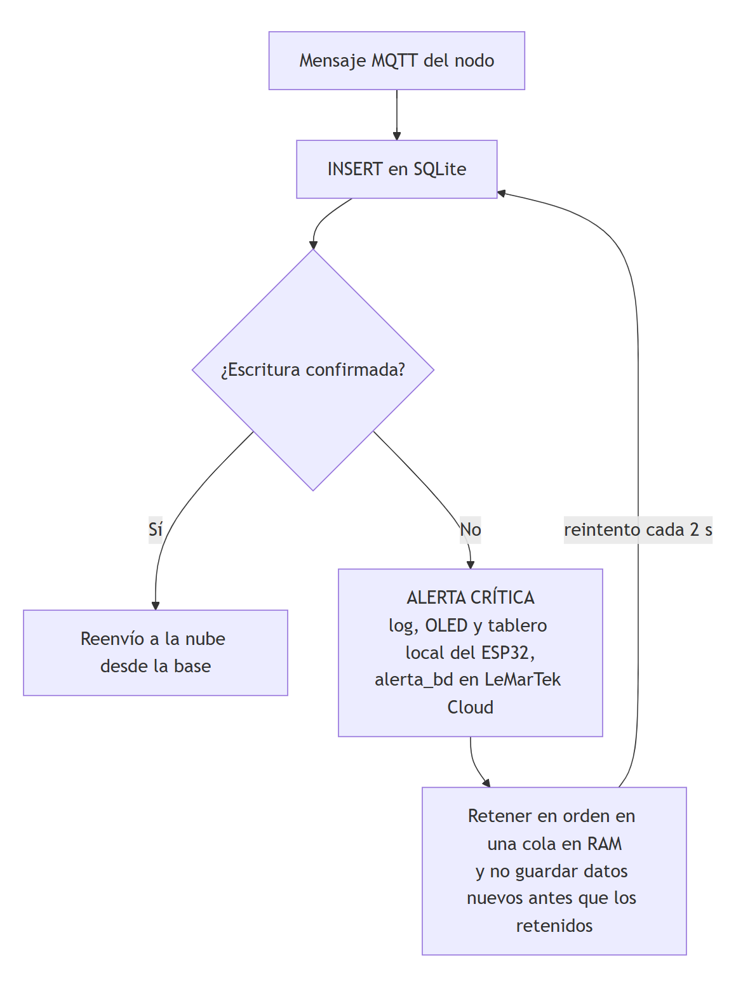
assets/diagramas/04-arquitectura-alerta-bd.png
