Juan100205/IOTPROYECTOFINAL3CORTE/assets/diagramas/05-arquitectura-bloques-hardware.png

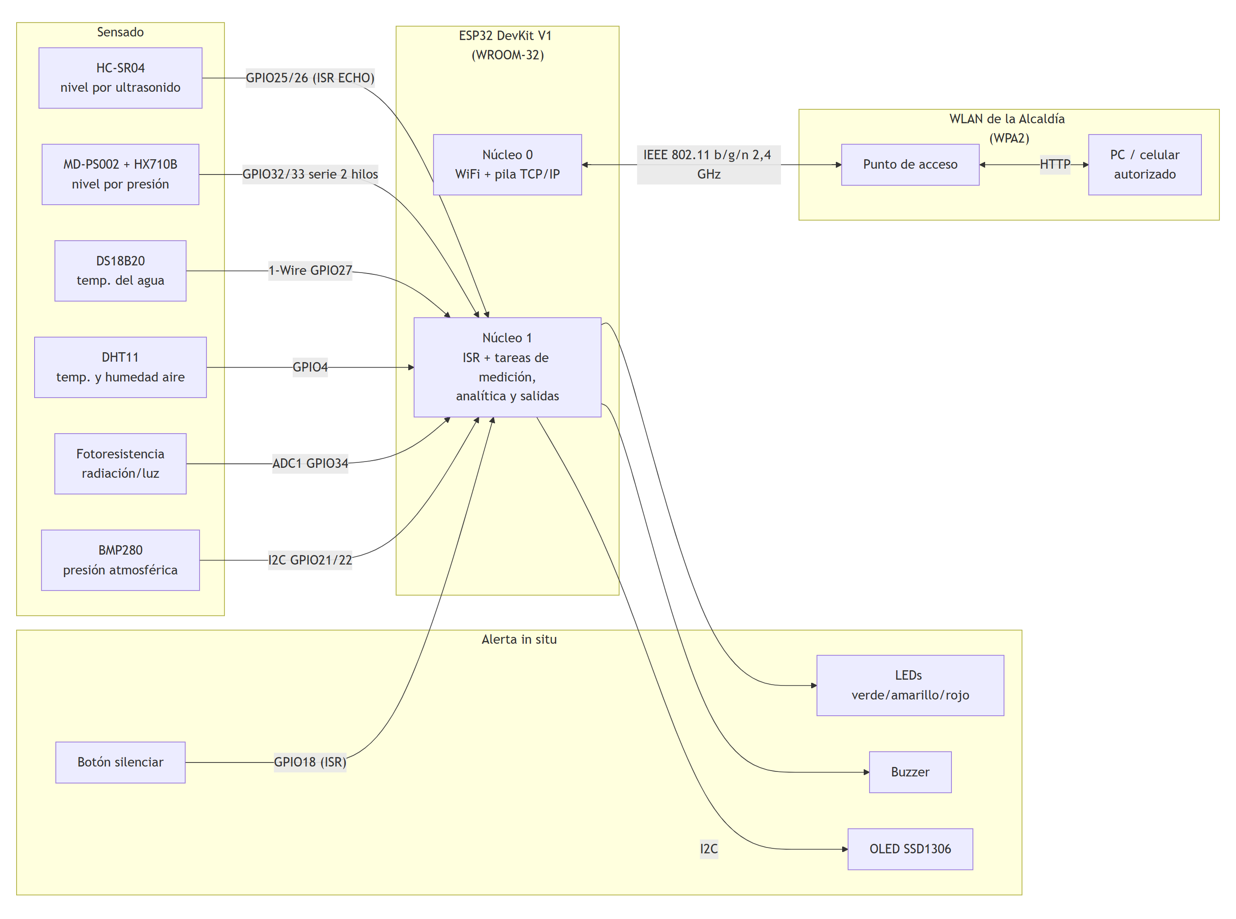
assets/diagramas/05-arquitectura-bloques-hardware.png
