Juan100205/IOTPROYECTOFINAL3CORTE/assets/diagramas/06-arquitectura-bloques-software.png

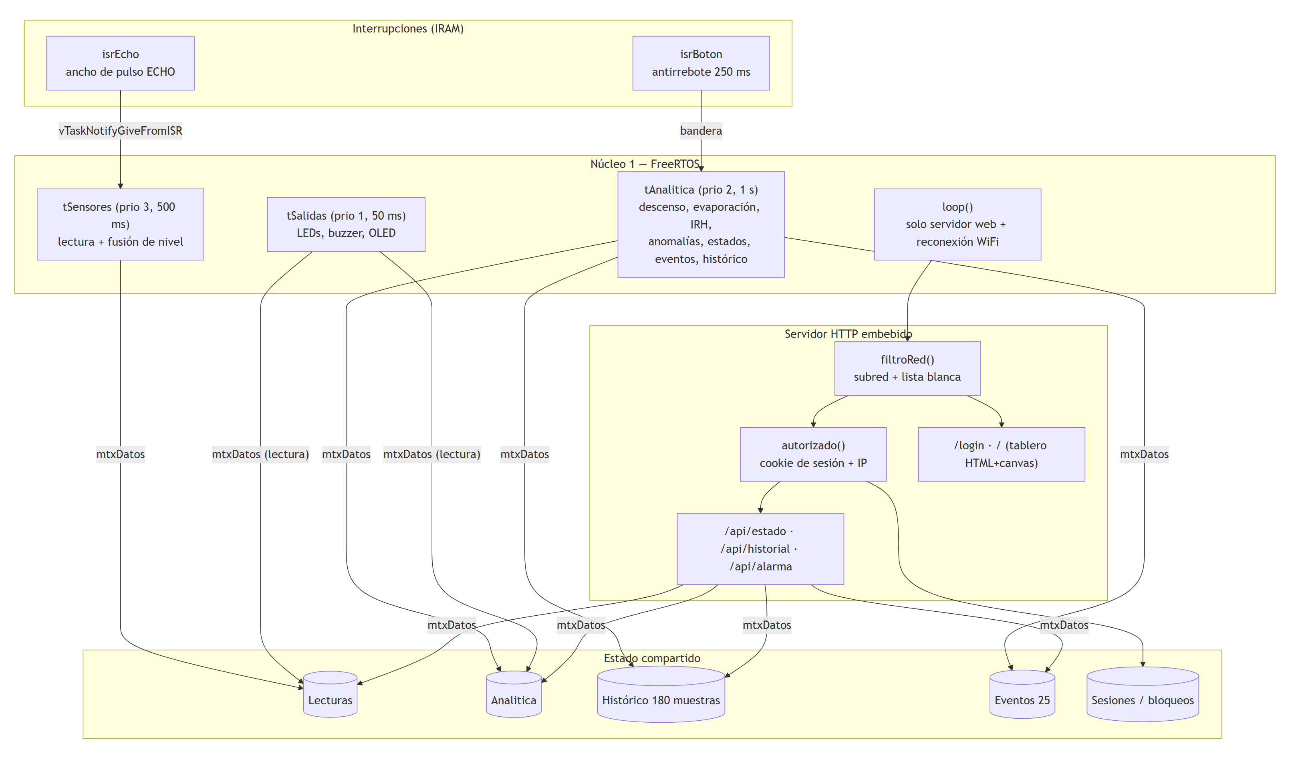
assets/diagramas/06-arquitectura-bloques-software.png
