Juan100205/IOTPROYECTOFINAL3CORTE/assets/diagramas/07-arquitectura-flujo-datos.png

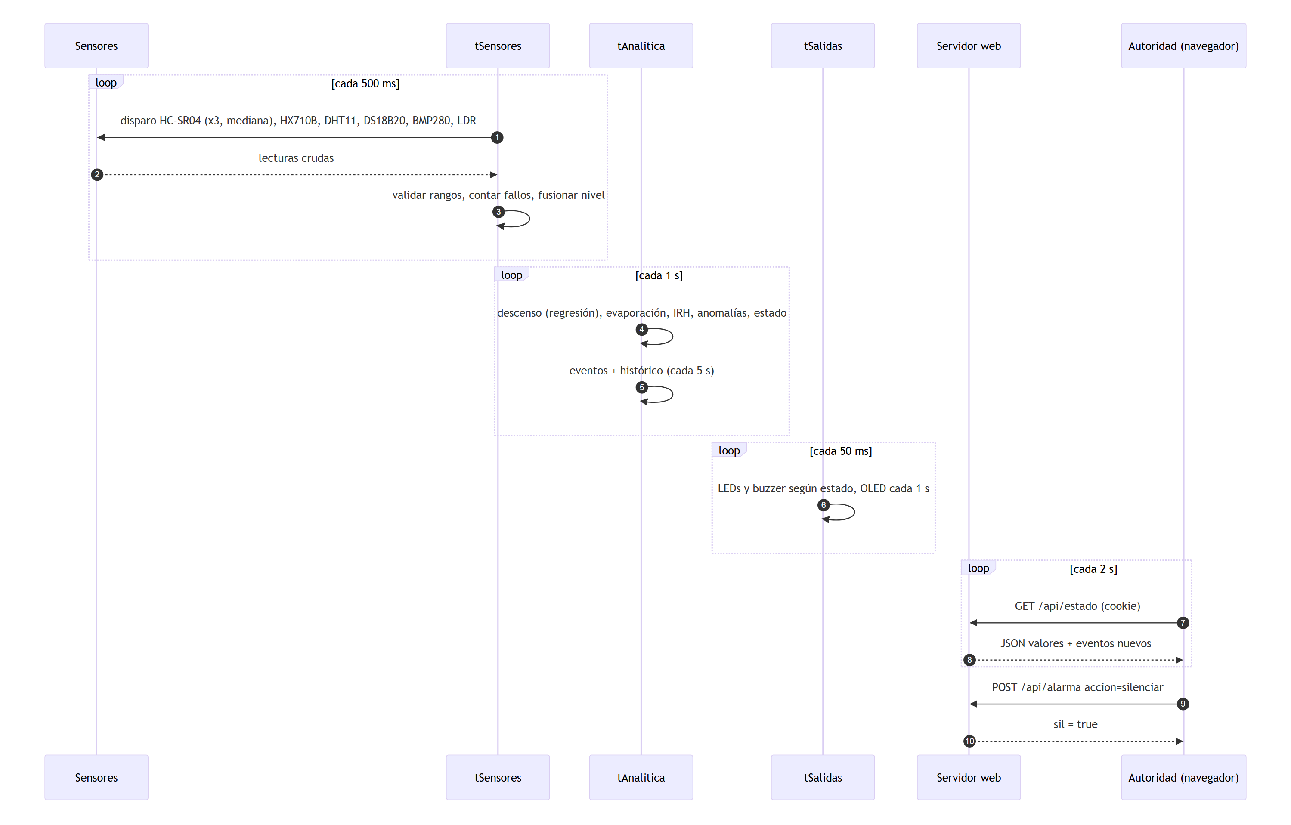
assets/diagramas/07-arquitectura-flujo-datos.png
