Juan100205/IOTPROYECTOFINAL3CORTE/assets/diagramas/08-teorico-maquina-estados.png

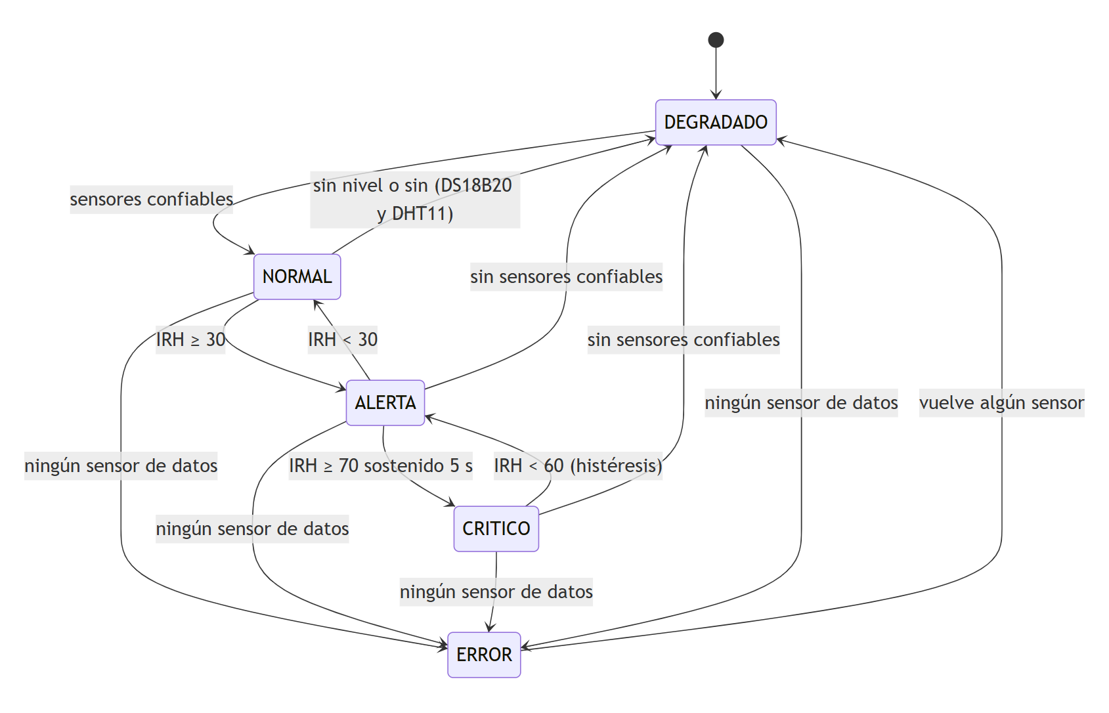
assets/diagramas/08-teorico-maquina-estados.png
