Juan100205/IOTPROYECTOFINAL3CORTE/assets/diagramas/09-uml-casos-de-uso.png

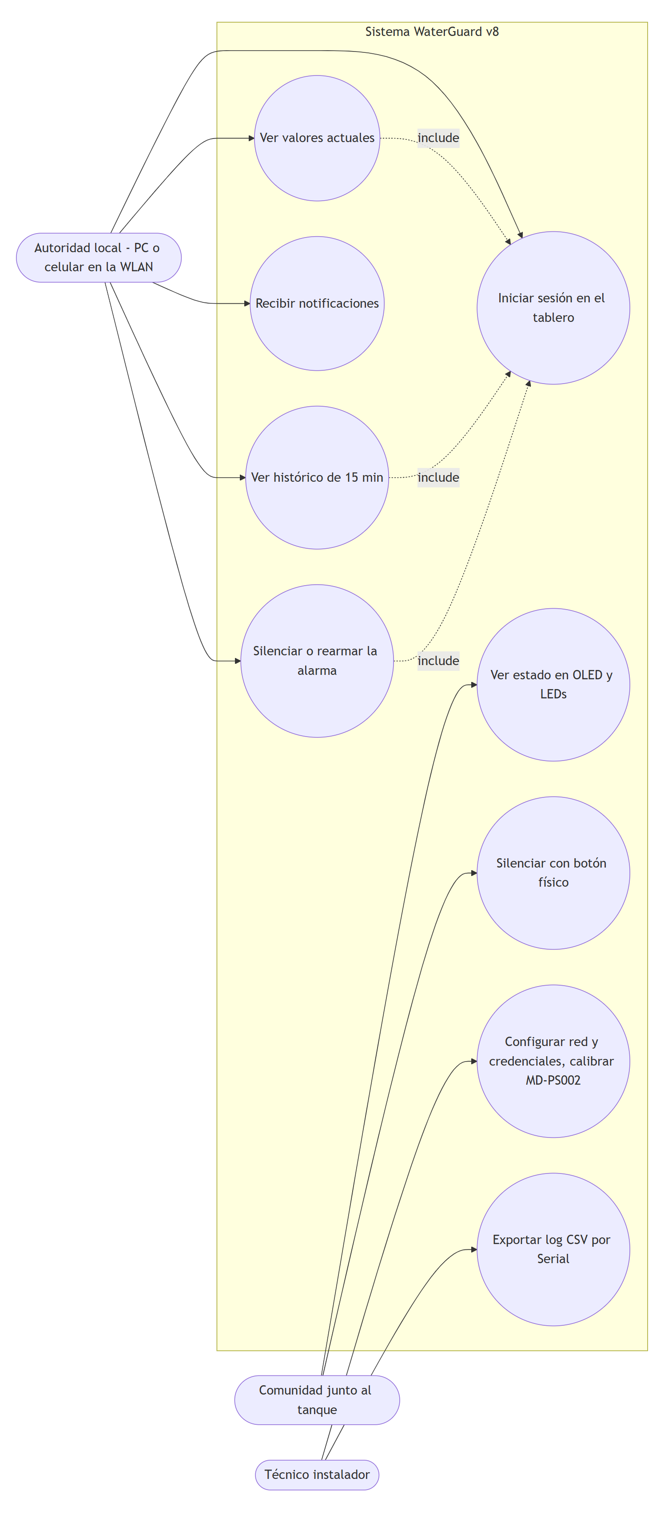
assets/diagramas/09-uml-casos-de-uso.png
