Juan100205/IOTPROYECTOFINAL3CORTE/assets/diagramas/10-uml-clases.png

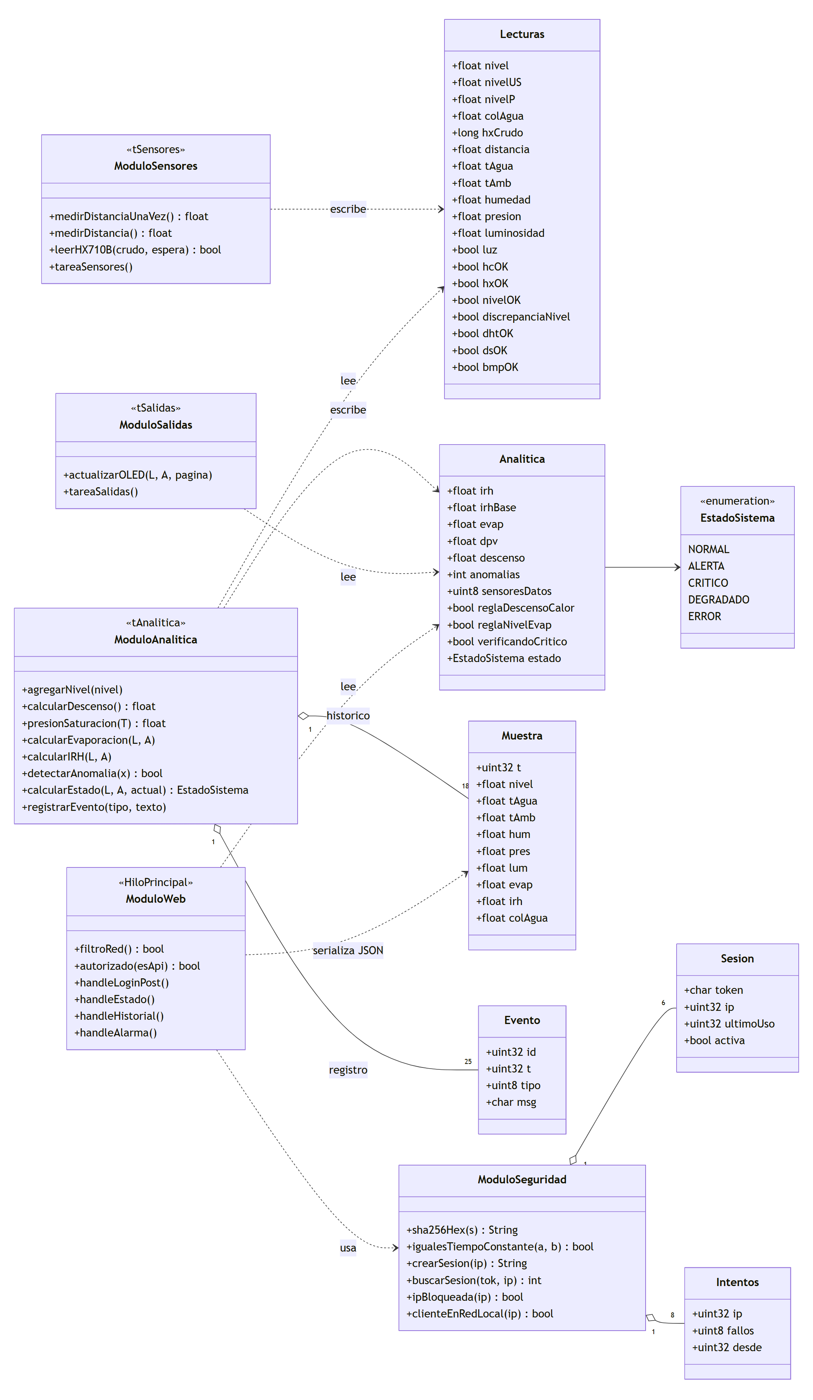
assets/diagramas/10-uml-clases.png
