Juan100205/IOTPROYECTOFINAL3CORTE/assets/diagramas/11-uml-secuencia-hcsr04-isr.png

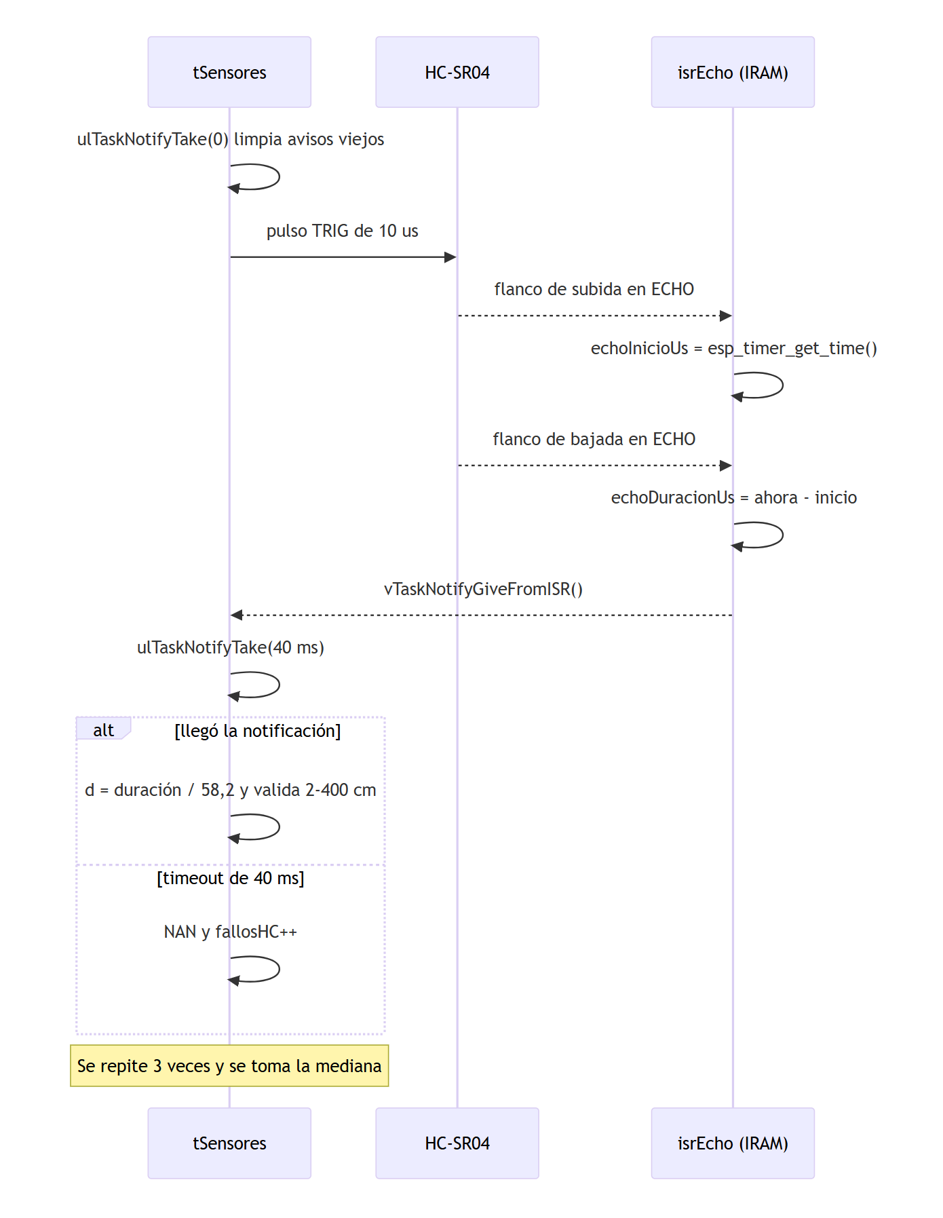
assets/diagramas/11-uml-secuencia-hcsr04-isr.png
