Juan100205/IOTPROYECTOFINAL3CORTE/assets/diagramas/12-uml-secuencia-login-tablero.png

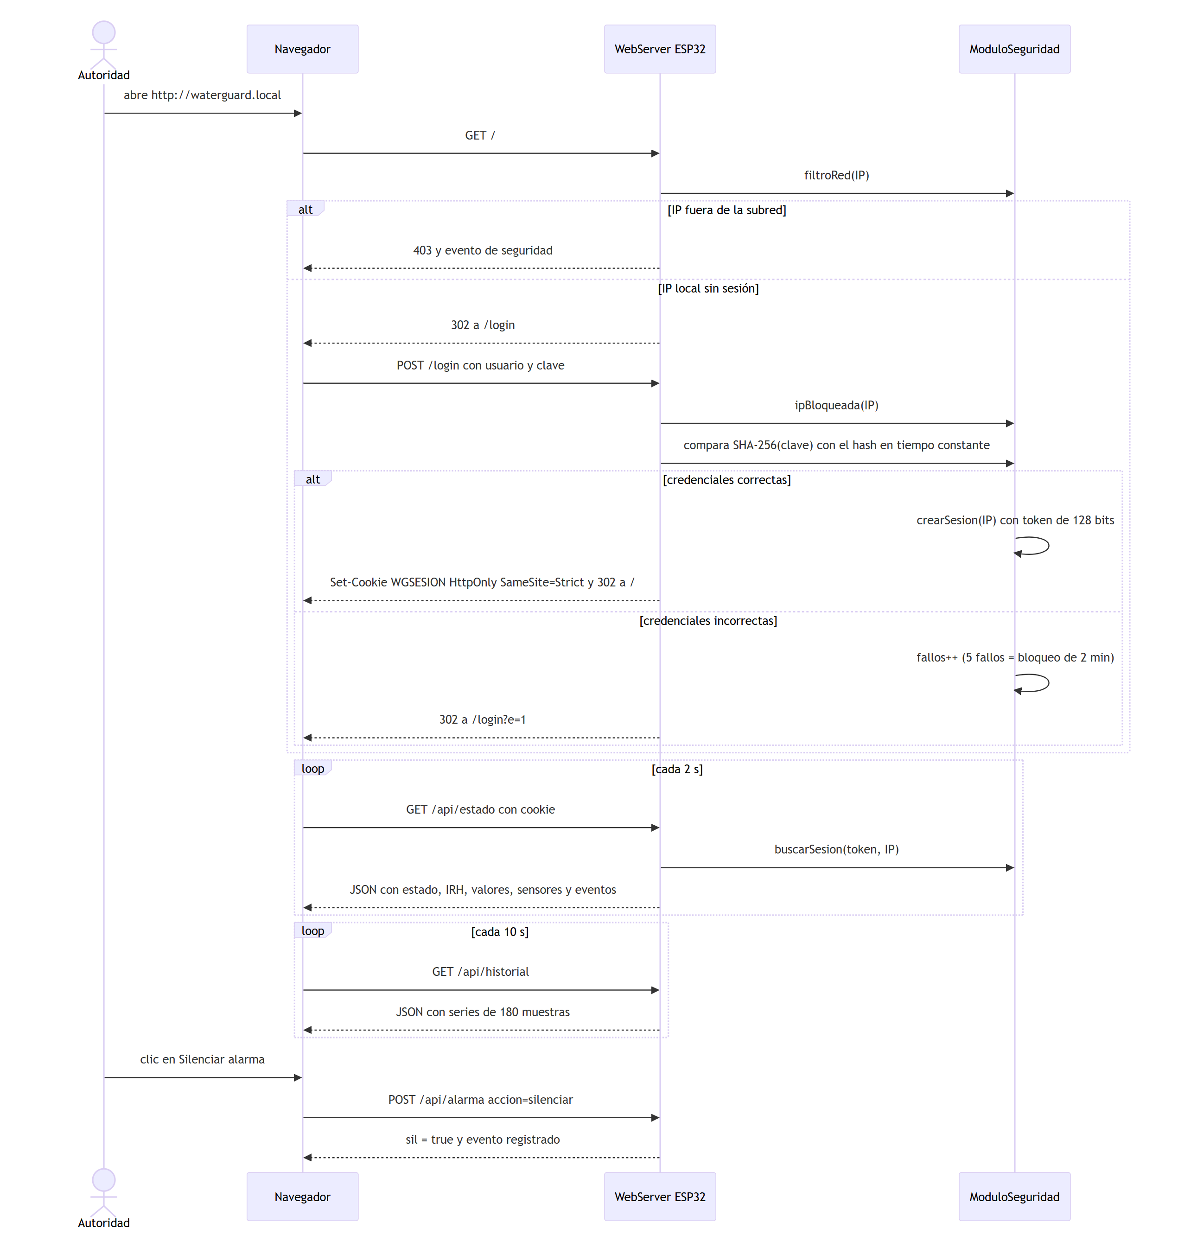
assets/diagramas/12-uml-secuencia-login-tablero.png
