Juan100205/IOTPROYECTOFINAL3CORTE/assets/diagramas/13-uml-actividad-tarea-sensores.png

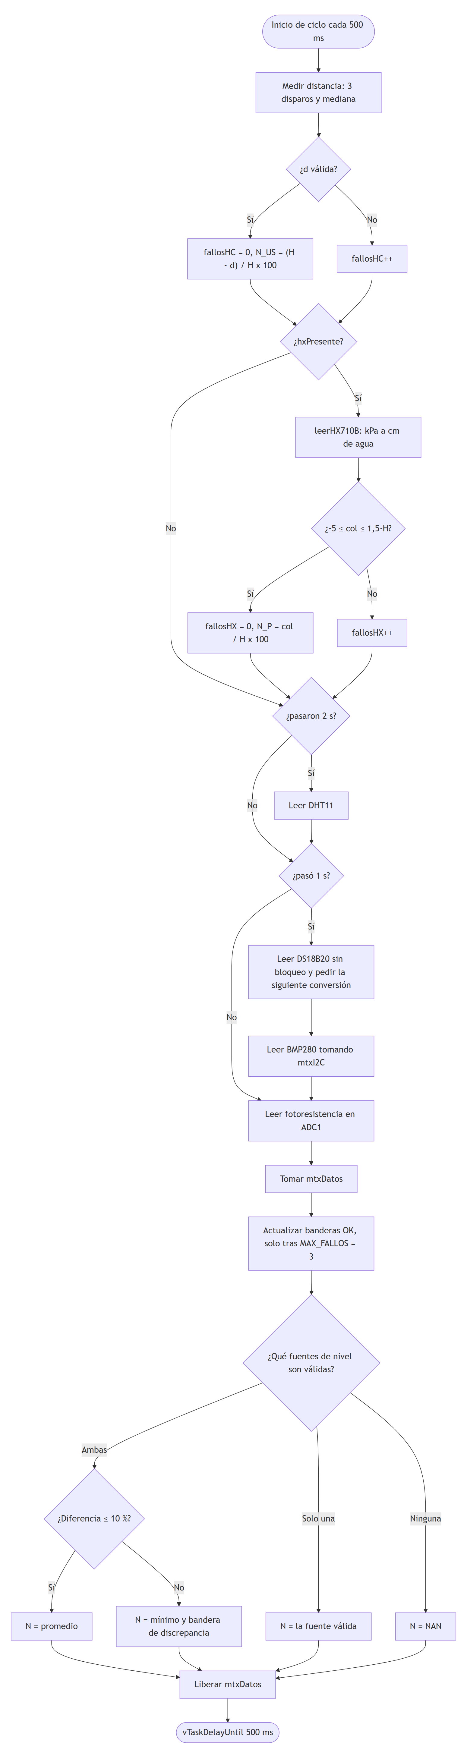
assets/diagramas/13-uml-actividad-tarea-sensores.png
