Juan100205/IOTPROYECTOFINAL3CORTE/assets/diagramas/14-uml-actividad-tarea-analitica.png

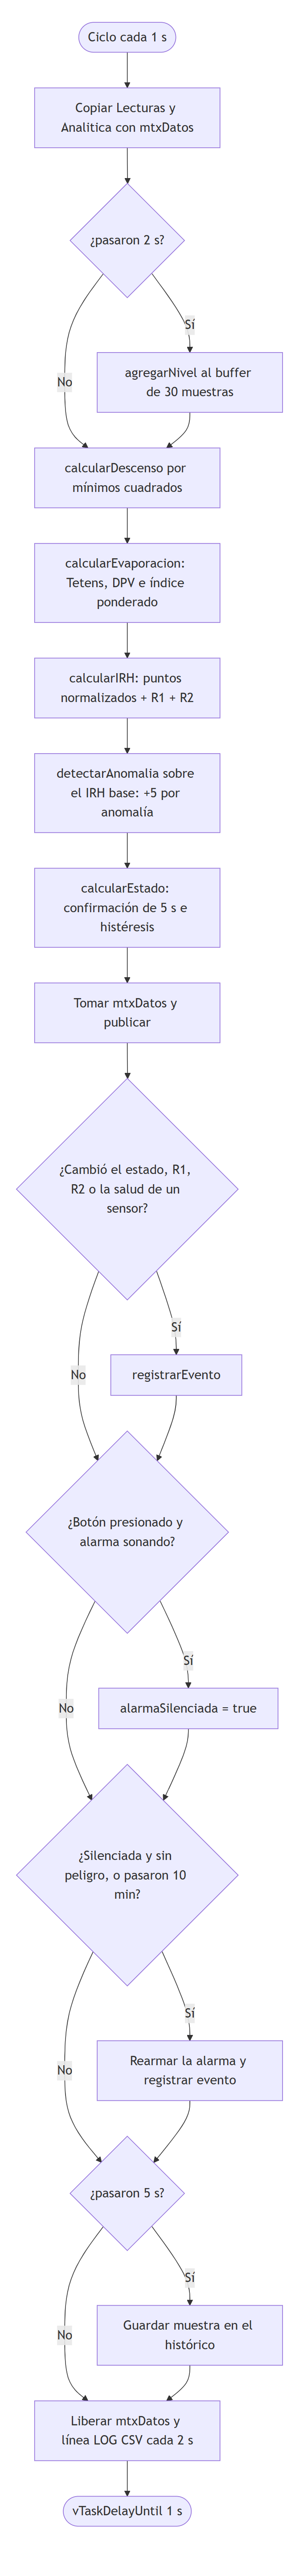
assets/diagramas/14-uml-actividad-tarea-analitica.png
