Juan100205/IOTPROYECTOFINAL3CORTE/assets/diagramas/15-uml-actividad-tarea-salidas.png

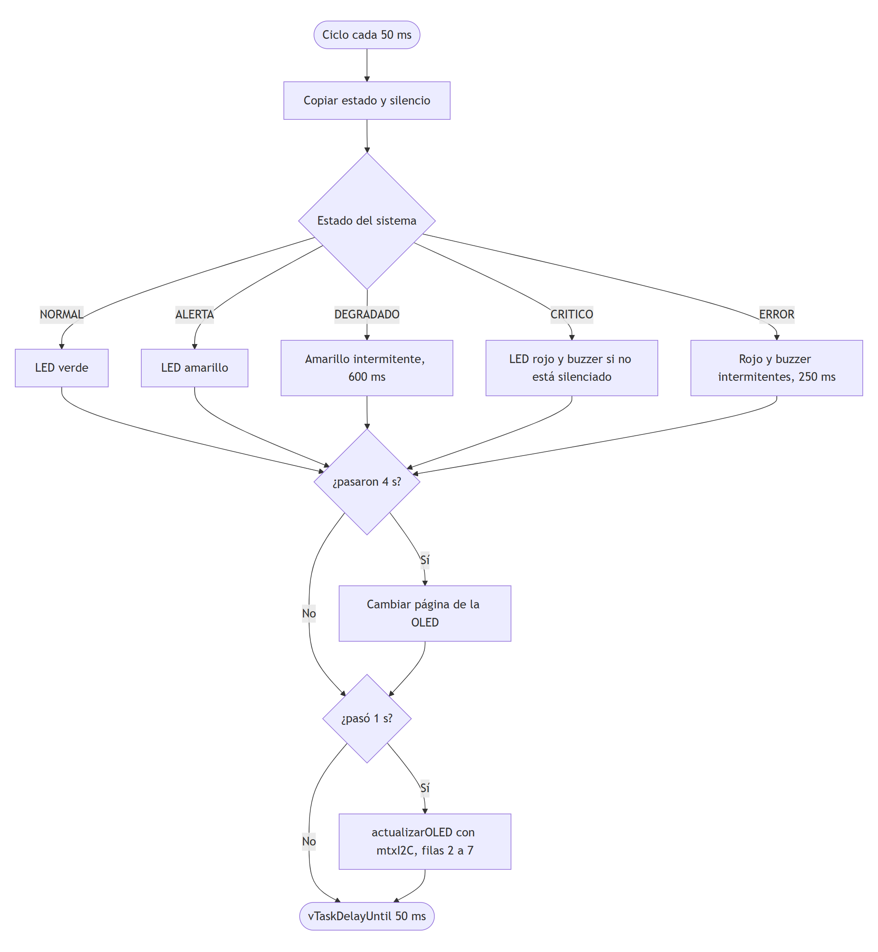
assets/diagramas/15-uml-actividad-tarea-salidas.png
