Juan100205/IOTPROYECTOFINAL3CORTE/assets/diagramas/16-uml-estados-sistema-alarma.png

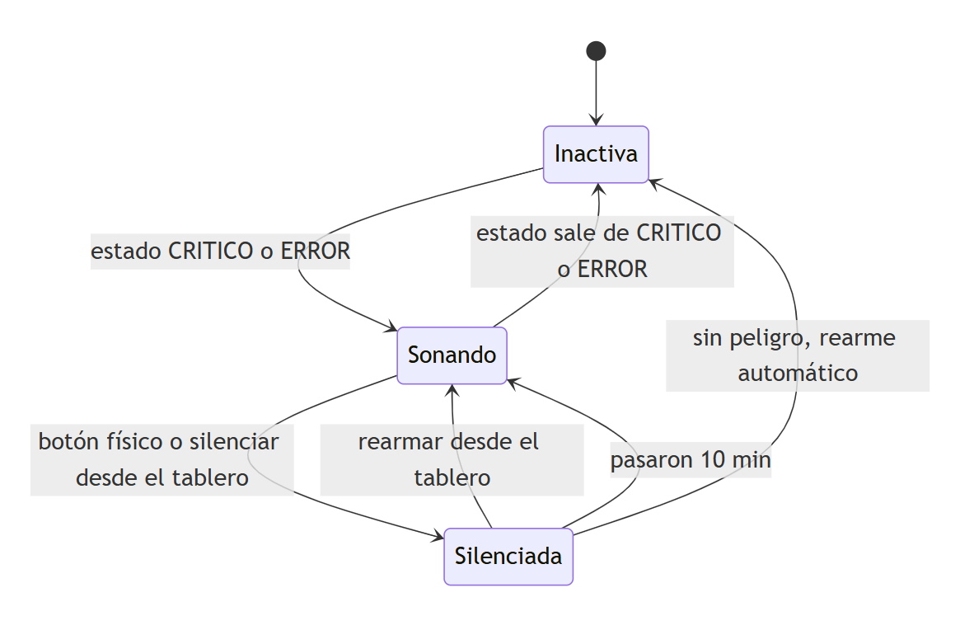
assets/diagramas/16-uml-estados-sistema-alarma.png
