Juan100205/IOTPROYECTOFINAL3CORTE/assets/diagramas/17-uml-despliegue.png

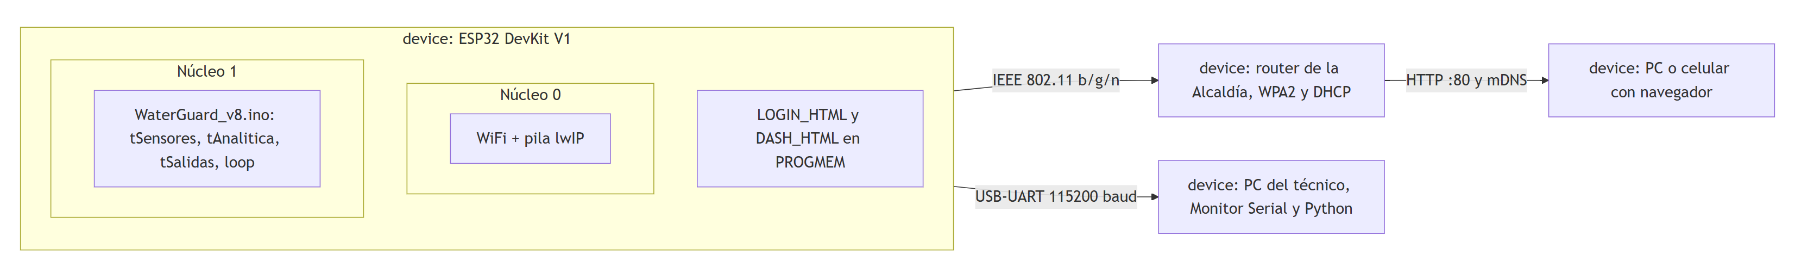
assets/diagramas/17-uml-despliegue.png
