Juan100205/IOTPROYECTOFINAL3CORTE/assets/diagramas/18-esquematico-conexion.png

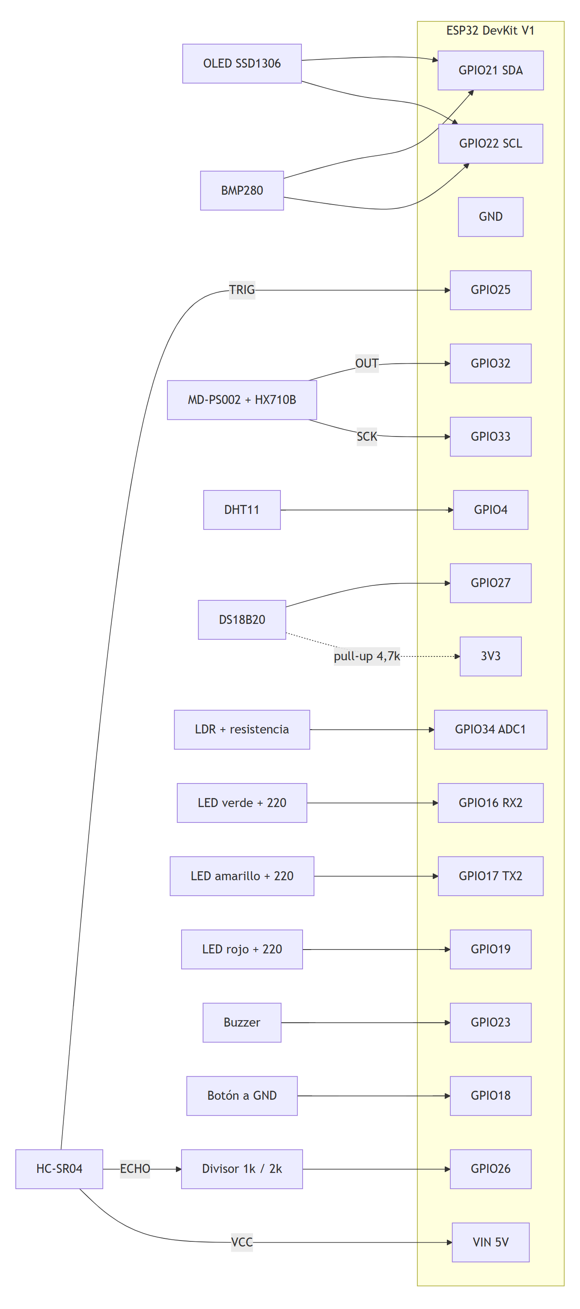
assets/diagramas/18-esquematico-conexion.png
