Juan100205/IOTPROYECTOFINAL3CORTE/diseno/carcasa-impresa-3d/WaterGuard_ESP32_partes.png

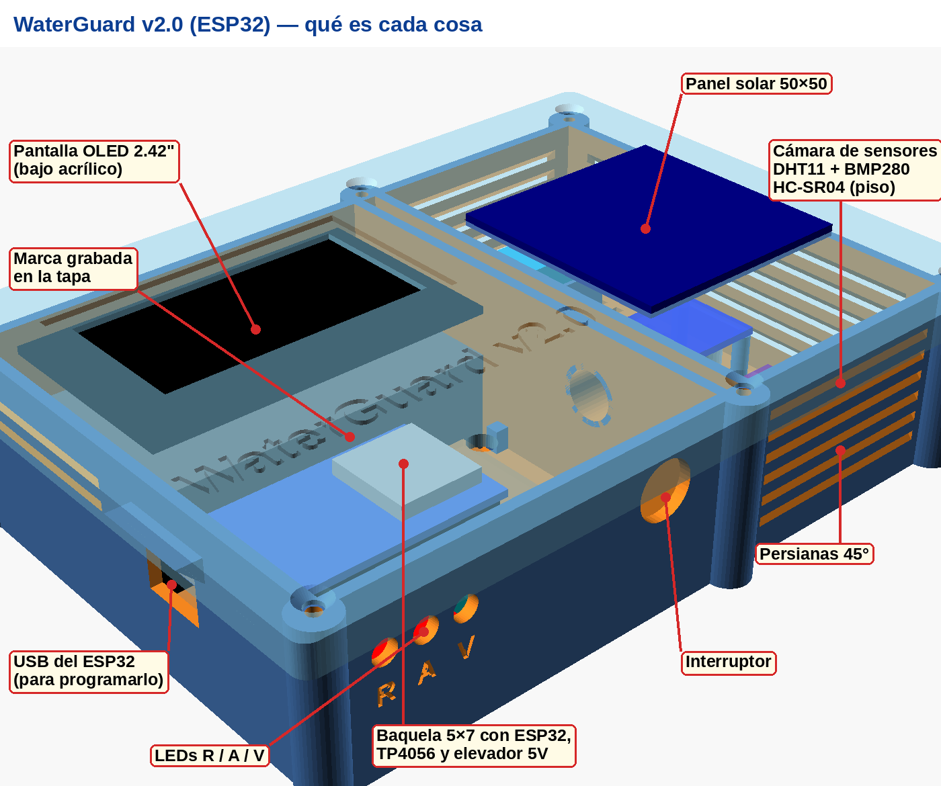
diseno/carcasa-impresa-3d/WaterGuard_ESP32_partes.png
