Juan100205/IOTPROYECTOFINAL3CORTE/diseno/carcasa-impresa-3d/WaterGuard_ADAPTADOR_OLED_096.stl

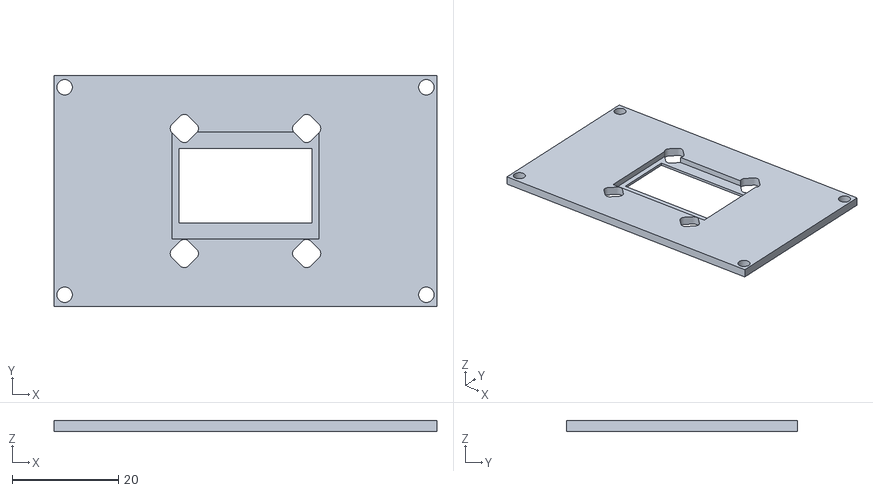
[picture p35: CAD file, 2026-11-10]
diseno/carcasa-impresa-3d/WaterGuard_ADAPTADOR_OLED_096.stl
72.0 x 43.5 x 2.00
