Juan100205/IOTPROYECTOFINAL3CORTE/diseno/carcasa-impresa-3d/WaterGuard_ESP32_BASE.stl

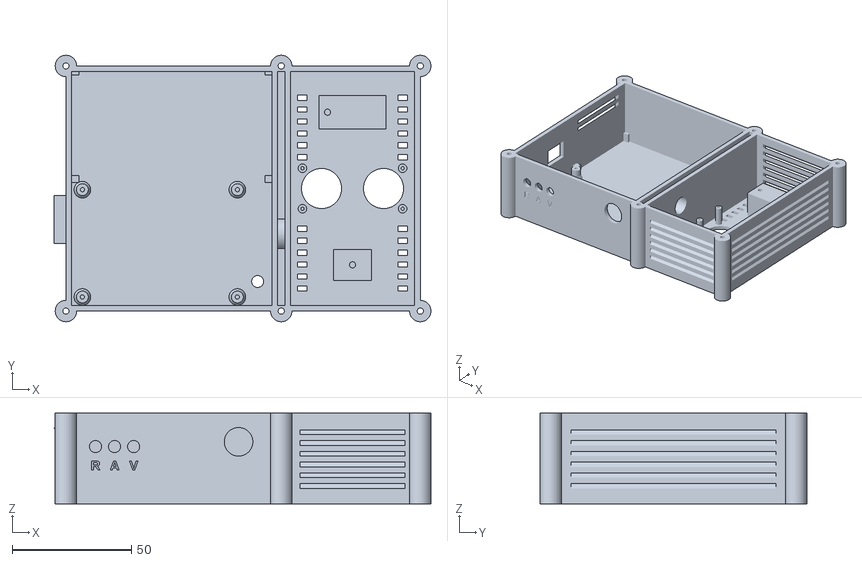
[picture p36: CAD file, 2026-11-10]
diseno/carcasa-impresa-3d/WaterGuard_ESP32_BASE.stl
158.1 x 111.8 x 38.0
