Juan100205/IOTPROYECTOFINAL3CORTE/diseno/carcasa-impresa-3d/WaterGuard_ESP32_TAPA.stl

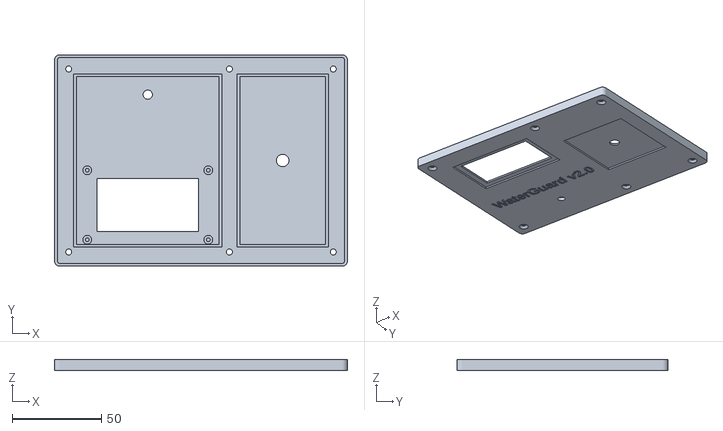
[picture p37: CAD file, 2026-11-10]
diseno/carcasa-impresa-3d/WaterGuard_ESP32_TAPA.stl
164.6 x 118.8 x 6.40
