Juan100205/IOTPROYECTOFINAL3CORTE/wiki/4.-Autoevaluación-del-Protocolo-de-Pruebas.md

# 4. Autoevaluación del protocolo de pruebas

## 4.0. Enfoque del Challenge #3: desarrollo guiado por pruebas (TDD) y aseguramiento de calidad

En el Challenge #3 el protocolo se construyó con **desarrollo guiado por pruebas** (*Test-Driven Development*, TDD) [58]: primero se escribe la prueba con su criterio de aceptación y después se implementa lo necesario para pasarla. El punto de partida fueron los requisitos del enunciado (R1–R13, [sección 0.3](0.-Plan-del-Challenge-3)). Cada requisito se convirtió en uno o más casos de prueba, y esos casos formaron el plan de pruebas y de QA. Así, el producto se valida contra lo que pide el reto y no solo contra lo que el equipo alcanzó a construir.

### 4.0.1. Trazabilidad requisito → prueba

| Req. | Requisito del enunciado | Prueba | Criterio de aceptación | Entorno |
|---|---|---|---|---|
| R1 | Medición y transmisión en ISR o hilos | P1. Telemetría con el tablero web cargado | El periodo de medición (500 ms) no se altera mientras `tMQTT` publica y el tablero atiende peticiones | Banco v2 |
| R2, R4 | MQTT nodo ↔ Gateway en Raspberry Pi | P2. Publicación y suscripción | Cada mensaje de `telemetria` llega a Mosquitto; pérdida por `seq` < 2 % en 10 min | Banco v2 + simulador de nodo |
| R3 | Datos almacenados en BD local antes de la nube | P3. Escritura verificada | Ningún dato aparece en la nube sin su registro en SQLite. Si se fuerza una falla de escritura, se emite la alerta crítica y no se publica | Gateway + inyección de fallas |
| R5 | MQTT Gateway ↔ nube | P4. Publicación con TLS | Los datos procesados llegan a LeMarTek Cloud por MQTT sobre WebSockets con TLS (puerto 443) | Gateway con Internet |
| R6 | Notificación in situ | P5. Estados en el nodo | LEDs, buzzer y OLED corresponden a cada estado, aunque el Gateway esté apagado | Banco v2 |
| R7 | Tablero local | P6. Tablero embebido | Valor actual, histórico y alertas visibles desde PC y celular en la WLAN | Banco v2 |
| R8 | Tablero global, solo usuarios autorizados | P7. Acceso remoto | El tablero de LeMarTek Cloud muestra los datos desde fuera de la WLAN; sin credenciales, no se accede | Internet |
| R9 | Notificaciones ante eventualidades | P8. Evento crítico | Una condición `CRITICO` genera notificación en el tablero global | Banco v2 (halógeno + vaciado) |
| R10 | Desactivar alarmas desde el tablero | P9. Silenciar desde los tres canales | El buzzer se apaga desde el botón, el tablero local y el tablero global, y los tres muestran el mismo estado | Banco v2 |
| R11 | Módulo de IA | P10. Recomendación | Ante un cambio de estado se genera una recomendación con las cifras reales del contexto. Sin Internet, se usa la de reglas | Gateway + simulador |
| — | Robustez | P11. Caídas | Al apagar el WiFi, el broker o Internet, el nodo sigue alertando y los datos se recuperan al reconectar (buffer y `seq`) | Inyección de fallas |

### 4.0.2. Fallas encontradas en el banco de pruebas y su solución

El banco de pruebas permitió **encontrar fallas reales y corregirlas** dentro de las posibilidades del equipo:

| Falla encontrada | Cómo se detectó | Solución aplicada |
|---|---|---|
| Lecturas erráticas e intermitentes del HC-SR04 y del DHT11 | Valores fuera de rango en el log CSV durante las corridas | Conteo de fallos por sensor (`MAX_FALLOS`), mediana de tres disparos del HC-SR04 y estado `DEGRADADO` |
| El módulo comprado como BME280 era un BMP280, sin humedad | El escaneo del bus I2C y la ausencia de lectura de humedad | La humedad queda a cargo del DHT11; el BMP280 se detecta solo y es opcional |
| Dos filas dañadas en la pantalla OLED | Inspección visual en el banco | La información se redistribuyó en las seis filas útiles |
| La primera prueba en reposo no generaba variabilidad | Prueba 1 demasiado uniforme para el detector de anomalías y K-Means | Se diseñó la Prueba 2 con perturbaciones controladas (bloqueo de sensor, calentamiento y bloqueo de luz) |
| Lecturas no repetibles del nivel al mover el montaje | Diferencias entre corridas con el mismo nivel | Soporte fijo de la carcasa en el banco v2, con el HC-SR04 siempre a la misma distancia del agua ([3.1.1](3.-Configuración-Experimental,-Resultados-y-Análisis)) |

### 4.0.3. Pruebas automatizadas

La prueba P3 se automatizó en [`codigo/gateway/pruebas/prueba_alerta_bd.py`](https://github.com/Juan100205/IOTPROYECTOFINAL3CORTE/blob/main/codigo/gateway/pruebas/prueba_alerta_bd.py) y está **superada** (resultados en la [sección 3.5](3.-Configuración-Experimental,-Resultados-y-Análisis)). El simulador de nodo ([`simulador_nodo.py`](https://github.com/Juan100205/IOTPROYECTOFINAL3CORTE/blob/main/codigo/gateway/simulador_nodo.py)) publica los mismos tópicos y JSON que el firmware y lleva el estado de `NORMAL` a `ALERTA` y a `CRITICO`, lo que permite ejecutar P2, P8, P9 y P10 sin hardware.

### 4.0.4. Autoevaluación

- **Fortaleza:** escribir las pruebas antes de implementar dio estructura al trabajo. Cada componente del ecosistema tiene un criterio de aceptación medible que sale del enunciado.
- **Fortaleza:** el banco de pruebas y los simuladores permiten repetir los mismos escenarios y probar cada capa por separado.
- **Por mejorar:** las pruebas de larga duración (horas) y la condición `CRITICO` sostenida en el banco siguen siendo las más difíciles de reproducir. Por eso se apoyan en el simulador de nodo.

## 4.1. Protocolo del nodo sensor

### Objetivo

Validar que la máquina de estados del nodo responde correctamente en operación normal, con degradación parcial de sensores, con falla total y en condición crítica sostenida. El protocolo también verifica los mecanismos contra falsos positivos (confirmación temporal e histéresis) y la detección de anomalías a partir del comportamiento reciente del sistema [7], [5].

La evidencia son las lecturas de los sensores, el estado interno de la máquina de estados y el registro CSV que emite el firmware.

### Requisitos y casos de uso

| ID | Requisito | Origen |
|---|---|---|
| RF-01 | Clasificar el estado del sistema (`NORMAL`, `ALERTA`, `CRITICO`, `DEGRADADO`, `ERROR`) | Lógica de fusión del enunciado |
| RF-02 | Alarma física y visualización en tiempo real en el dispositivo | Enunciado, restricción 3 |
| RF-03 | Detectar tasas anómalas de descenso del nivel | Enunciado, contexto del reto |
| RF-04 | Registrar los datos para el análisis offline | Analítica de datos |
| RNF-01 | Evitar falsos positivos: confirmación temporal e histéresis | Robustez de las alertas |
| RNF-02 | Tolerar fallas de sensores sin perder el servicio | Robustez del servicio |

| Caso de uso | Actor | Descripción |
|---|---|---|
| **CU-01** Vigilar el punto de almacenamiento | Autoridad local, comunidad | Ver el estado y las variables en el nodo y saber si hay riesgo |
| **CU-02** Recibir una alerta en el sitio | Comunidad, fontanero | Ver los LEDs y la OLED y oír el buzzer cuando el riesgo es alto |
| **CU-03** Operar con sensores fallando | Sistema | Seguir alertando con los sensores disponibles e informar la falla |
| **CU-04** Analizar los datos | Equipo técnico | Exportar el registro y estudiar patrones offline |

## 4.2. Casos de prueba diseñados

Estado: ✅ ejecutada · 🟡 parcial · ⬜ pendiente.

| ID | Requisito · caso de uso | Caso de prueba: cómo se provoca | Resultado esperado | Resultado obtenido | Estado |
|---|---|---|---|---|---|
| CP-01 | RF-01 · CU-01 | Operación normal con todos los sensores bien: nivel medio, temperatura y humedad normales | `NORMAL`, LED verde fijo y sin sonido | Prueba 1 (102 muestras, ~214 s): nivel ~53 %, IRH = 0 durante toda la captura y `NORMAL` en la pantalla (Figura 3) | ✅ |
| CP-02 | RNF-01 · CU-02 | Pico corto: una sola lectura de nivel muy baja o muy alta | No pasa a `CRITICO` de inmediato; queda en `ALERTA` mientras se confirma | En la Prueba 2 el IRH llegó a 31,32 (cruzó `ALERTA`) solo en la última muestra, sin sostenerse. Falta un pico aislado y controlado | 🟡 |
| CP-03 | RF-02 · CU-02 | Condición crítica sostenida más de `TIEMPO_CONFIRMACION_CRITICO` (5 s) | `CRITICO`: LED rojo fijo y buzzer continuo | El IRH máximo observado fue 31,32, lejos del umbral de 70 | ⬜ |
| CP-04 | RNF-01 · CU-02 | Bajar el IRH poco a poco después de estar en `CRITICO` | No sale de `CRITICO` hasta cruzar `UMBRAL_SALIDA_CRITICO` (60) | Depende de CP-03 | ⬜ |
| CP-05 | RNF-02 · CU-03 | Falla intermitente: desconectar y reconectar rápido el HC-SR04 o el DHT11 | No declara el sensor caído por 1 o 2 fallos aislados | En la Prueba 2 (t = 17–22 s) hubo dos lecturas bajas (48,45 %) antes de marcar el sensor caído; el log no permite saber si fueron toleradas | 🟡 |
| CP-06 | RNF-02 · CU-03 | Falla sostenida: desconectar el HC-SR04 más de 3 ciclos | `hcOK = false`, el sensor sale del IRH y el estado pasa a `DEGRADADO` | Prueba 2 (t = 22–36 s): nivel sin dato durante 7 muestras (~14 s), coherente con `MAX_FALLOS` y `DEGRADADO` | ✅ |
| CP-07 | RF-01 · CU-03 | Desconectar a la vez el HC-SR04, el DHT11 y el DS18B20 | `ERROR`: pantalla de error, buzzer intermitente (250 ms) y LED rojo parpadeando | Solo se probó la falla aislada del HC-SR04 | ⬜ |
| CP-08 | RNF-02 · CU-03 | Reconectar al menos un sensor después de CP-07 | Sale de `ERROR` y vuelve a `DEGRADADO` o `NORMAL` | Se validó la recuperación tras la falla de un sensor (t = 39 s); falta desde una falla total | 🟡 |
| CP-09 | RF-03 · CU-02 | Descenso del nivel más rápido que en las últimas 10 lecturas, sin cruzar el umbral de alerta | Aumenta `anomalias` y el IRH supera al IRH base | Dos activaciones (t ≈ 73 s y 96 s), con IRH = IRH base + 5 × anomalías verificado contra el firmware | ✅ |
| CP-10 | RF-03 · CU-01 | Mantener el sistema estable después de CP-09 | El contador de anomalías baja poco a poco | Entre t = 75 s y 77 s bajó de 1 a 0. No se observó con un conteo mayor que 1 | 🟡 |
| CP-11 | RF-02 · CU-01 | Recorrer todos los estados | Cada estado muestra su información en la OLED | Foto de la OLED solo en `NORMAL` (Figura 3); `DEGRADADO` y `ALERTA` confirmados en el CSV | 🟡 |
| CP-12 | RF-04 · CU-04 | Dejar el sistema funcionando un periodo largo | La línea `LOG,...` produce un CSV continuo y utilizable | Los dos registros (102 y 44 muestras) salieron limpios y se usaron en la sección 3; la duración máxima fue de ~3,6 min | ✅ |

### Limitaciones reconocidas

- El DS18B20 y la fotorresistencia ya están conectados y se validaron en la Prueba 2.
- Los casos que dependen de llegar a `CRITICO` (CP-03 y CP-04) y de una falla total (CP-07 y CP-08) siguen pendientes. Su protocolo está definido en la sección 3: mantener nivel bajo y temperatura alta el tiempo suficiente para superar el umbral y los 5 s de confirmación. En la v9 también se pueden provocar con el simulador de nodo ([4.0.3](#403-pruebas-automatizadas)).
- Falta una prueba de larga duración (varias horas) con condiciones ambientales naturales.
- Falta la evidencia fotográfica de la OLED en estados distintos de `NORMAL`.

Los casos propios de la v8 (tablero, seguridad y redundancia del nivel) están en la [sección 3.3](3.-Configuración-Experimental,-Resultados-y-Análisis). Referencias en la [lista unificada](Referencias).
