Juan100205/IOTPROYECTOFINAL3CORTE/diseno/carcasa-impresa-3d/plantilla_soporte_1a1.pdf

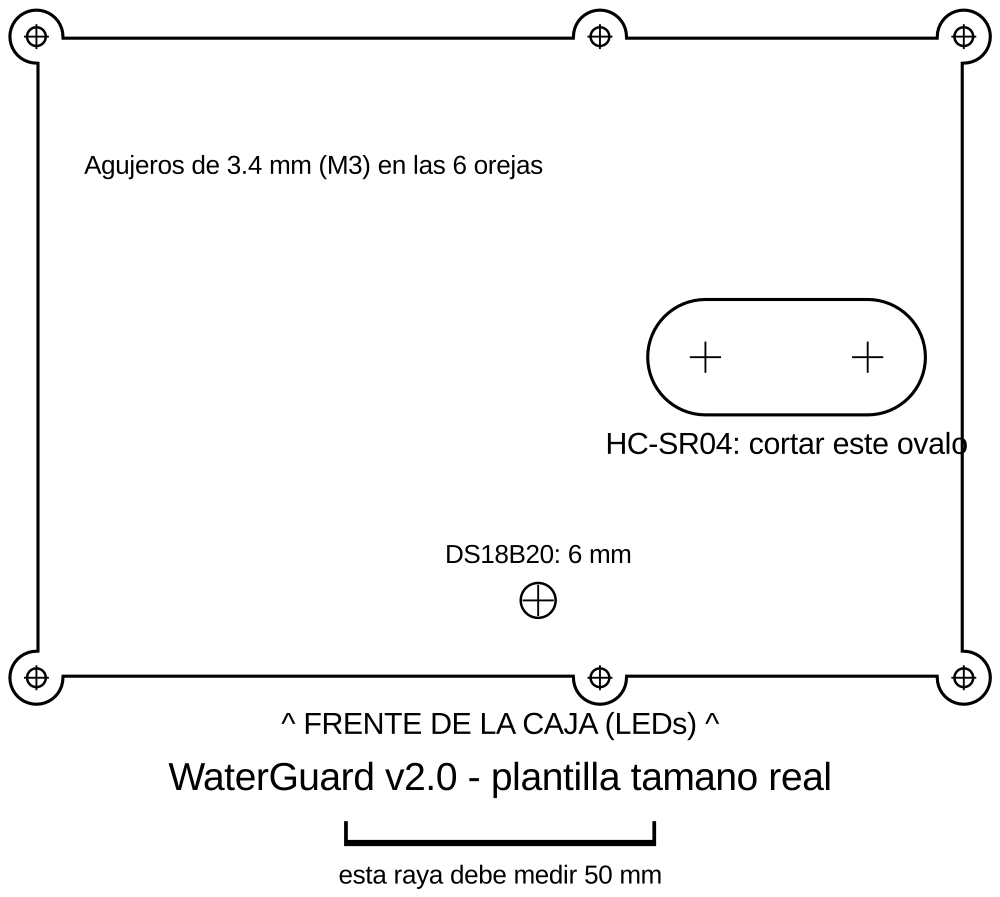
[picture p38: page 1]
