Juan100205/IOTPROYECTOFINAL3CORTE/diseno/carcasa-mdf/v2.0/plantilla-carcasa-v2.0.pdf

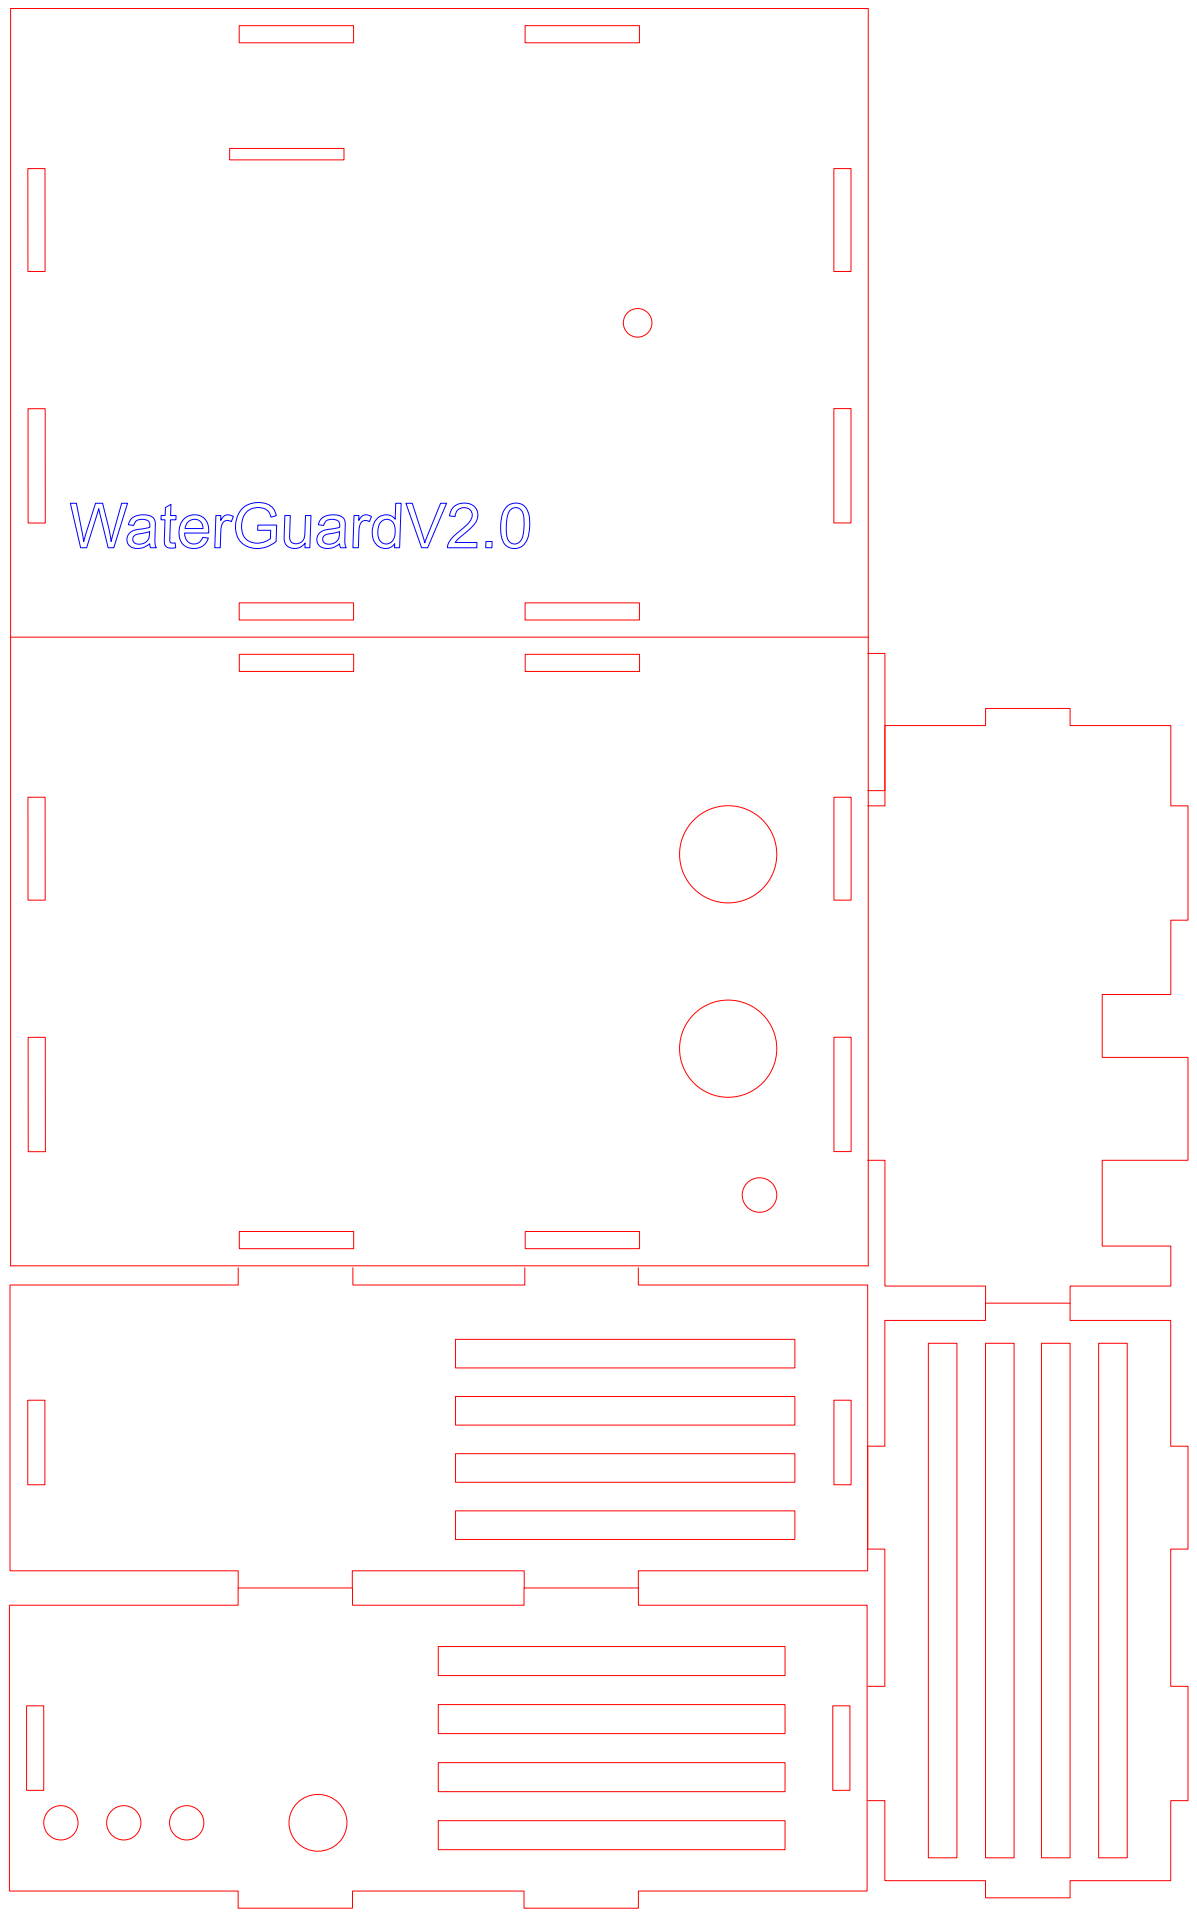
[picture p39: page 1]
