Juan100205/IOTPROYECTOFINAL3CORTE/diseno/carcasa-mdf/v1/plantilla-carcasa-v1.pdf

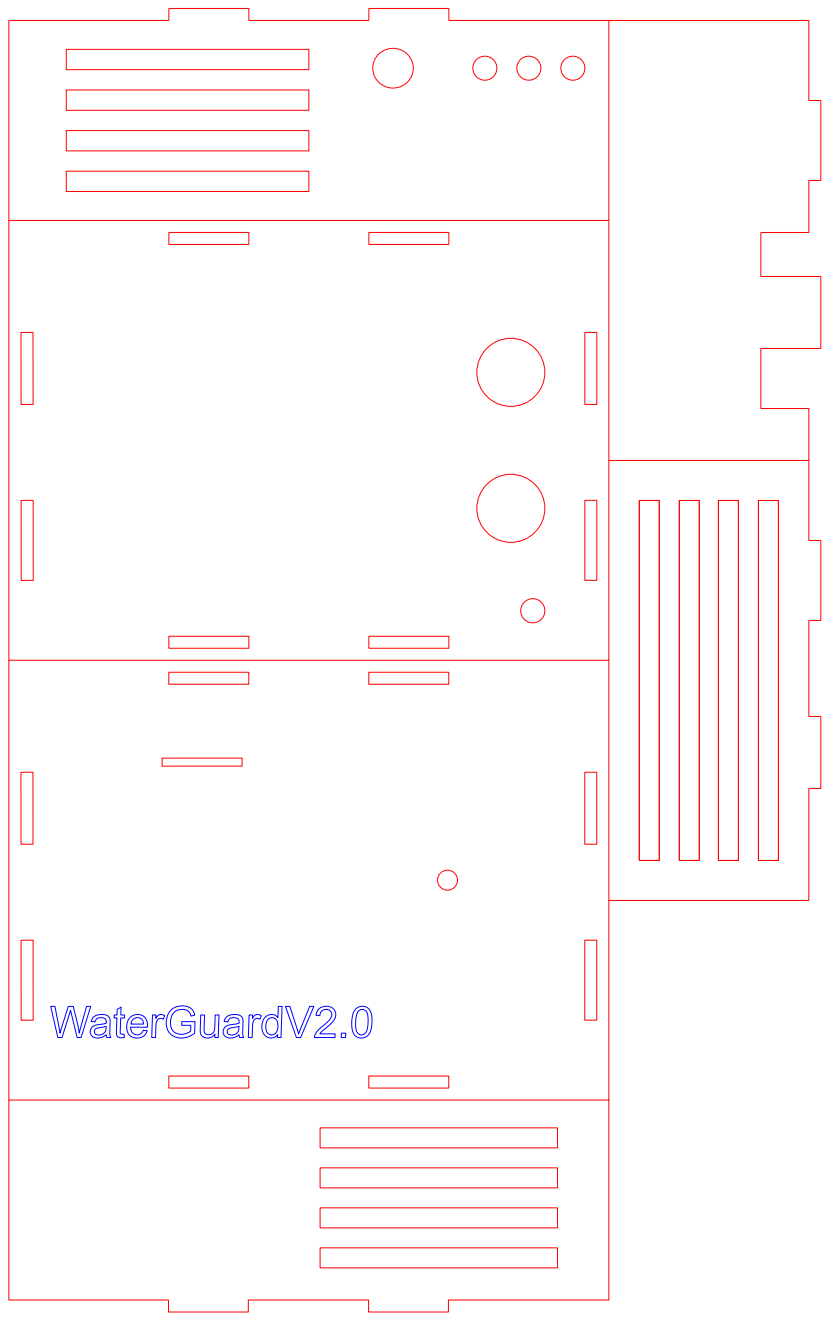
[picture p40: page 1]
