Juan100205/IOTPROYECTOFINAL3CORTE/(commit log)

2026-11-03 Wiki: plan del Challenge #3 (brecha v8->v9, decisiones, firmware ESP32 y cronograma)
2026-11-03 Wiki: actas de reunion y evaluacion (3, 7 y 10 nov)
2026-11-03 Wiki: fases, cronograma, lista de tareas y entregables por reunion (carcasa 3D, empaque, banco v2)
2026-11-03 Wiki: asignacion de tareas (Santiago: codigo y manufactura; Juan Jose: pruebas e integracion final)
2026-11-03 Actas en PDF (scripts/actas_a_pdf.py) y asignacion final: documentacion y logistica para ambos
2026-11-03 Quitar tarea de confirmar equipo de dos (T04)
2026-11-03 Raspberry Pi 5 definida, sin tareas de cuentas, actas con firma digital
2026-11-03 Impresion 3D de la carcasa (T23) a cargo de Juan Jose
2026-11-10 Organizacion de carpetas y diseno mecanico en MDF (carcasa, empaque, Acta #2)
    - assets/, codigo/ (v7, v8, scripts) y diseno/carcasa-mdf/ (plantillas v1 y v2.0)
    - Wiki 2.8: cambio de impresion 3D a MDF de 3 mm con corte laser, cotas, DFM y empaque
    - Acta #2 completa; costos con carcasa y empaque (COP 265.700)
    - Restricciones, estandares, banco v2, anexos, declaracion de IA y README actualizados
    - Bitacora de agentes en agentes-documentacion/
2026-11-10 Bitacora: cierre de la sesion del 9 nov
2026-11-10 Acta #2: fecha corregida a viernes 6 de noviembre
2026-11-10 Wiki v9: solucion propuesta departamental, arquitectura de tres capas, TDD, ideacion y Acta #3
2026-11-10 Modulo de IA: se ratifica la API de Claude
2026-11-10 Codigo v9 del Challenge #3 y README actualizado
    [WaterGuard_ADAPTADOR_OLED_096.stl, WaterGuard_ESP32_BASE.stl, WaterGuard_ESP32_TAPA.stl, adaptador_oled096.scad, soporte_tanque.scad, waterguard_esp32.scad]
2026-11-10 Se retira la configuracion de LeMarTek Cloud del repositorio
2026-11-10 Gateway: alerta critica por falla de SQLite con retencion ordenada; wiki y README alineados con lo construido (LeMarTek Cloud, topicos, carcasa MDF)
2026-11-10 Wiki: guion del video (seccion 8) y costos de produccion y precios de venta (2.7.4 y 2.7.5)
2026-11-10 Wiki: fuentes de leyes y normas, stack tecnologico, citas en formulas, fotos del montaje actual, casos de prueba rediseñados y seccion 9 reescrita
2026-11-10 Wiki: Gemini como herramienta de imagenes, cumplimiento 4 en actas, sin marcas de pendiente
2026-11-10 Assets: los 18 diagramas de la wiki en PNG (assets/diagramas) e indice en el Anexo H
2026-11-10 Video demostrativo (borrador 1) en docs/video y seccion 8 de la wiki con el video y sus capitulos
2026-11-10 Wiki: recuadro de enlaces publicos en la portada
